davixcky/medidor-energia-esp32/freecad/planta-banco-base.png

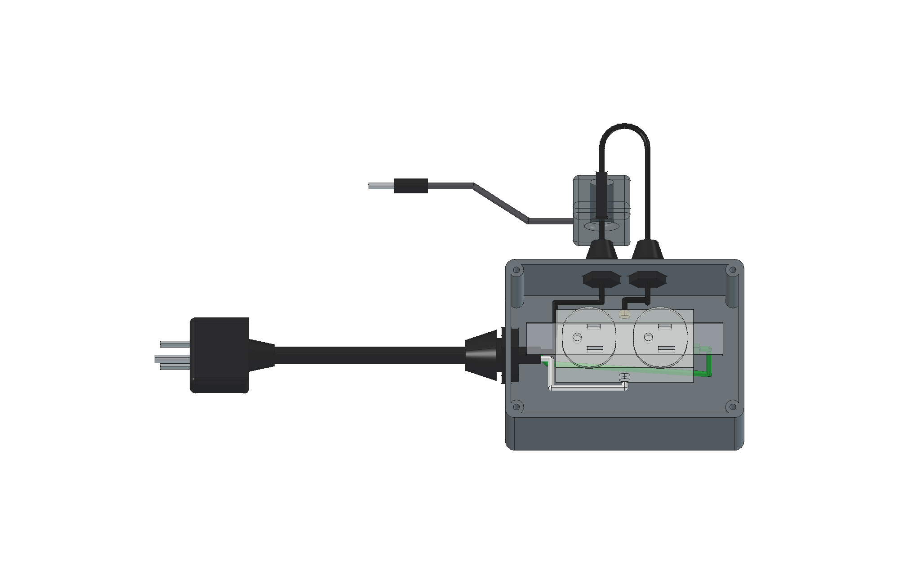
freecad/planta-banco-base.png
