davixcky/medidor-energia-esp32/freecad/revision-b/3d-medidor-abierto.png

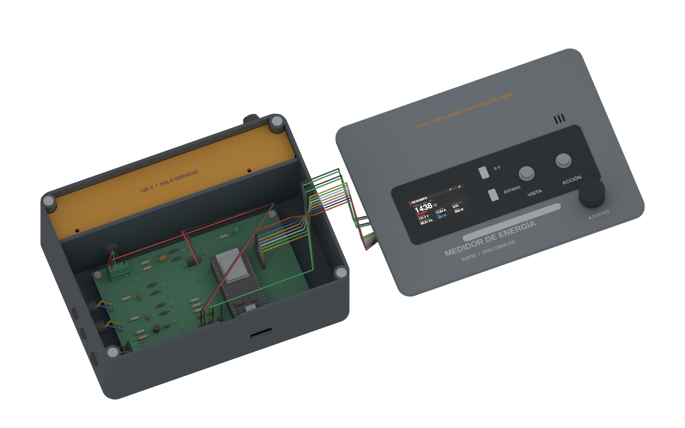
freecad/revision-b/3d-medidor-abierto.png
