davixcky/medidor-energia-esp32/img/lstm-ventanas.png

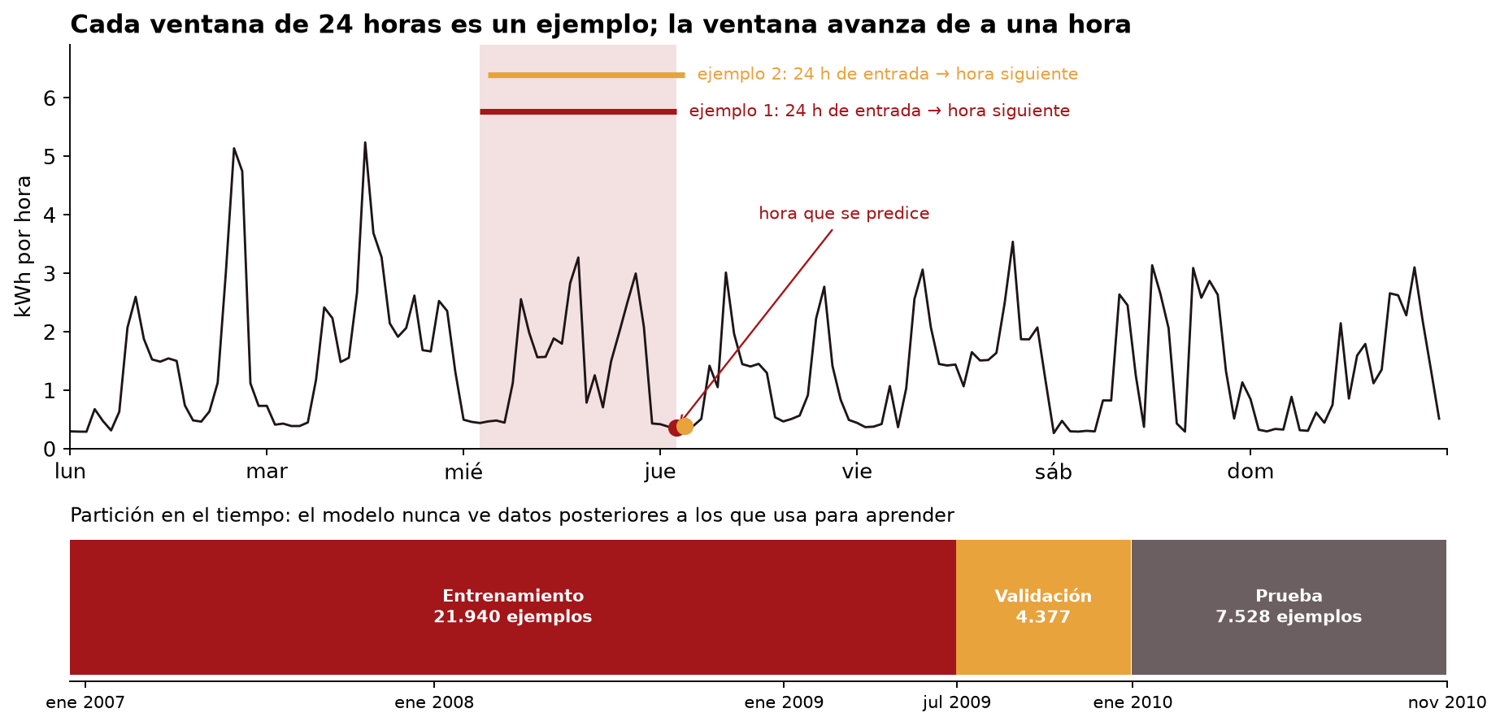
img/lstm-ventanas.png
