davixcky/medidor-energia-esp32/img/ui-lcd-alerta.png

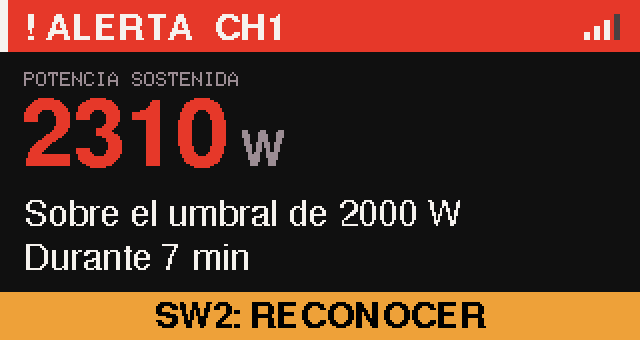
img/ui-lcd-alerta.png
