davixcky/medidor-energia-esp32/img/ui-lcd-arranque.png

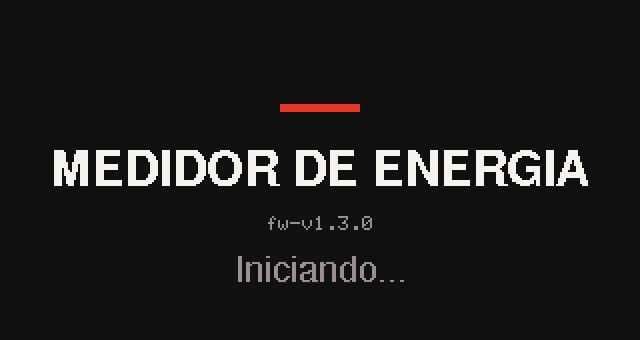
img/ui-lcd-arranque.png
