davixcky/medidor-energia-esp32/img/ui-lcd-ch1.png

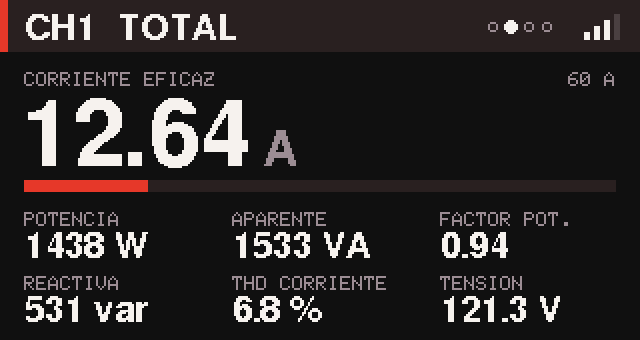
img/ui-lcd-ch1.png
