davixcky/medidor-energia-esp32/img/ui-lcd-ch2.png

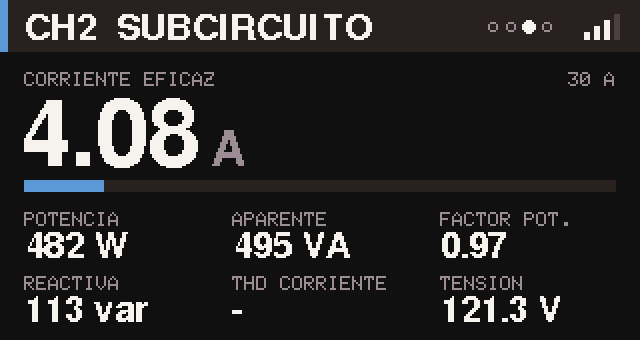
img/ui-lcd-ch2.png
