davixcky/medidor-energia-esp32/img/ui-lcd-energia.png

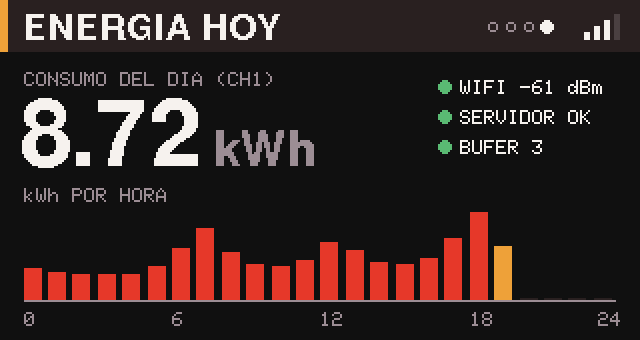
img/ui-lcd-energia.png
