davixcky/medidor-energia-esp32/img/ui-lcd-resumen.png

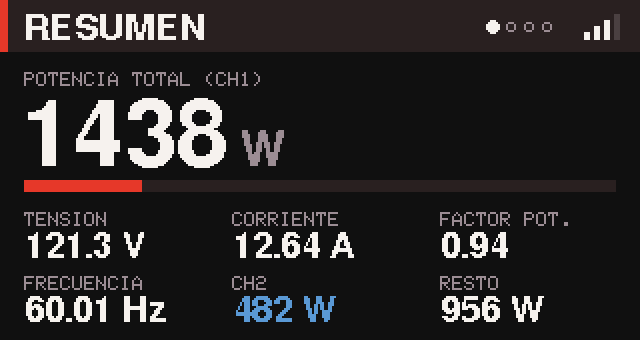
img/ui-lcd-resumen.png
