davixcky/medidor-energia-esp32/img/ui-lcd-tara.png

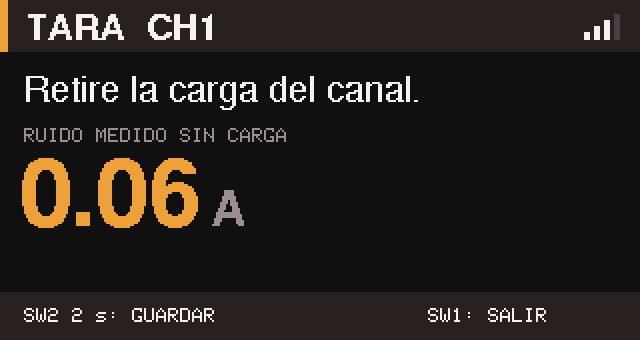
img/ui-lcd-tara.png
