davixcky/medidor-energia-esp32/img/ui-oled-navegacion.png

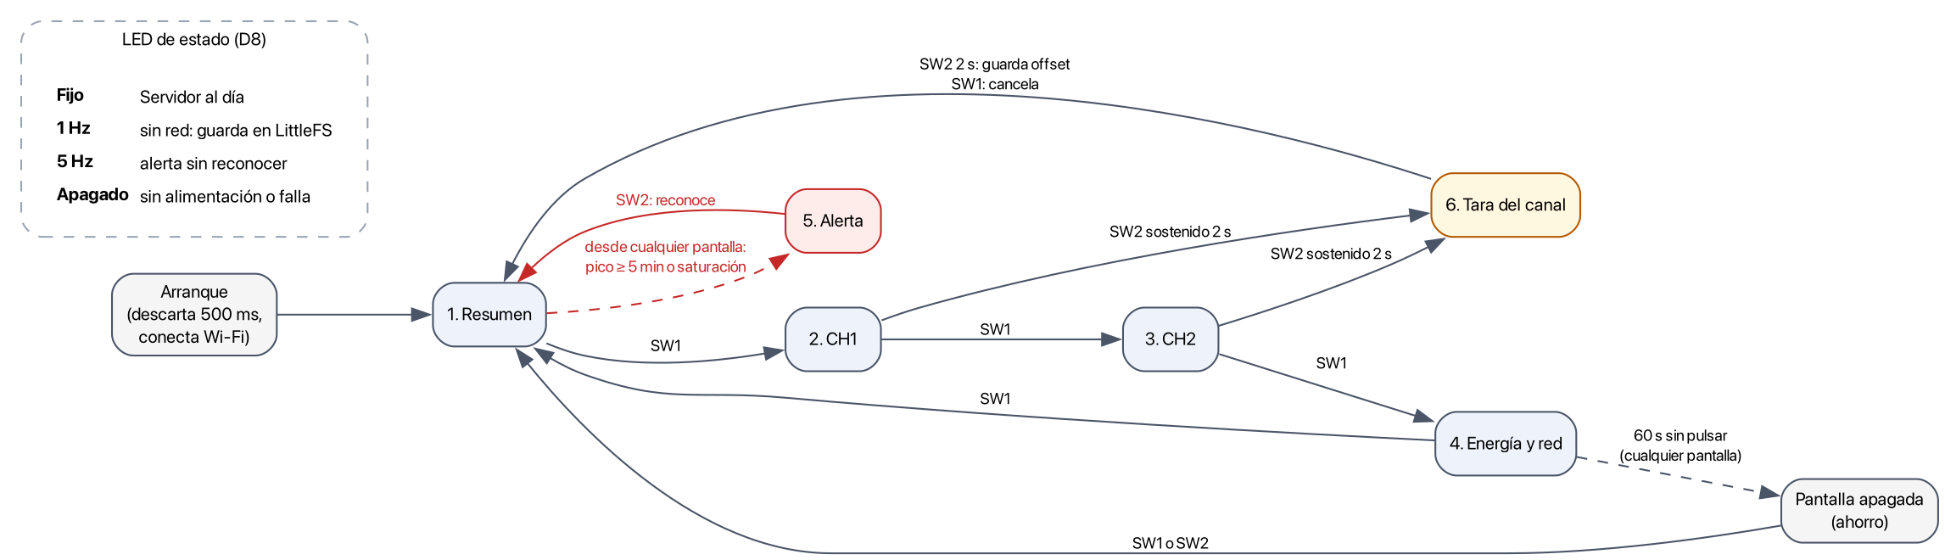
img/ui-oled-navegacion.png
