davixcky/medidor-energia-esp32/img/ui-oled-pantallas.png

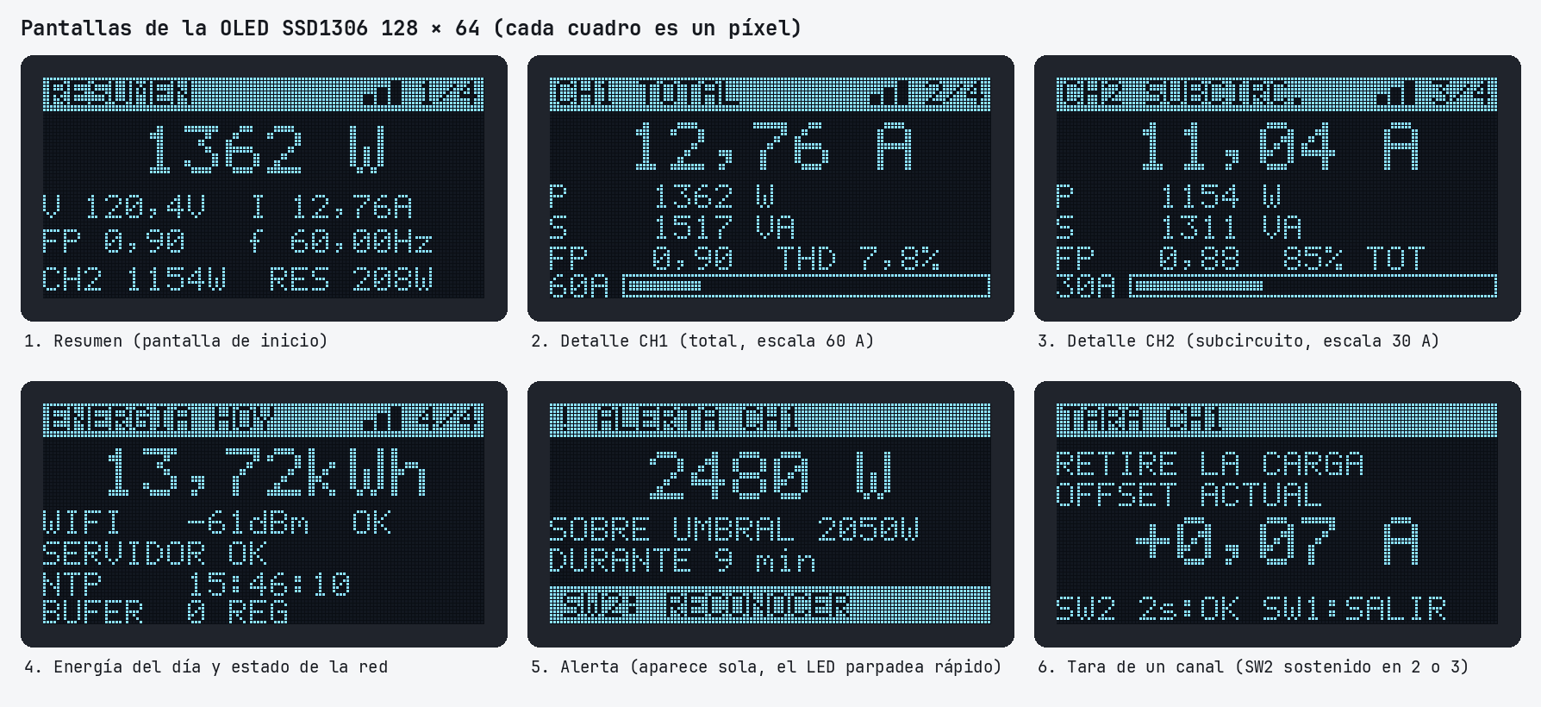
img/ui-oled-pantallas.png
