davixcky/medidor-energia-esp32/img/ui-tablero-oscuro.png

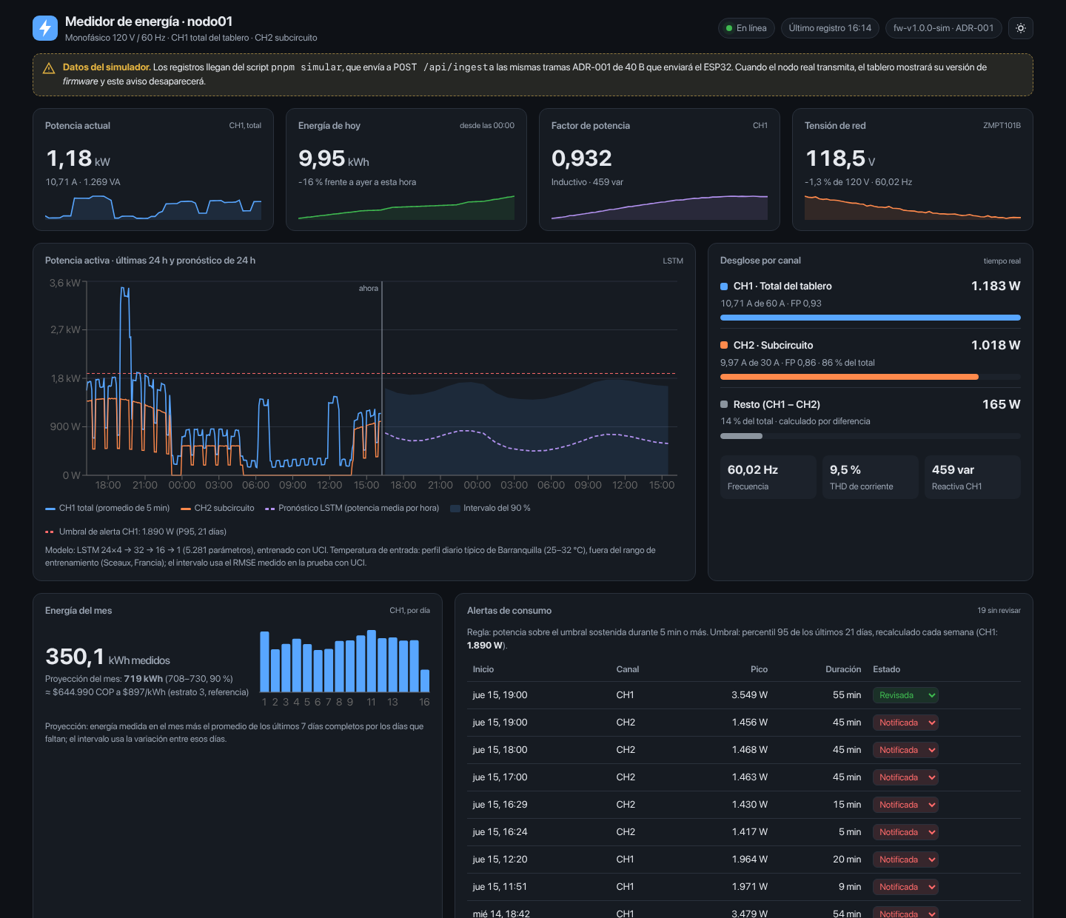
img/ui-tablero-oscuro.png
