davixcky/medidor-energia-esp32/video/revision-b/contacto-final.png

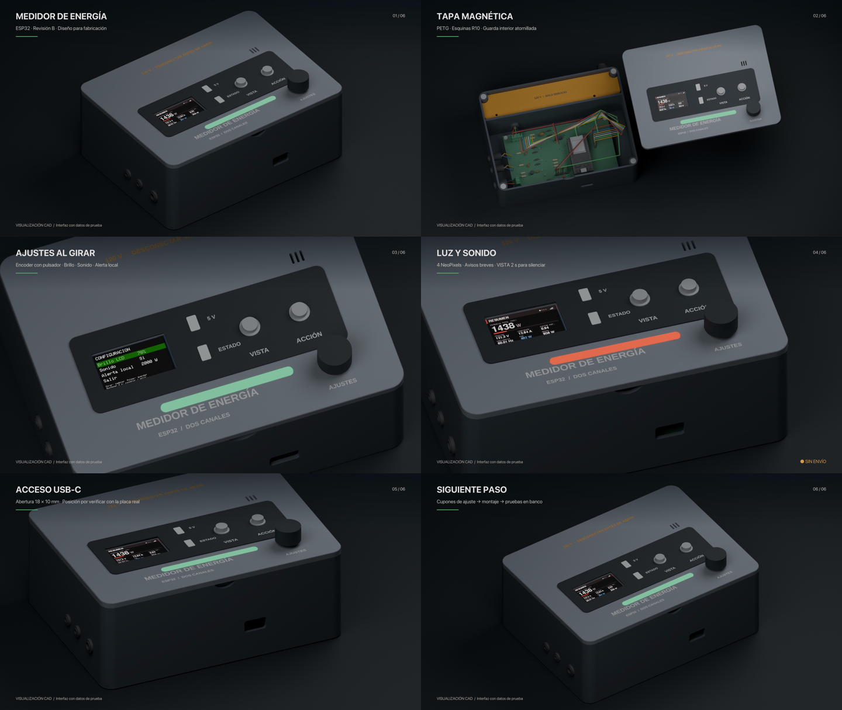
video/revision-b/contacto-final.png
