davixcky/medidor-energia-esp32/video/revision-b/sombra-titulos.png

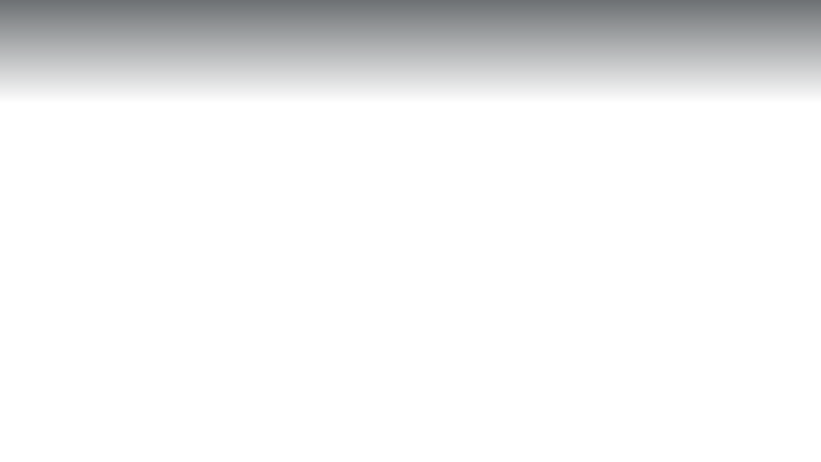
video/revision-b/sombra-titulos.png
