davixcky/medidor-energia-esp32/freecad/medidor.FCStd

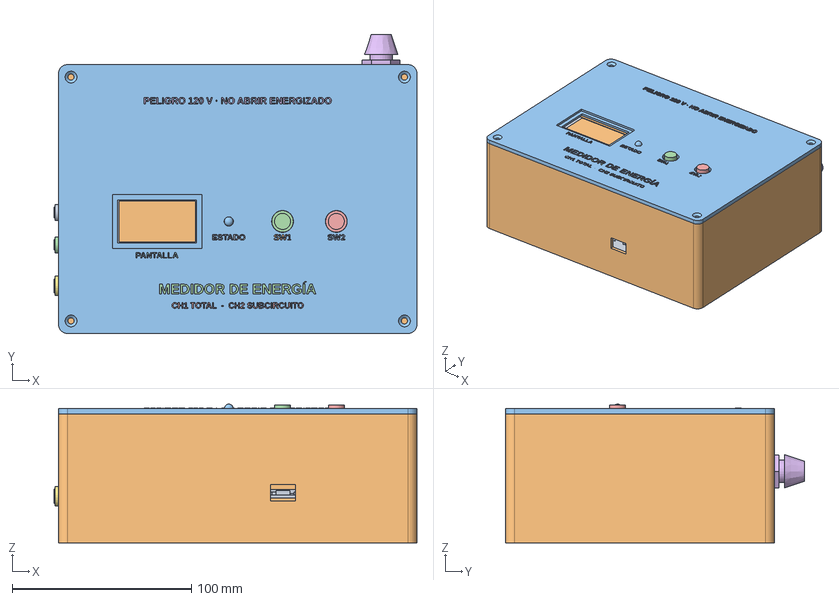
[picture p47: CAD file, 2026-10-24]
freecad/medidor.FCStd
202.5 x 166.8 x 77.5 mm
Placa_KiCad
Cuerpo
Tapa
Tornillo_ZMPT_0
Tornillo_ZMPT_1
Tornillo_ZMPT_2
Tornillo_ZMPT_3
ZMPT101B_PCB
ZMPT101B_trafo
ZMPT101B_bornes
ZMPT101B_pot
F1_portafusible
J4_bornera
PG7
Red_fase
Red_neutro
Red_fase_F1
Red_F1_ZMPT
Red_N_ZMPT
ZMPT_salida
Pasacables_tabique
ZMPT_J5_0
ZMPT_J5_1
ZMPT_J5_2
J2_CH1
Cable_J2_T
Cable_J2_S
J3_CH2
Cable_J3_T
Cable_J3_S
Jack_5V
Cable_J1_1
Cable_J1_2
Contacto_J1_1
Contacto_J1_2
Contacto_J5_1
Contacto_J5_2
Contacto_J5_3
Contacto_J6_1
Contacto_J6_2
Contacto_J6_3
Contacto_J6_4
Contacto_J6_5
Contacto_J6_6
Contacto_J6_7
Contacto_J6_8
Contacto_D8_1
Contacto_D8_2
Contacto_SW1_1
Contacto_SW1_2
Contacto_SW2_1
Contacto_SW2_2
Tornillo_placa_0
Tornillo_placa_1
Tornillo_placa_2
Tornillo_placa_3
LCD_modulo
LCD_pantalla
D8_LED
SW1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
