davixcky/medidor-energia-esp32/freecad/revision-b/stl/difusor-alimentacion.stl

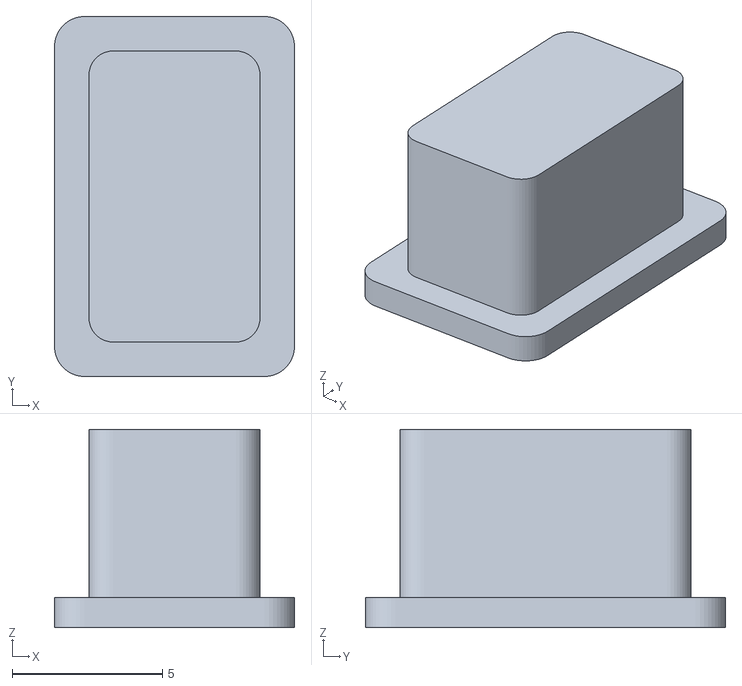
[picture p49: CAD file, 2026-10-23]
freecad/revision-b/stl/difusor-alimentacion.stl
8.00 x 12.0 x 6.60
