davixcky/medidor-energia-esp32/freecad/stl/medidor-tapa.stl

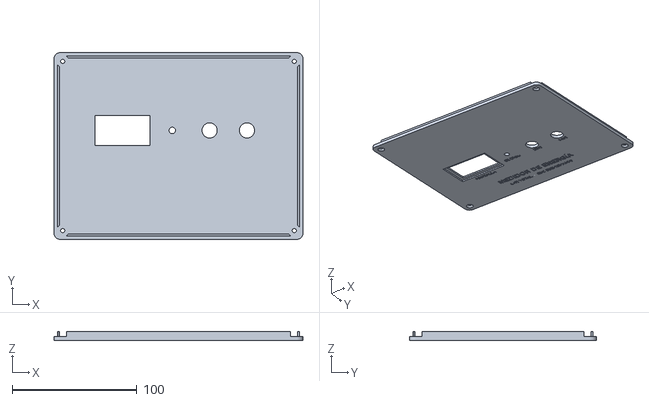
[picture p50: CAD file, 2026-10-22]
freecad/stl/medidor-tapa.stl
200.0 x 150.0 x 7.00
