davixcky/medidor-energia-esp32/hardware/3d/esp32-devkitc-v4.step

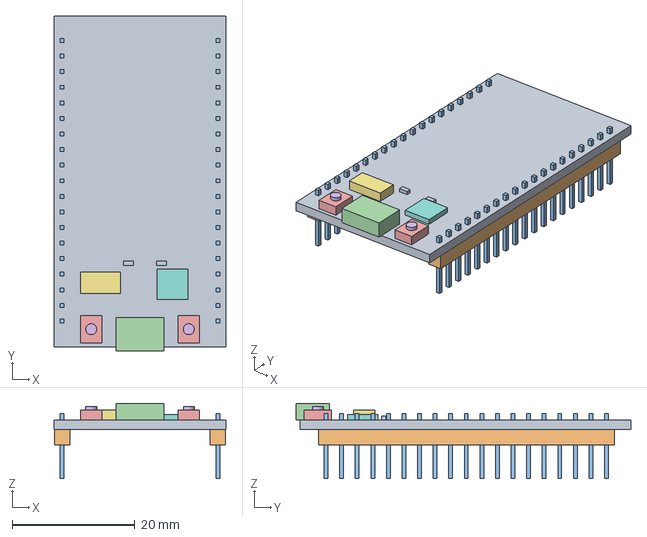
[picture p51: CAD file, 2026-10-16]
hardware/3d/esp32-devkitc-v4.step
28.0 x 54.6 x 12.3 mm
