davixcky/medidor-energia-esp32/freecad/banco.FCStd

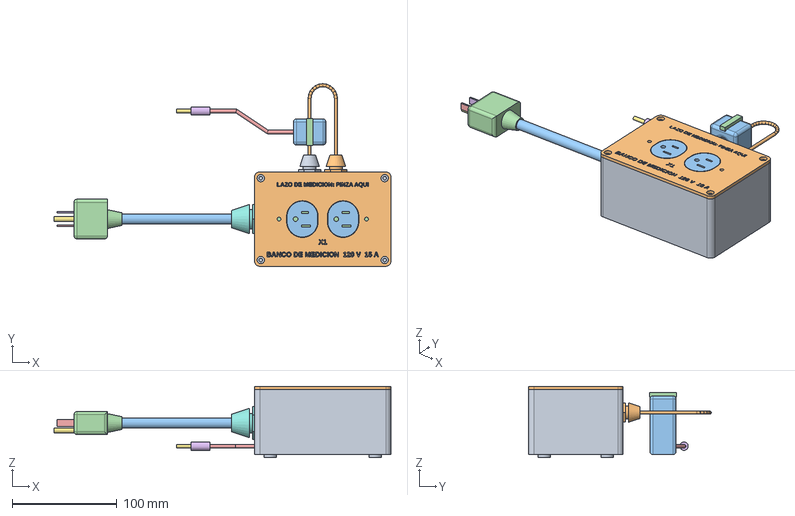
[picture p52: CAD file, 2026-10-24]
freecad/banco.FCStd
321.0 x 174.0 x 68.0 mm
Cuerpo
Tapa
X1_cuerpo
X1_yugo
X1_borne_fase
X1_borne_neutro
X1_borne_tierra
PG11
PG7_1
PG7_2
Cordon
P1_clavija
P1_pata_n
P1_pata_f
P1_pata_t
N_X1
PE_X1
L_lazo
CT1_pinza
CT1_cierre
CT1_cable
CT1_plug_cuerpo
CT1_plug_punta
