davixcky/medidor-energia-esp32/freecad/revision-b/stl/cuerpo.stl

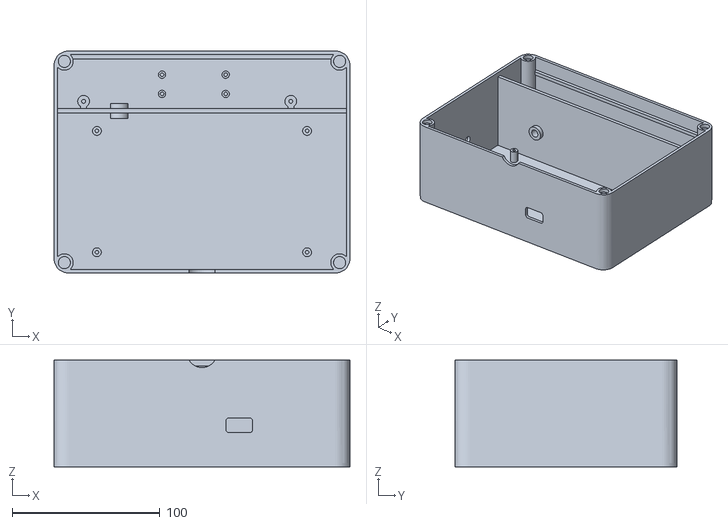
[picture p53: CAD file, 2026-10-23]
freecad/revision-b/stl/cuerpo.stl
200.0 x 150.0 x 72.0
