davixcky/medidor-energia-esp32/freecad/stl/banco-tapa.stl

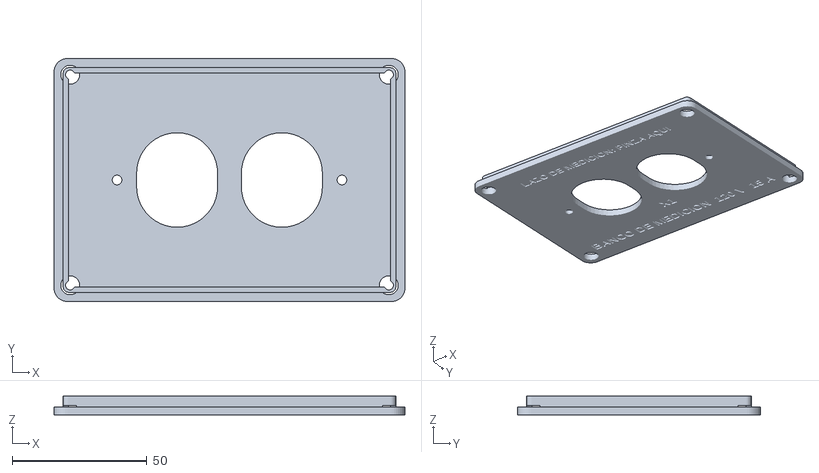
[picture p54: CAD file, 2026-10-21]
freecad/stl/banco-tapa.stl
130.0 x 90.0 x 7.00
