davixcky/medidor-energia-esp32/freecad/revision-b/stl/retenedor-lcd-i.stl

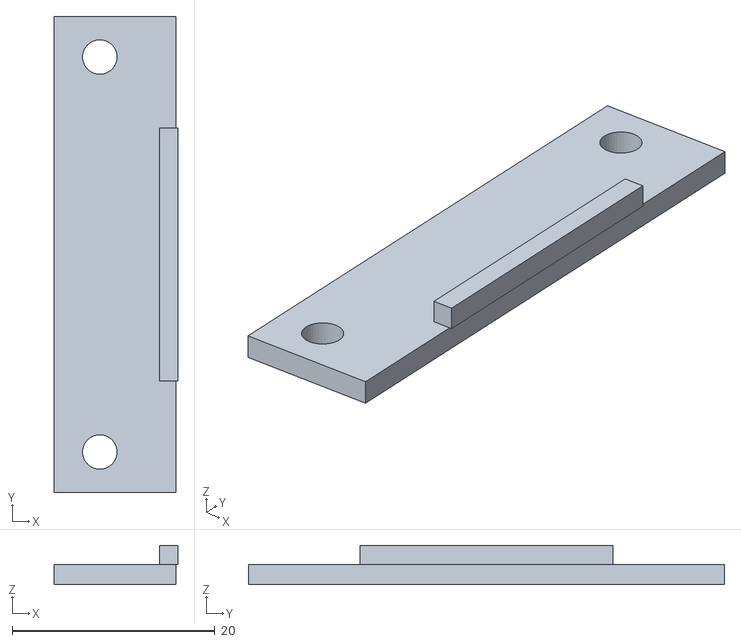
[picture p55: CAD file, 2026-10-23]
freecad/revision-b/stl/retenedor-lcd-i.stl
12.2 x 47.0 x 3.90
