davixcky/medidor-energia-esp32/freecad/stl/banco-cuerpo.stl

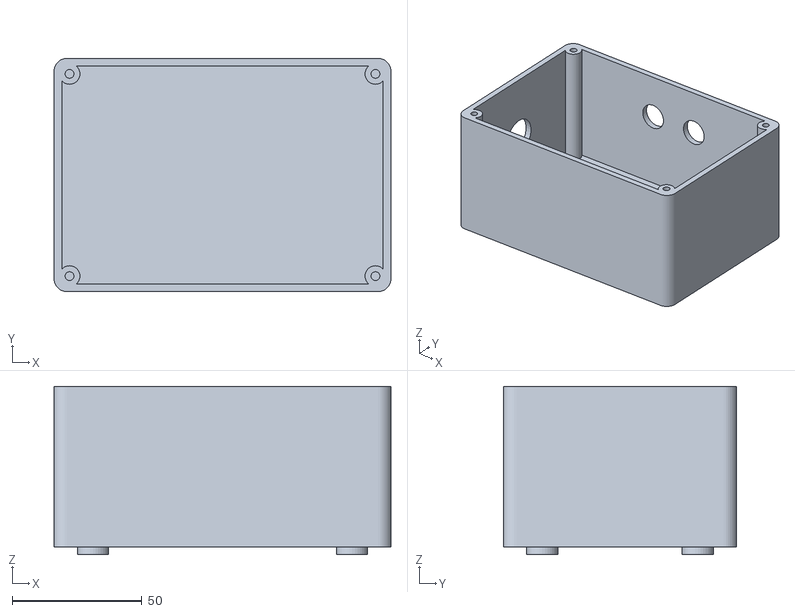
[picture p56: CAD file, 2026-10-16]
freecad/stl/banco-cuerpo.stl
130.0 x 90.0 x 65.0
