davixcky/medidor-energia-esp32/freecad/revision-b/stl/difusor-neopixel.stl

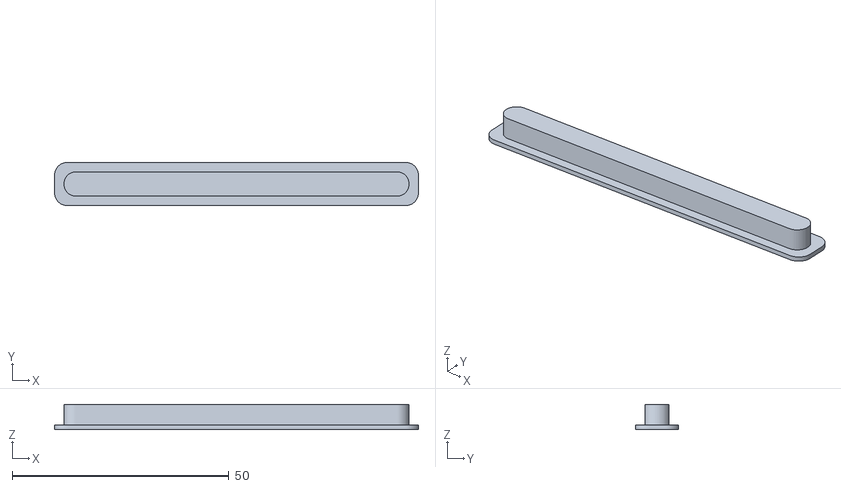
[picture p57: CAD file, 2026-10-23]
freecad/revision-b/stl/difusor-neopixel.stl
84.0 x 10.0 x 5.80
