davixcky/medidor-energia-esp32/freecad/revision-b/stl/porta-neopixel.stl

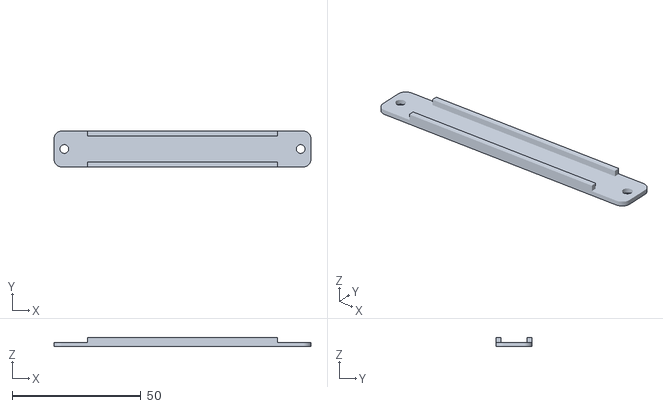
[picture p58: CAD file, 2026-10-23]
freecad/revision-b/stl/porta-neopixel.stl
100.0 x 14.0 x 3.60
