davixcky/medidor-energia-esp32/freecad/revision-b/stl/guarda-120v.stl

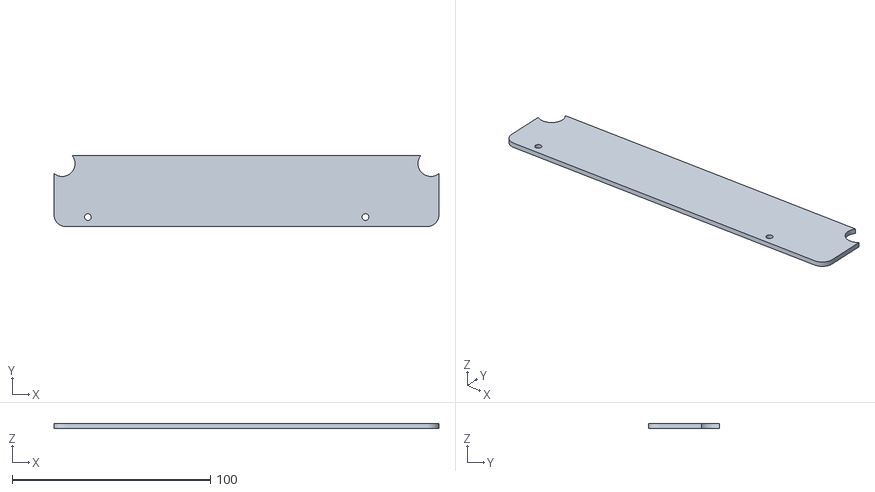
[picture p59: CAD file, 2026-10-23]
freecad/revision-b/stl/guarda-120v.stl
194.2 x 35.9 x 2.40
