davixcky/medidor-energia-esp32/freecad/revision-b/stl/tapa.stl

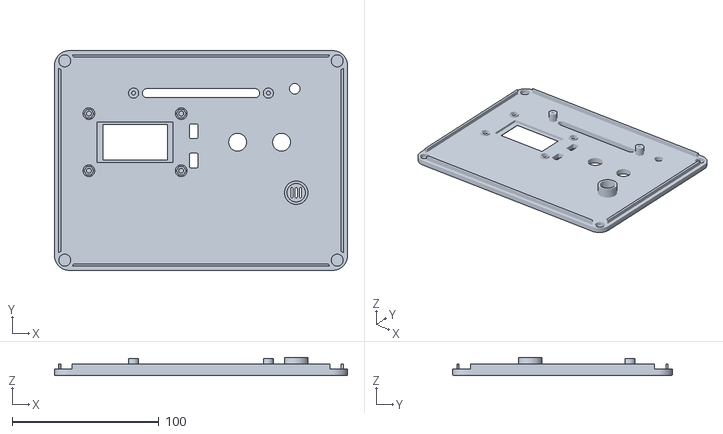
[picture p60: CAD file, 2026-10-23]
freecad/revision-b/stl/tapa.stl
200.0 x 150.0 x 12.6
