davixcky/medidor-energia-esp32/freecad/revision-b/stl/cupon-usbc.stl

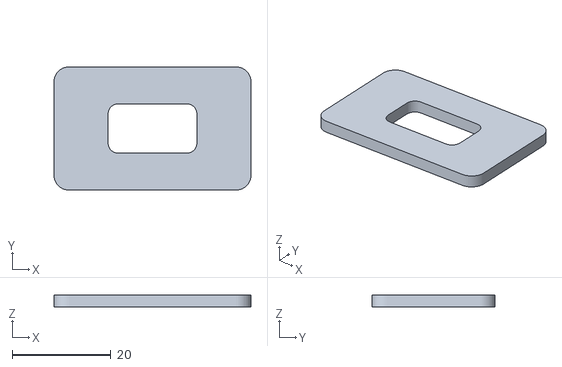
[picture p61: CAD file, 2026-10-23]
freecad/revision-b/stl/cupon-usbc.stl
40.0 x 25.0 x 2.50
