davixcky/medidor-energia-esp32/freecad/revision-b/stl/cupon-ajuste.stl

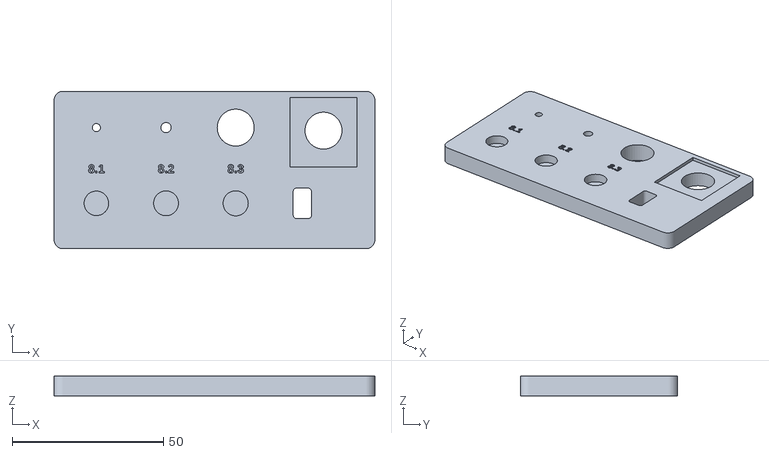
[picture p62: CAD file, 2026-10-23]
freecad/revision-b/stl/cupon-ajuste.stl
106.0 x 52.0 x 6.60
