davixcky/medidor-energia-esp32/freecad/revision-b/stl/panel.stl

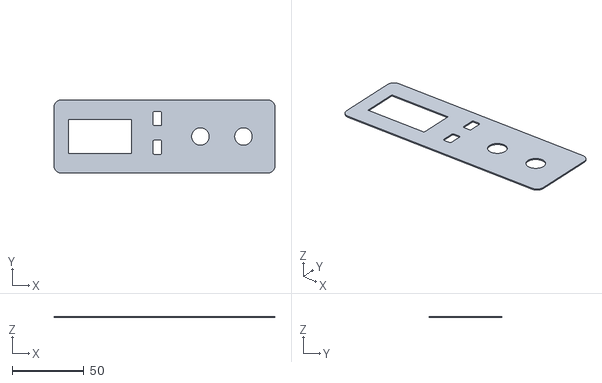
[picture p63: CAD file, 2026-10-23]
freecad/revision-b/stl/panel.stl
154.0 x 51.0 x 0.8
