davixcky/medidor-energia-esp32/freecad/revision-b/stl/retenedor-lcd-d.stl

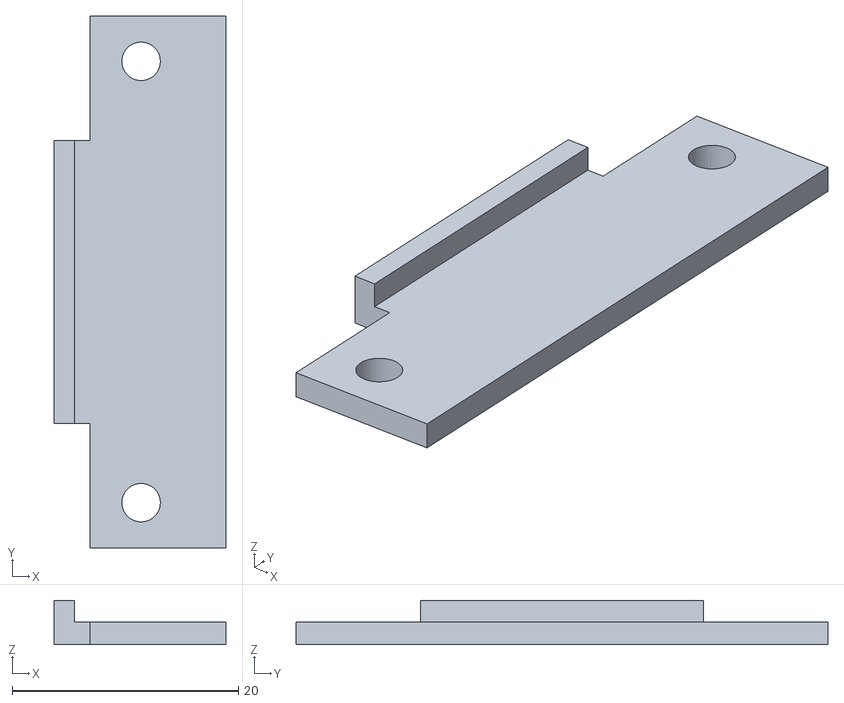
[picture p64: CAD file, 2026-10-23]
freecad/revision-b/stl/retenedor-lcd-d.stl
15.2 x 47.0 x 3.90
