davixcky/medidor-energia-esp32/freecad/revision-b/stl/cupon-encoder.stl

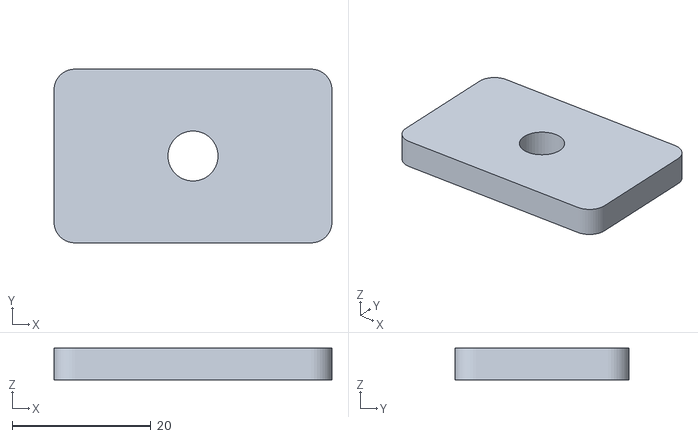
[picture p65: CAD file, 2026-10-23]
freecad/revision-b/stl/cupon-encoder.stl
40.0 x 25.0 x 4.60
