davixcky/medidor-energia-esp32/(list of files, cad)

Other CAD files:
freecad/stl/medidor-cuerpo.stl
freecad/revision-b/stl/difusor-estado.stl
