davixcky/medidor-energia-esp32/hardware/fabricacion/vista-toner.png

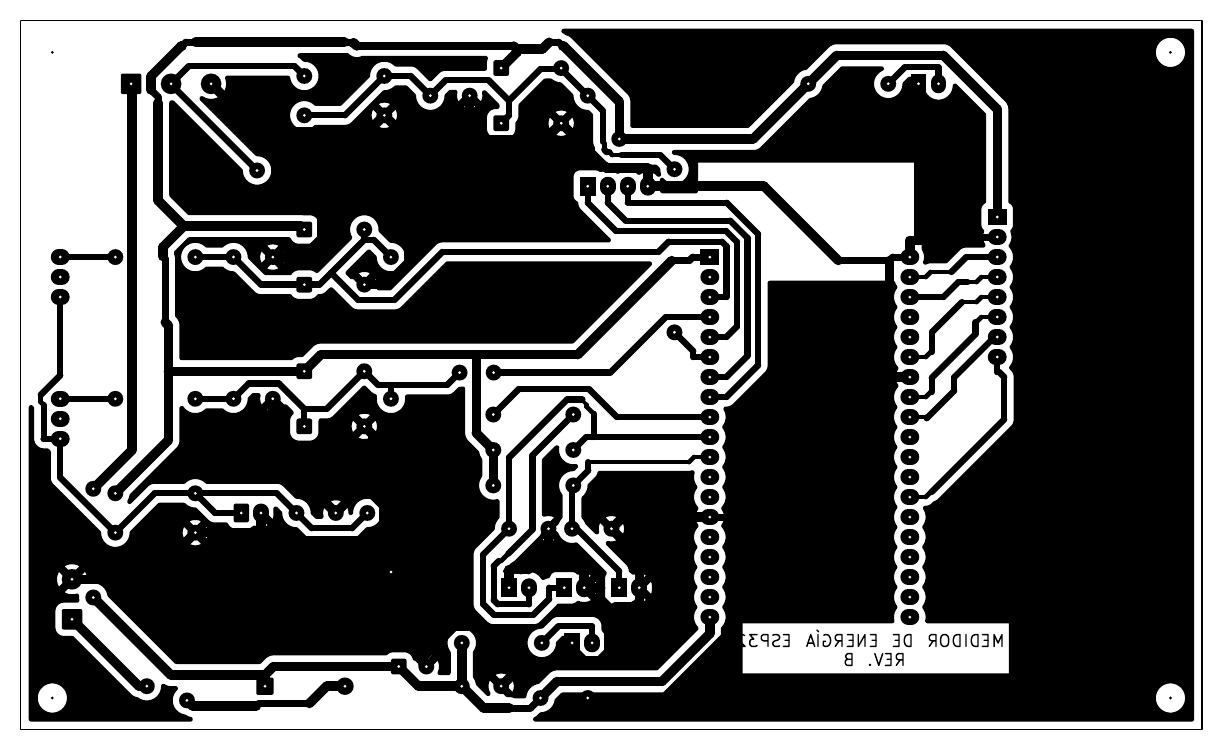
hardware/fabricacion/vista-toner.png
