davixcky/medidor-energia-esp32/hardware/banco-pruebas.pdf

1 | 2 | 3 | 4 | 5 | 6

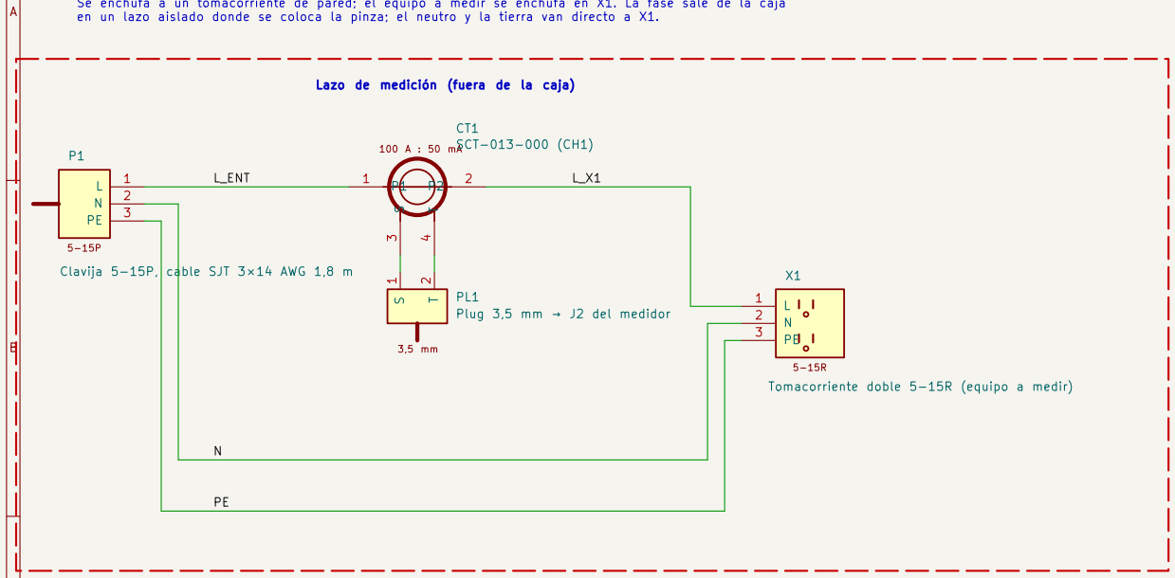
[picture p67: figure]
SCT-013-000 (CH1); T 2 PL1 Plug 3,5 mm → J2 del medidor N

1 | 2 | 3 | 4 | 5 | 6

C

D

AB

C

### D Date: 2026-10-21 KiCad E.D.A. 10.0.0

Size: A4 | Rev: B
| Id: 1/1

## Title: Banco de medición con tomacorriente de entrada y salida

### File: banco-pruebas.kicad_sch

### Sheet: /

### Complemento del medidor de energía de dos canales

Tomacorriente doble 5-15R (equipo a medir) 5-15PL | 1 N
2 PE | 3 P1 Clavija 5-15P, | cable SJT 3×14 AWG 1,8 m
L_ENT | L_X1 BANCO DE MEDICIÓN — 120 V CA, 60 Hz, 15 A máx.

Se enchufa a un tomacorriente de pared; el equipo a medir se enchufa en X1. La fase sale de la caja en un lazo aislado donde se coloca la pinza; el neutro y la tierra van directo a X1. Lazo de medición (fuera de la caja) NOTAS

1. Solo la fase pasa por la pinza, una sola vez: el lazo exterior es un tramo de THHN 14 AWG negro que sale y vuelve a entrar a la caja por dos prensaestopas PG7. El neutro y la tierra nunca pasan por la pinza (las corrientes se cancelarían).
2. La pinza se conecta a J2 (CH1) del medidor; la calibración es la misma que en un tablero (una pasada).
3. Conductores 14 AWG: fase negro, neutro blanco, tierra verde. Tomacorriente polarizado: fase al tornillo de bronce
(ranura corta), neutro al plateado (ranura larga), tierra al verde. 4. La protección es el breaker del circuito de pared (15 A). El medidor se alimenta de otro tomacorriente de pared.
5. El lazo también admite una pinza amperimétrica comercial, útil para calibrar el canal.
