davixcky/medidor-energia-esp32/hardware/medidor-energia.pdf

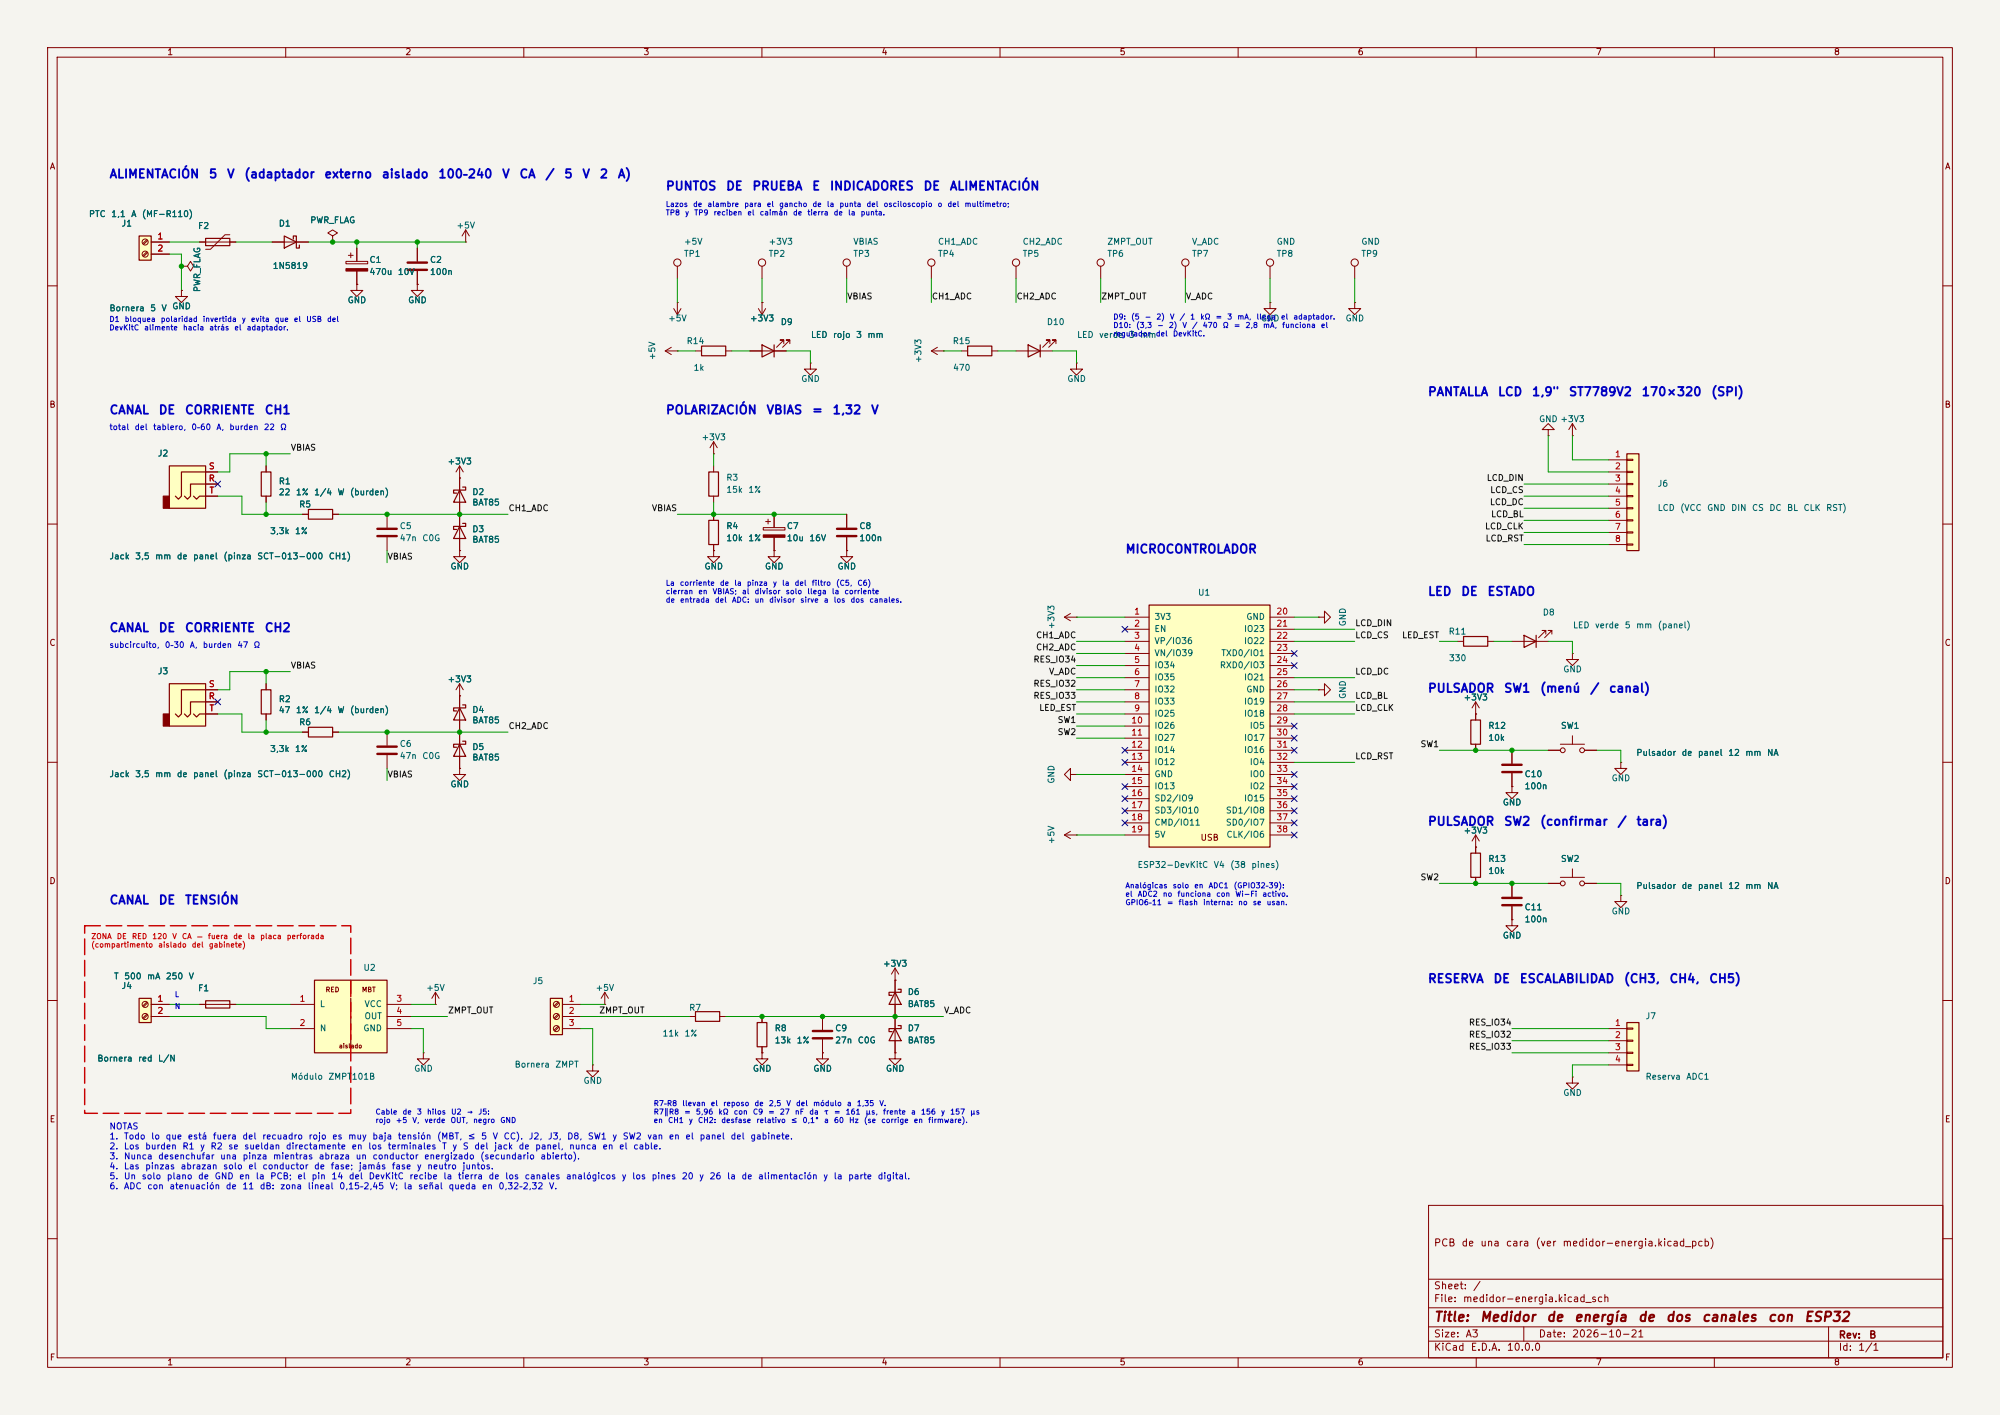
[picture p68: page 1]

ALIMENTACIÓN 5 V (adaptador externo aislado 100–240 V CA / 5 V 2 A)

Lazos de alambre para el gancho de la punta del osciloscopio o del multímetro; TP8 y TP9 reciben el caimán de tierra de la punta. PUNTOS DE PRUEBA E INDICADORES DE ALIMENTACIÓN
TP2 +3V3 GND
ZMPT_OUT RES_IO34

LED verde 5 mm (panel) D1

total del tablero, 0–60 A, burden 22 Ω

Jack 3,5 mm de panel (pinza SCT-013-000 CH1) R

LCD (VCC GND DIN CS DC BL CLK RST) D8

subcircuito, 0–30 A, burden 47 Ω CANAL DE CORRIENTE CH2

PULSADOR SW1 (menú / canal) NOTAS
Jack 3,5 mm de panel (pinza SCT-013-000 CH2) R

Jack 3,5 mm de panel (pinza SCT-013-000 CH2) R6

ZONA DE RED 120 V CA — fuera de la placa perforada
(compartimento aislado del gabinete)

Cable de 3 hilos U2 → J5: rojo +5 V, verde OUT, negro GND

R7–R8 llevan el reposo de 2,5 V del módulo a 1,35 V. R7‖R8 = 5,96 kΩ con C9 = 27 nF da τ = 161 µs, frente a 156 y 157 µs en CH1 y CH2: desfase relativo ≤ 0,1° a 60 Hz (se corrige en firmware).

1. Todo lo que está fuera del recuadro rojo es muy baja tensión (MBT, ≤ 5 V CC). J2, J3, D8, SW1 y SW2 van en el panel del gabinete.
2. Los burden R1 y R2 se sueldan directamente en los terminales T y S del jack de panel, nunca en el cable. 3. Nunca desenchufar una pinza mientras abraza un conductor energizado (secundario abierto).

4. Las pinzas abrazan solo el conductor de fase; jamás fase y neutro juntos.
5. Un solo plano de GND en la PCB; el pin 14 del DevKitC recibe la tierra de los canales analógicos y los pines 20 y 26 la de alimentación y la parte digital.
6. ADC con atenuación de 11 dB: zona lineal 0,15–2,45 V; la señal queda en 0,32–2,32 V.

PCB de una cara (ver medidor-energia.kicad_pcb)

Sheet: /
File: medidor-energia.kicad_sch
Title: Medidor de energía de dos canales con ESP32

Size: A3 | Rev: B | F Date: 2026-10-21 KiCad E.D.A. 10.0.0
