davixcky/medidor-energia-esp32/hardware/fabricacion/vista-cobre-desde-abajo.pdf

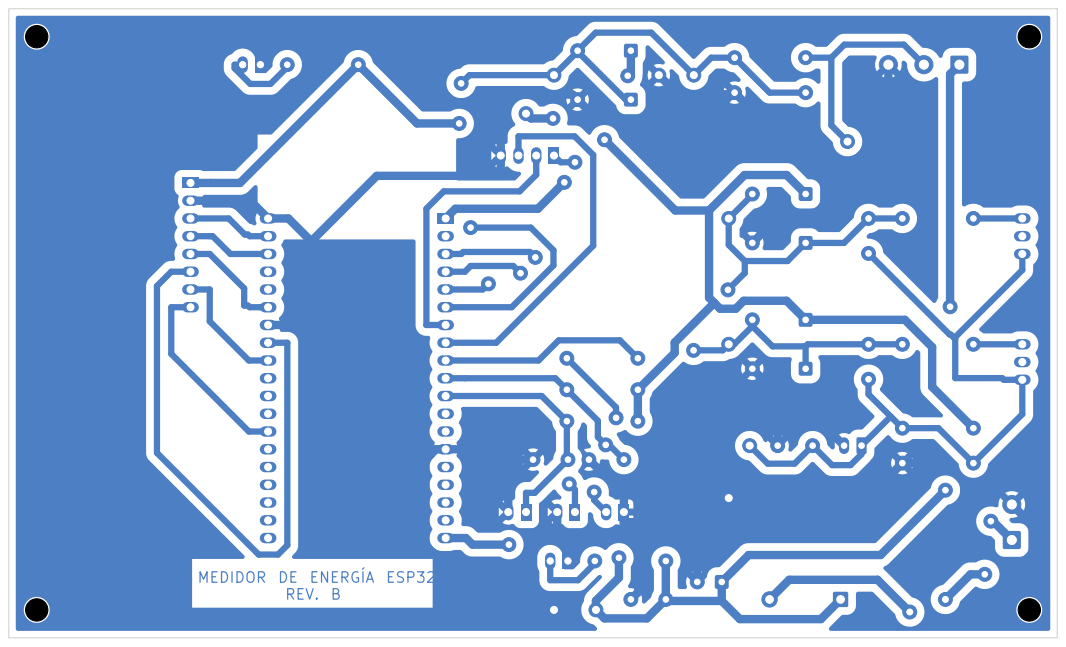
[picture p69: page 1]

MEDIDOR DE ENERGÍA ESP32 REV. B
