davixcky/medidor-energia-esp32/hardware/fabricacion/toner/1-cobre-B_Cu-1a1.pdf

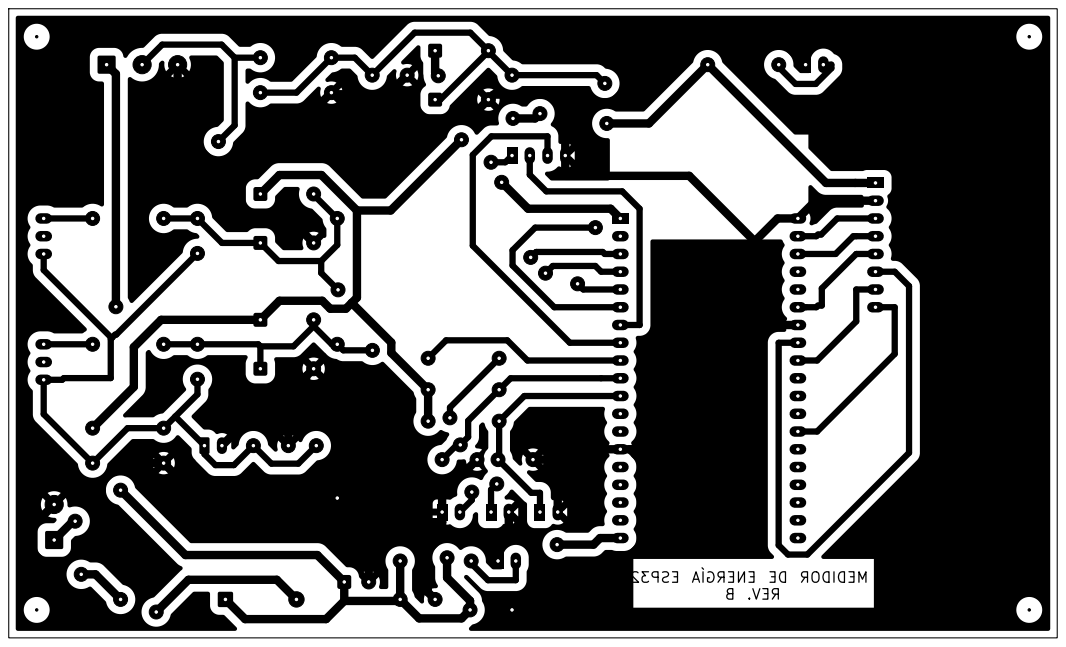
[picture p70: page 1]

ESP32 ENERGÍA DE MEDIDOR B REV.
