davixcky/medidor-energia-esp32/hardware/fabricacion/guia-montaje.pdf

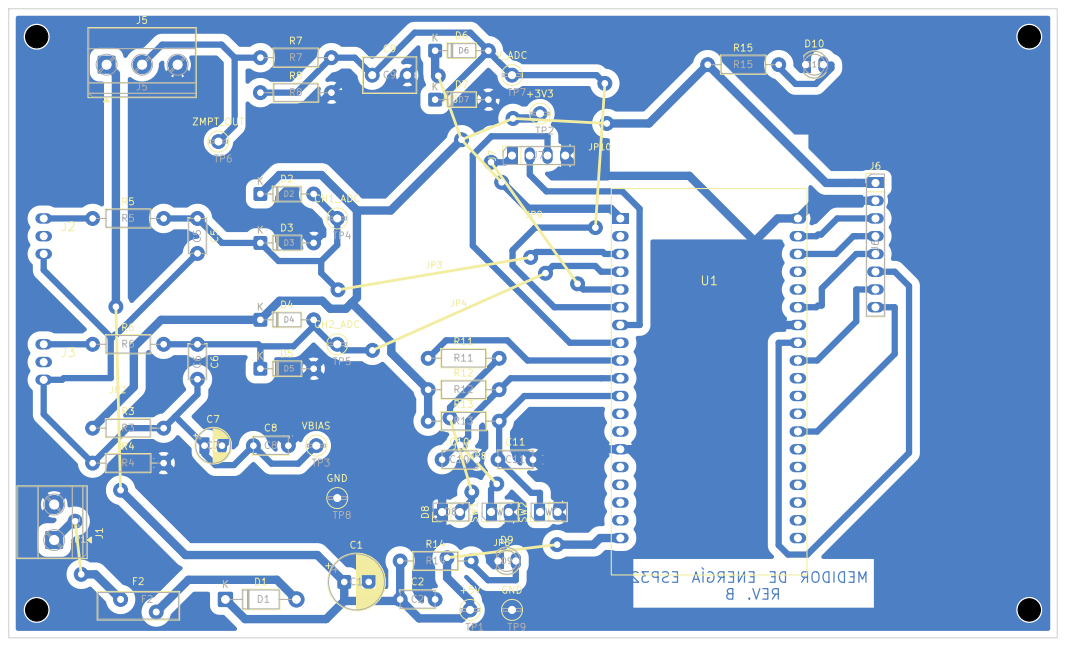
[picture p71: page 1]
