davixcky/medidor-energia-esp32/hardware/fabricacion/toner/2-serigrafia-F_SilkS-espejo-1a1.pdf

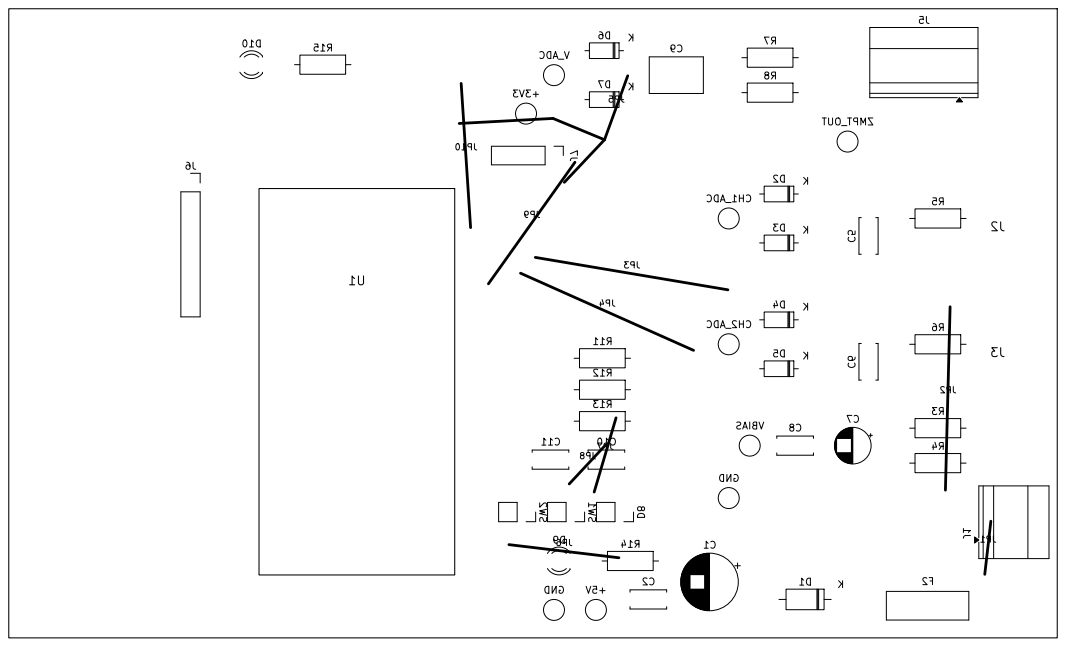
[picture p72: page 1]
