davixcky/medidor-energia-esp32/hardware/medidor-energia.kicad_pcb

## KiCad design hardware/medidor-energia.kicad_pcb (2026-10-22)

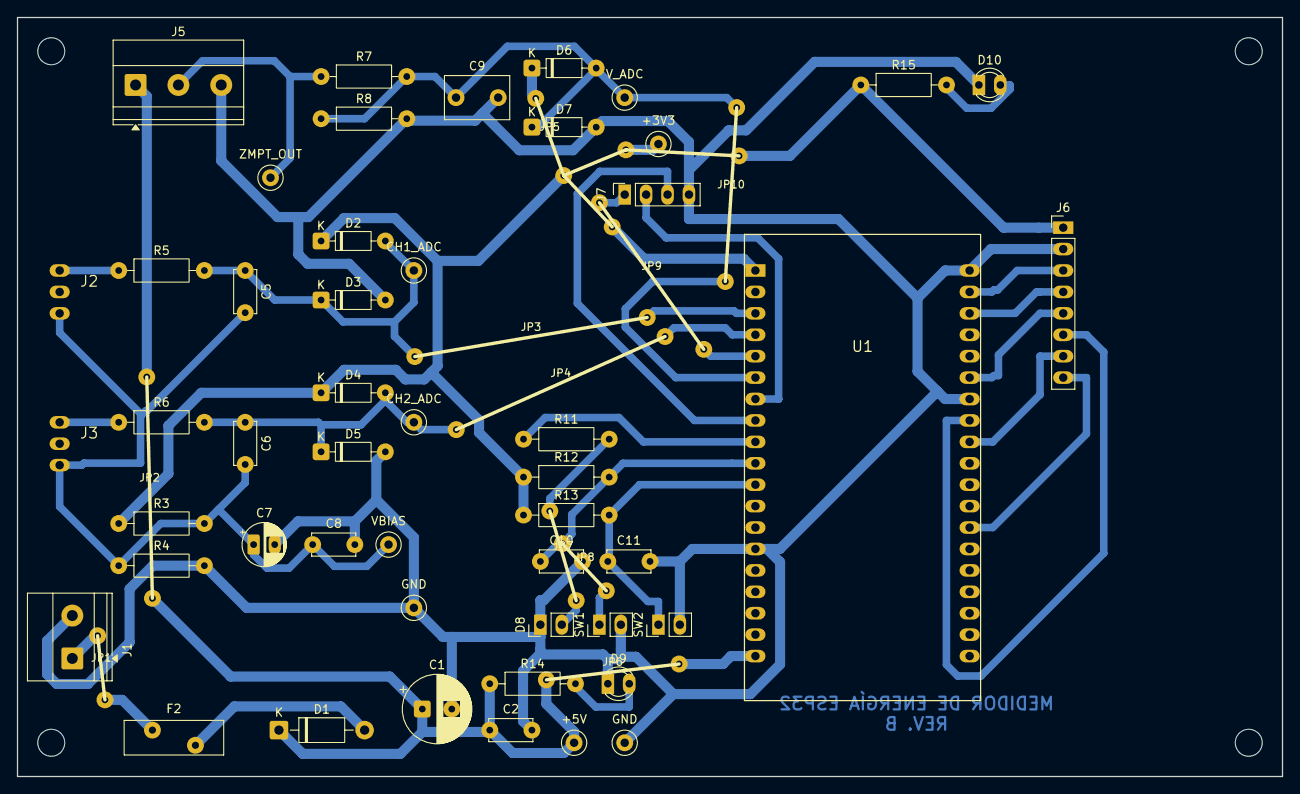
[picture p73: board medidor-energia.kicad_pcb from above]

Board: 2 copper layers, 150.0 x 90.0 mm, 63 parts (0 on the bottom side), 27 nets.

Parts:
C1: 470u 10V; CP_Radial_D8.0mm_P3.50mm
C2, C8, C10, C11: 100n; C_Disc_D5.0mm_W2.5mm_P5.00mm
C5, C6: 47n C0G; C_Disc_D5.0mm_W2.5mm_P5.00mm
C7: 10u 16V; CP_Radial_D5.0mm_P2.50mm
C9: 27n C0G; C_Disc_D7.5mm_W5.0mm_P5.00mm
D1: 1N5819; D_DO-41_SOD81_P10.16mm_Horizontal
D2, D3, D4, D5, D6, D7: BAT85; D_DO-35_SOD27_P7.62mm_Horizontal
D8: LED verde 5 mm (panel); PinHeader_1x02_P2.54mm_Vertical
D9: LED rojo 3 mm; LED_D3.0mm
D10: LED verde 3 mm; LED_D3.0mm
F2: PTC 1,1 A (MF-R110); Fuse_BelFuse_0ZRE0040FF_L11.5mm_W3.8mm
H1, H2, H3, H4: MountingHole_3.2mm_M3
J1: Bornera 5 V; TerminalBlock_Phoenix_MKDS-1,5-2-5.08_1x02_P5.08mm_Horizont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
J2: Jack 3,5 mm de panel (pinza SCT-013-000 CH1); Cable_Jack_Panel
J3: Jack 3,5 mm de panel (pinza SCT-013-000 CH2); Cable_Jack_Panel
J5: Bornera ZMPT; TerminalBlock_Phoenix_MKDS-1,5-3-5.08_1x03_P5.08mm_Horizont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
J6: LCD (VCC GND DIN CS DC BL CLK RST); PinHeader_1x08_P2.54mm_Vertical
J7: Reserva ADC1; PinSocket_1x04_P2.54mm_Vertical
JP1, JP2, JP3, JP4, JP5, JP6, JP7, JP8, JP9, JP10: puente; Puente_alambre
R3: 15k 1%; R_Axial_DIN0207_L6.3mm_D2.5mm_P10.16mm_Horizontal
R4: 10k 1%; R_Axial_DIN0207_L6.3mm_D2.5mm_P10.16mm_Horizontal
R5, R6: 3,3k 1%; R_Axial_DIN0207_L6.3mm_D2.5mm_P10.16mm_Horizontal
R7: 11k 1%; R_Axial_DIN0207_L6.3mm_D2.5mm_P10.16mm_Horizontal
R8: 13k 1%; R_Axial_DIN0207_L6.3mm_D2.5mm_P10.16mm_Horizontal
R11: 330; R_Axial_DIN0207_L6.3mm_D2.5mm_P10.16mm_Horizontal
R12, R13: 10k; R_Axial_DIN0207_L6.3mm_D2.5mm_P10.16mm_Horizontal
R14: 1k; R_Axial_DIN0207_L6.3mm_D2.5mm_P10.16mm_Horizontal
R15: 470; R_Axial_DIN0207_L6.3mm_D2.5mm_P10.16mm_Horizontal
SW1, SW2: Pulsador de panel 12 mm NA; PinHeader_1x02_P2.54mm_Vertical
TP1: +5V; TestPoint_Loop_D2.50mm_Drill1.0mm
TP2: +3V3; TestPoint_Loop_D2.50mm_Drill1.0mm
TP3: VBIAS; TestPoint_Loop_D2.50mm_Drill1.0mm
TP4: CH1_ADC; TestPoint_Loop_D2.50mm_Drill1.0mm
TP5: CH2_ADC; TestPoint_Loop_D2.50mm_Drill1.0mm
TP6: ZMPT_OUT; TestPoint_Loop_D2.50mm_Drill1.0mm
TP7: V_ADC; TestPoint_Loop_D2.50mm_Drill1.0mm
TP8, TP9: GND; TestPoint_Loop_D2.50mm_Drill1.0mm
U1: ESP32-DevKitC V4 (38 pines); ESP32-DevKitC-38_Zocalo

Connections:
+3V3: D2.1, D4.1, D6.1, J6.1, JP5.1, R3.1, R12.1, R13.1, R15.1, TP2.1, U1.1
+5V: C1.1, C2.1, D1.1, J5.1, JP2.1, JP6.1, R14.1, TP1.1, U1.19
/CH1_ADC: C5.1, D2.2, D3.1, JP3.1, R5.2, TP4.1, U1.3
/CH2_ADC: C6.1, D4.2, D5.1, JP4.1, R6.2, TP5.1, U1.4
/LCD_BL: J6.6, U1.27
/LCD_CLK: J6.7, U1.28
/LCD_CS: J6.4, U1.22
/LCD_DC: J6.5, U1.25
/LCD_DIN: J6.3, U1.21
/LCD_RST: J6.8, U1.32
/LED_EST: R11.1, U1.9
/RES_IO32: J7.2, U1.7
/RES_IO33: J7.3, U1.8
/RES_IO34: J7.1, JP9.1, U1.5
/SW1: C10.1, JP8.1, R12.2, SW1.1, U1.10
/SW2: C11.1, R13.2, SW2.1, U1.11
/VBIAS: C5.2, C6.2, C7.1, C8.1, J2.S, J3.S, R3.2, R4.1, TP3.1
/V_ADC: C9.1, D6.2, D7.1, JP10.1, R7.2, R8.1, TP7.1, U1.6
/ZMPT_OUT: J5.2, R7.1, TP6.1
GND: C1.2, C2.2, C7.2, C8.2, C9.2, C10.2, C11.2, D3.2, D5.2, D7.2, D8.1, D9.1, D10.1, J1.2, J5.3, J6.2, J7.4, R4.2, R8.2, SW1.2, SW2.2, TP8.1, TP9.1, U1.14, U1.20, U1.26
unnamed: D1.2, F2.2
unnamed: D8.2, JP7.1, R11.2
unnamed: D9.2, R14.2
unnamed: D10.2, R15.2
unnamed: F2.1, J1.1, JP1.1
unnamed: J2.T, R5.1
unnamed: J3.T, R6.1
