davixcky/medidor-energia-esp32/plataforma/pnpm-lock.yaml

lockfileVersion: '9.0'

settings:
  autoInstallPeers: true
  excludeLinksFromLockfile: false

importers:

  .:
    dependencies:
      '@electric-sql/pglite':
        specifier: 0.5.11
        version: 0.5.11
      '@electric-sql/pglite-socket':
        specifier: 0.2.14
        version: 0.2.14(@electric-sql/pglite-age@0.0.12(@electric-sql/pglite@0.5.11))(@electric-sql/pglite-pg_hashids@0.0.12(@electric-sql/pglite@0.5.11))(@electric-sql/pglite-pg_ivm@0.0.12(@electric-sql/pglite@0.5.11))(@electric-sql/pglite-pg_textsearch@0.0.13(@electric-sql/pglite@0.5.11))(@electric-sql/pglite-pg_uuidv7@0.0.12(@electric-sql/pglite@0.5.11))(@electric-sql/pglite-pgtap@0.0.12(@electric-sql/pglite@0.5.11))(@electric-sql/pglite-pgvector@0.0.12(@electric-sql/pglite@0.5.11))(@electric-sql/pglite@0.5.11)
      '@tanstack/react-router':
        specifier: 1.170.44
        version: 1.170.44(react-dom@19.3.1(react@19.3.1))(react@19.3.1)
      '@tanstack/react-start':
        specifier: 1.169.2
        version: 1.169.2(react-dom@19.3.1(react@19.3.1))(react@19.3.1)(rolldown@1.2.14)(vite@8.3.4(@types/node@22.20.5)(jiti@2.7.0))
      nitro:
        specifier: 3.0.260610-beta
        version: 3.0.260610-beta(@electric-sql/pglite@0.5.11)(chokidar@5.0.0)(jiti@2.7.0)(vite@8.3.4(@types/node@22.20.5)(jiti@2.7.0))
      postgres:
        specifier: 3.4.9
        version: 3.4.9
      react:
        specifier: 19.3.1
        version: 19.3.1
      react-dom:
        specifier: 19.3.1
        version: 19.3.1(react@19.3.1)
      recharts:
        specifier: 3.10.1
        version: 3.10.1(@types/react@19.3.0)(react-dom@19.3.1(react@19.3.1))(react-is@19.3.1)(react@19.3.1)(redux@5.0.1)
    devDependencies:
      '@tanstack/router-cli':
        specifier: 1.167.44
        version: 1.167.44
      '@types/node':
        specifier: 22.20.5
        version: 22.20.5
      '@types/react':
        specifier: 19.3.0
        version: 19.3.0
      '@types/react-dom':
        specifier: 19.3.0
        version: 19.3.0(@types/react@19.3.0)
      '@vitejs/plugin-react':
        specifier: 6.1.2
        version: 6.1.2(vite@8.3.4(@types/node@22.20.5)(jiti@2.7.0))
      playwright-core:
        specifier: 1.64.1
        version: 1.64.1
      typescript:
        specifier: 6.0.3
        version: 6.0.3
      vite:
        specifier: 8.3.4
        version: 8.3.4(@types/node@22.20.5)(jiti@2.7.0)
      vitest:
        specifier: 5.0.5
        version: 5.0.5(@types/node@22.20.5)(vite@8.3.4(@types/node@22.20.5)(jiti@2.7.0))

packages:

  '@babel/code-frame@7.29.7':
    resolution: {integrity: sha512-Aup7aUOfpbAUg2ROOJN6Iw5f9DMBlzu0mIkm/malLQFN/YQgO48wCj0Kxa3sEHJvPVFg7siR+qRInwXd2qhQKw==}
    engines: {node: '>=6.9.0'}

  '@babel/compat-data@7.29.7':
    resolution: {integrity: sha512-locTkQyKvwIEgBzVrn8693ebc97F2U8ZHjbXwDXJ5Fn2TCpNwTlKcaKLkdHop5c/icOFE7qt7Q9JC5hnKNa6Gg==}
    engines: {node: '>=6.9.0'}

  '@babel/core@7.29.7':
    resolution: {integrity: sha512-RgHBCvtjbOK2gXSNBNIkNoEc9qoVEtau3hj8gEqKQuL3HZAibKarWFEI3Lfm6EYKkLalOh8eSrj9b+ch9H/VBA==}
    engines: {node: '>=6.9.0'}

  '@babel/generator@7.29.8':
    resolution: {integrity: sha512-gZbepsdh3WDtgZKWL+vTPh71LSBrm/Y4/QDZBVCcYfmeTEEuoOYwlSy+G1StfJg+/Zy550u/3TATbm7qDbbMtg==}
    engines: {node: '>=6.9.0'}

  '@babel/helper-compilation-targets@7.29.7':
    resolution: {integrity: sha512-wem6WaBj4NaVYVdNhLPPVacES6ZJ+KBBfSkTMD3YZxbP3rm3Di85tJU5ljaUNhaOynt+Aj0xruhYuzQBt8n71g==}
    engines: {node: '>=6.9.0'}

  '@babel/helper-globals@7.29.7':
    resolution: {integrity: sha512-3nQVUAtvkKH9zahfWgw96Jc/uFOmjACE1kQz82E2lqWmHBgjzbNlsC22nuQTfahmWeQtTq5nQ/4Nnd2A1wj4zA==}
    engines: {node: '>=6.9.0'}

  '@babel/helper-module-imports@7.29.7':
    resolution: {integrity: sha512-ejHwrQQYcm9xnTivShn2IDOlIzInN34AXskvq9QicvCtEzq1Vzclu/tKF8Jq1Cg8JG2GL6/EmjgsCT7lXepE3g==}
    engines: {node: '>=6.9.0'}

  '@babel/helper-module-transforms@7.29.7':
    resolution: {integrity: sha512-UPUVSyXbOh627KiCIGQSgwWzGeBKLkaJ9PJEdrngIwMSzxLR4jS4+f1f1jb7VzBbg8nFLaYotvVPFCTqdrmTAg==}
    engines: {node: '>=6.9.0'}
    peerDependencies:
      '@babel/core': ^7.0.0

  '@babel/helper-string-parser@7.29.7':
    resolution: {integrity: sha512-Pb5ijPrZ89GDH8223L4UP8i6QApWxs04RbPQJTeWDV0/keR2E36MeKnyr6LYmUUvqRRI+Iv87SuF1W6ErINzYw==}
    engines: {node: '>=6.9.0'}

  '@babel/helper-validator-identifier@7.29.7':
    resolution: {integrity: sha512-qehxGkRj55h/ff8EMaJ+cYhyaKlHIxqYDn682wQD7RNp9UujOQsHog2uS0r2vzr4pW+sXf90NeeayjcNaX3fFg==}
    engines: {node: '>=6.9.0'}

  '@babel/helper-validator-option@7.29.7':
    resolution: {integrity: sha512-N9ZErrD+yW5geCDtBqnOoxmR8+tNKiGuxKlDpuJxfsqpa2dFcexaziGAE/qoHLiDDreVNMupxGmSoNlyvsA3gw==}
    engines: {node: '>=6.9.0'}

  '@babel/helpers@7.29.10':
    resolution: {integrity: sha512-EMCx3AGZ3WfAl6ht7AyQoPm2Lh+BGYEMdc4Q6Hf7uSCDOZFuLq44qNwL+iaim8VlyYhRAo4X43+weadK8ZB4Yg==}
    engines: {node: '>=6.9.0'}

  '@babel/parser@7.29.9':
    resolution: {integrity: sha512-CjXrNHTnvqBVqHgdBysY3vk2T8tpJHb5/RMeHJBTyVa9xgugCB0CJTx/3oO8RV2QRQP391RWpB7D6hLjm8V9uA==}
    engines: {node: '>=6.0.0'}
    hasBin: true

  '@babel/template@7.29.7':
    resolution: {integrity: sha512-puq+Gf35oI24FeN11LkoUQFqv9uwNeWpxXZi/Ji3rRIoKAzKnxRaZ+Gkj0vKS9ZCiTESfng1N9LyOyXvo+m+Gg==}
    engines: {node: '>=6.9.0'}

  '@babel/traverse@7.29.10':
    resolution: {integrity: sha512-B3lYAs2nkKskbgQ1nfy8Ma9ao9Q1rntTAQHrzzyDuj+TSO+X3le6PfWwqDvodsb+OumE10eMFfuMCTQSQ5iuIQ==}
    engines: {node: '>=6.9.0'}

  '@babel/types@7.29.8':
    resolution: {integrity: sha512-Vj1jF3cPfxg7OAfoI7QnVKLoILlm2JF9pnVHrX8qx7AHMiYWT+NDAA7jChlNgRS4WTLc/fD1lXLmPixluj+3Gg==}
    engines: {node: '>=6.9.0'}

  '@electric-sql/pglite-age@0.0.12':
    resolution: {integrity: sha512-h3w0ZbR/thNxbRiHrakK5XOJE5bbyIGT0mknREwiE2ELCLAEVv10x3jhnIkXTU5YJ5WzTZj2NbrFcAl/iHj3XQ==}
    peerDependencies:
      '@electric-sql/pglite': 0.5.11

  '@electric-sql/pglite-pg_hashids@0.0.12':
    resolution: {integrity: sha512-2vXH899hpmiKMhI1NvR9wxfyyW2SyvAMlBOwm8t02BRMpHIkXtl++fsBUTibL0TzTMAVLRFts53czelLPN0rDw==}
    peerDependencies:
      '@electric-sql/pglite': 0.5.11

  '@electric-sql/pglite-pg_ivm@0.0.12':
    resolution: {integrity: sha512-I+WQ0Hb7u7ZxMmznazZ15C0T6c4OKRuKVc5LaKkPNU+Cv7/aZmqRfPOHVu4MY65HC65dU3YmxT0A+tdWHcUF8w==}
    peerDependencies:
      '@electric-sql/pglite': 0.5.11

  '@electric-sql/pglite-pg_textsearch@0.0.13':
    resolution: {integrity: sha512-TQX6Opop6fRkfgbZcuUDZ4UYm7x07uQ5JznVJWG9QL3H3hx3qQ1CbqG6eSHzVEjGxxFqoH+2UJs0l/XR/Y3esA==}
    peerDependencies:
      '@electric-sql/pglite': 0.5.11

  '@electric-sql/pglite-pg_uuidv7@0.0.12':
    resolution: {integrity: sha512-Q+JvI5fSE0bws+qNa9hzoZEqhGFql/LjTZ5Fq1ojKx2hd99RNkLRcpDUNjqeyluCpZS5Aq/PsLjb5JBUevkXGw==}
    peerDependencies:
      '@electric-sql/pglite': 0.5.11

  '@electric-sql/pglite-pgtap@0.0.12':
    resolution: {integrity: sha512-qp8jE4sx+fNoCkcyd/cL8od+Nir4hFVphSh4/vH7P3cFCH6/sayWjQas9OyzPL0JHe7XQRFquyOvgwtUzbJgXQ==}
    peerDependencies:
      '@electric-sql/pglite': 0.5.11

  '@electric-sql/pglite-pgvector@0.0.12':
    resolution: {integrity: sha512-n3TJqjWI9FXwFrGhuTVMghef8SL3E6nb4lxZnxYFW3UTg/7/hMUWfz7v2y0+idWzEsQ/raRpMNCsw9zvSdC/SA==}
    peerDependencies:
      '@electric-sql/pglite': 0.5.11

  '@electric-sql/pglite-socket@0.2.14':
    resolution: {integrity: sha512-n7JO9FzxQHdF5oBKzovf/LuRUrEUpOgGP/tmfxmOB5lqWPySTKkCb6FBkzj7kztWGJu9eB0FoilqxvOJ+9+0fQ==}
    hasBin: true
    peerDependencies:
      '@electric-sql/pglite': 0.5.11
      '@electric-sql/pglite-age': 0.0.12
      '@electric-sql/pglite-pg_hashids': 0.0.12
      '@electric-sql/pglite-pg_ivm': 0.0.12
      '@electric-sql/pglite-pg_textsearch': 0.0.13
      '@electric-sql/pglite-pg_uuidv7': 0.0.12
      '@electric-sql/pglite-pgtap': 0.0.12
      '@electric-sql/pglite-pgvector': 0.0.12

  '@electric-sql/pglite@0.5.11':
    resolution: {integrity: sha512-SWuqsTjA4DDWqgZ05PC1RJaq8e00p5KACxbqaikDFQ8dIGA0SLRzuPniky7IW+q/c5RDNMdEXwv7mFBWIx9Hxw==}

  '@jridgewell/gen-mapping@0.3.13':
    resolution: {integrity: sha512-2kkt/7niJ6MgEPxF0bYdQ6etZaA+fQvDcLKckhy1yIQOzaoKjBBjSj63/aLVjYE3qhRt5dvM+uUyfCg6UKCBbA==}

  '@jridgewell/remapping@2.3.5':
    resolution: {integrity: sha512-LI9u/+laYG4Ds1TDKSJW2YPrIlcVYOwi2fUC6xB43lueCjgxV4lffOCZCtYFiH6TNOX+tQKXx97T4IKHbhyHEQ==}

  '@jridgewell/resolve-uri@3.1.2':
    resolution: {integrity: sha512-bRISgCIjP20/tbWSPWMEi54QVPRZExkuD9lJL+UIxUKtwVJA8wW1Trb1jMs1RFXo1CBTNZ/5hpC9QvmKWdopKw==}
    engines: {node: '>=6.0.0'}

  '@jridgewell/sourcemap-codec@1.6.0':
    resolution: {integrity: sha512-T7jf+5zgsZHwNJ4lvQ7/aezbyk0nNX+zJVWpmHA7VYsEx7a7qr5Rg5IbtJFqkgze5Y2sruq1RUY8Q837Od7iFw==}

  '@jridgewell/trace-mapping@0.3.31':
    resolution: {integrity: sha512-zzNR+SdQSDJzc8joaeP8QQoCQr8NuYx2dIIytl1QeBEZHJ9uW6hebsrYgbz8hJwUQao3TWCMtmfV8Nu1twOLAw==}

  '@oozcitak/dom@2.0.2':
    resolution: {integrity: sha512-GjpKhkSYC3Mj4+lfwEyI1dqnsKTgwGy48ytZEhm4A/xnH/8z9M3ZVXKr/YGQi3uCLs1AEBS+x5T2JPiueEDW8w==}
    engines: {node: '>=20.0'}

  '@oozcitak/infra@2.0.2':
    resolution: {integrity: sha512-2g+E7hoE2dgCz/APPOEK5s3rMhJvNxSMBrP+U+j1OWsIbtSpWxxlUjq1lU8RIsFJNYv7NMlnVsCuHcUzJW+8vA==}
    engines: {node: '>=20.0'}

  '@oozcitak/url@3.0.0':
    resolution: {integrity: sha512-ZKfET8Ak1wsLAiLWNfFkZc/BraDccuTJKR6svTYc7sVjbR+Iu0vtXdiDMY4o6jaFl5TW2TlS7jbLl4VovtAJWQ==}
    engines: {node: '>=20.0'}

  '@oozcitak/util@10.0.0':
    resolution: {integrity: sha512-hAX0pT/73190NLqBPPWSdBVGtbY6VOhWYK3qqHqtXQ1gK7kS2yz4+ivsN07hpJ6I3aeMtKP6J6npsEKOAzuTLA==}
    engines: {node: '>=20.0'}

  '@oxc-project/types@0.154.0':
    resolution: {integrity: sha512-KYOUGQFlLWR+s4QMV2Q9ko38TZm7EdO87Qm7rvZLqk/webse/cDjtyxKhg/47l0byCbs/k46LT8qc4PKjAikzA==}

  '@reduxjs/toolkit@2.13.0':
    resolution: {integrity: sha512-f6jwVRfwW30+tnllz4YcsHHpPYYOE7abcHkyUCovD+P7DyhdAI5prz2Fh/8TLhakjpN+7aIEion1s5L/tvlYlA==}
    peerDependencies:
      react: ^16.9.0 || ^17.0.0 || ^18 || ^19
      react-redux: ^7.2.1 || ^8.1.3 || ^9.0.0
    peerDependenciesMeta:
      react:
        optional: true
      react-redux:
        optional: true

  '@rolldown/binding-android-arm-eabi@1.2.14':
    resolution: {integrity: sha512-aWR+XKH9+rW7m5fWq/5360J3mHycrx/o6xZM2DQFdJnTMdyP7/WzxPjhtLbVWdKo2y612/4U1bWqb3HQhiF7vg==}
    engines: {node: ^20.19.0 || >=22.12.0}
    cpu: [arm]
    os: [android]

  '@rolldown/binding-android-arm64@1.2.14':
    resolution: {integrity: sha512-QiVxHofl6A8lQU7WAtOUY4QMVZXohxwz7WJJoeh8NBEUyKfIkMRKhYyq8az/1RypNiIXzNTtiS6KwHz0erxYRQ==}
    engines: {node: ^20.19.0 || >=22.12.0}
    cpu: [arm64]
    os: [android]

  '@rolldown/binding-darwin-arm64@1.2.14':
    resolution: {integrity: sha512-lTQOzHuBIooh3jIr5XINQkjPGEuGy+Dsy0meXDr6Sjty0b99kYgGh4uBC/8mJX1T0kC8d6S0aPP1Y+bHkh6aBw==}
    engines: {node: ^20.19.0 || >=22.12.0}
    cpu: [arm64]
    os: [darwin]

  '@rolldown/binding-darwin-x64@1.2.14':
    resolution: {integrity: sha512-hyMKEGatjmBYCs/Q4sbIcL/GqpFEqsX3wc+HYVQ/85A4rxc1o7rPm4DUI4GV4k/h0ITddwFSGpqQunI14GXjTA==}
    engines: {node: ^20.19.0 || >=22.12.0}
    cpu: [x64]
    os: [darwin]

  '@rolldown/binding-freebsd-x64@1.2.14':
    resolution: {integrity: sha512-u371GbXoVXrEgP20PwzoGNOdAOqAMhzo19JzzY+V4YmmnC+DTOoqdbMu+O+54emM59Mik/UdrtWgcuEDKWRPKA==}
    engines: {node: ^20.19.0 || >=22.12.0}
    cpu: [x64]
    os: [freebsd]

  '@rolldown/binding-linux-arm-gnueabihf@1.2.14':
    resolution: {integrity: sha512-BqwKsdZQf6EqVWr8fv2MrDYzAvOZ7+NYFSJESRGs87fkseEhs0TU9TXgRJTkZoRRkxTizyEg1LKUXfU3/78uqg==}
    engines: {node: ^20.19.0 || >=22.12.0}
    cpu: [arm]
    os: [linux]

  '@rolldown/binding-linux-arm64-gnu@1.2.14':
    resolution: {integrity: sha512-SD9kY8M009x/7s57Z1dgUVlP5+uYBgKQK0Tkr1WIWngrtUJmRCW1RJFMY7QDla2khXhmg2i5Io7MUjcmZNZ/KQ==}
    engines: {node: ^20.19.0 || >=22.12.0}
    cpu: [arm64]
    os: [linux]
    libc: [glibc]

  '@rolldown/binding-linux-arm64-musl@1.2.14':
    resolution: {integrity: sha512-BJ2CL19M6uuWesMgnqJzgxoI+N+eV7b0A9O9vLV42y+gitC41fNa8KElau1tHVzuLWX5GzEuxMPhAO0tQXQMkg==}
    engines: {node: ^20.19.0 || >=22.12.0}
    cpu: [arm64]
    os: [linux]
    libc: [musl]

  '@rolldown/binding-linux-ppc64-gnu@1.2.14':
    resolution: {integrity: sha512-4+Kl8daPV8NDHaD7mfCcc1pRM+Qg7ab8DyMm5FG5WoZgv4h2i3KFN1CybYBNbQqmuYm7ftJLvmMI1eHYJ22S/Q==}
    engines: {node: ^20.19.0 || >=22.12.0}
    cpu: [ppc64]
    os: [linux]
    libc: [glibc]

  '@rolldown/binding-linux-s390x-gnu@1.2.14':
    resolution: {integrity: sha512-V/h8ePq1fKDrmtFMz6xcCN3DKvuvMRrwwD1q0PkBeeo4DpK64biaKvqWGVxqCeYKqeRk7gE7/iKPxLCn08O97A==}
    engines: {node: ^20.19.0 || >=22.12.0}
    cpu: [s390x]
    os: [linux]
    libc: [glibc]

  '@rolldown/binding-linux-x64-gnu@1.2.14':
    resolution: {integrity: sha512-WxalXzgrLVpKC93xfpaJ3gCXUWzeCr+FRCbDVD2mUAy4L6Vo3lNVz0epUEUpxPWJkLNYUwM4OSIikv36OJ9mLg==}
    engines: {node: ^20.19.0 || >=22.12.0}
    cpu: [x64]
    os: [linux]
    libc: [glibc]

  '@rolldown/binding-linux-x64-musl@1.2.14':
    resolution: {integrity: sha512-3G3tnAmTpdk9jO3GQtyHXqeFD2SlecfTws/Y3M2mmj9nMBwwuLT4kur8sZKeu7ENUHSpVO3cIsm5A52LEWWwlg==}
    engines: {node: ^20.19.0 || >=22.12.0}
    cpu: [x64]
    os: [linux]
    libc: [musl]

  '@rolldown/binding-openharmony-arm64@1.2.14':
    resolution: {integrity: sha512-qyr5XiNGxm2ytx17vvtcJ9nXn6v1gENETi503bJx3OGwZ1tSonj7BosxbMa/xeAfSl5iS9X6KjEWYXLu6v1L7Q==}
    engines: {node: ^20.19.0 || >=22.12.0}
    cpu: [arm64]
    os: [openharmony]

  '@rolldown/binding-win32-arm64-msvc@1.2.14':
    resolution: {integrity: sha512-oA4o5o0S2yB199YyYXDzKUv1Z56Rc+mgOjwm7Z/vJ9Z8igiDPYvoOuDyo6g7AK/ZaF09nPhDKVnGBcYHO11GXA==}
    engines: {node: ^20.19.0 || >=22.12.0}
    cpu: [arm64]
    os: [win32]

  '@rolldown/binding-win32-x64-msvc@1.2.14':
    resolution: {integrity: sha512-9mE94bf2GZUaR/fUSXCMpBoWkctu421Mi0ORpm4zqfbkjKep7RxzPFa5etcGs5h+2KApoWBOA/hAJa/7saGgEQ==}
    engines: {node: ^20.19.0 || >=22.12.0}
    cpu: [x64]
    os: [win32]

  '@rolldown/pluginutils@1.0.1':
    resolution: {integrity: sha512-2j9bGt5Jh8hj+vPtgzPtl72j0yRxHAyumoo6TNfAjsLB04UtpSvPbPcDcBMxz7n+9CYB0c1GxQFxYRg2jimqGw==}

  '@standard-schema/spec@1.1.0':
    resolution: {integrity: sha512-l2aFy5jALhniG5HgqrD6jXLi/rUWrKvqN/qJx6yoJsgKhblVd+iqqU4RCXavm/jPityDo5TCvKMnpjKnOriy0w==}

  '@standard-schema/utils@0.3.0':
    resolution: {integrity: sha512-e7Mew686owMaPJVNNLs55PUvgz371nKgwsc4vxE49zsODpJEnxgxRo2y/OKrqueavXgZNMDVj3DdHFlaSAeU8g==}

  '@tanstack/history@1.162.5':
    resolution: {integrity: sha512-w1+YvwmTkwt5n8yUqEH3IWZ9DsmorCZW/EQ3KYHnqEgIkOZpH54NvW6/Epq3Dzb8H0ifIeYX8PExvrNLIH5FIA==}
    engines: {node: '>=20.19'}

  '@tanstack/react-router@1.170.44':
    resolution: {integrity: sha512-uIIZ3CHU1yWlkMkmbnGFX3WIfZozF+tNrOMMEoM9lo+jzPInCRq80LBqW3DH9ixNHWjB3TM/cNIvr05uGIlP3A==}
    engines: {node: '>=20.19'}
    peerDependencies:
      react: '>=18.0.0 || >=19.0.0'
      react-dom: '>=18.0.0 || >=19.0.0'

  '@tanstack/react-start-client@1.168.42':
    resolution: {integrity: sha512-t3Jcn1nKjeEsPv0WVrW31HzWyMtIYkNhW0FcZ2FnTHDDne64d+XK5hJ3Y5AP/heUXLhBcoHfnxWjBFzqECOZOw==}
    engines: {node: '>=22.12.0'}
    peerDependencies:
      react: '>=18.0.0 || >=19.0.0'
      react-dom: '>=18.0.0 || >=19.0.0'

  '@tanstack/react-start-rsc@0.1.63':
    resolution: {integrity: sha512-/U6mz5u1VrXiYT23+ylzw4lsjkMFMeO6oZ5DnQmea5Oj2mluMS/GT7OOPyp+OWpw/SU5rTt6Xoon2PJgPzxa9Q==}
    engines: {node: '>=22.12.0'}
    peerDependencies:
      '@rspack/core': '>=2.0.0-0'
      '@vitejs/plugin-rsc': '>=0.5.30'
      react: '>=18.0.0 || >=19.0.0'
      react-dom: '>=18.0.0 || >=19.0.0'
      react-server-dom-rspack: '>=0.0.2'
    peerDependenciesMeta:
      '@rspack/core':
        optional: true
      '@vitejs/plugin-rsc':
        optional: true
      react-server-dom-rspack:
        optional: true

  '@tanstack/react-start-server@1.167.50':
    resolution: {integrity: sha512-nBRVv3NUG5KarMB8q+gjC1QNUXXvZRuhGGt4qESPHo8b3r1vr4+kOHLoMqBCdGT3/4XsLn7guWeRt0rFiVfoMA==}
    engines: {node: '>=22.12.0'}
    peerDependencies:
      react: '>=18.0.0 || >=19.0.0'
      react-dom: '>=18.0.0 || >=19.0.0'

  '@tanstack/react-start@1.169.2':
    resolution: {integrity: sha512-2PafKJpBoAzWhn8zF3hFqDr4+saGvTZ2n10VfVJTth3nhRj2rZGX2yp073LDEmBScLv7xqZabDl/jXio/kcezQ==}
    engines: {node: '>=22.12.0'}
    peerDependencies:
      '@rsbuild/core': ^2.0.0
      '@vitejs/plugin-rsc': '*'
      react: '>=18.0.0 || >=19.0.0'
      react-dom: '>=18.0.0 || >=19.0.0'
      vite: '>=8.0.0'
    peerDependenciesMeta:
      '@rsbuild/core':
        optional: true
      '@vitejs/plugin-rsc':
        optional: true
      vite:
        optional: true

  '@tanstack/react-store@0.11.2':
    resolution: {integrity: sha512-oj5O5DmiMWE+ih+SioX2ayC1kbK7d3fpLx0B75fPJr9nY3zU+hoW010yr64qXsY/9fyiLVE2bn5mGNV3owm8RQ==}
    peerDependencies:
      react: ^16.8.0 || ^17.0.0 || ^18.0.0 || ^19.0.0
      react-dom: ^16.8.0 || ^17.0.0 || ^18.0.0 || ^19.0.0

  '@tanstack/router-cli@1.167.44':
    resolution: {integrity: sha512-41ZrtO4zFqeUfsfRtAML6qvhjwWhvd8qLdu9UGFn3oTkDFM5DyvXAQSpbR05fKrNAS05to+j3j0LWdncPV7LQg==}
    engines: {node: '>=20.19'}
    hasBin: true

  '@tanstack/router-core@1.171.37':
    resolution: {integrity: sha512-11Le36++mHNeeFIABz4C3PdTWyJ1ilOmGmANOQOypknZwC1xN674al5BUqWuimKasWane1/XSNcEx8NYNHh0+A==}
    engines: {node: '>=20.19'}

  '@tanstack/router-generator@1.167.44':
    resolution: {integrity: sha512-FUgkLdqXXF0ZSYsyJKmcLubqFfckMJolUM3CplsJidedGYzIcMXYm43wodAhVCU1BqlKXJldXuuCtebqxurvaA==}
    engines: {node: '>=20.19'}

  '@tanstack/router-plugin@1.168.46':
    resolution: {integrity: sha512-nAQ/13ySmSJ8OVXJh/e4ACg0vn87NjrEIxljxj+K9tr+vdOVuScFWuciJRIXhB3CwV7LnmWt6dDZYwzd0b+tAw==}
    engines: {node: '>=20.19'}
    peerDependencies:
      '@rsbuild/core': '>=1.0.2 || ^2.0.0'
      '@tanstack/react-router': ^1.170.44
      vite: '>=5.0.0 || >=6.0.0 || >=7.0.0 || >=8.0.0'
      vite-plugin-solid: ^2.11.10 || ^3.0.0-0
      webpack: '>=5.92.0'
    peerDependenciesMeta:
      '@rsbuild/core':
        optional: true
      '@tanstack/react-router':
        optional: true
      vite:
        optional: true
      vite-plugin-solid:
        optional: true
      webpack:
        optional: true

  '@tanstack/router-utils@1.162.4':
    resolution: {integrity: sha512-3TSH3rwAQTqQOtTBF8IXMFXmGNJWnjwIm+l87uguyC/of0pSRKcU9GJrozaf0fY9it8dLQvUZJA2MOlfqbW1sA==}
    engines: {node: '>=20.19'}

  '@tanstack/start-client-core@1.170.37':
    resolution: {integrity: sha512-bFbhnZuu0fDN4taWREgkopUY5fhB7CA6nyDpITFNNUDNTmu8QDmxEf3EtV4FgNGrPp1dufKq2iaIdldq7KJQ9g==}
    engines: {node: '>=22.12.0'}

  '@tanstack/start-fn-stubs@1.162.0':
    resolution: {integrity: sha512-QWfUZ3Yo923tdQn38LyKMU8rcTw69zc+T4dAvgTWV4O56SqFRsGfS0lSWIMhJRwXIx/bvdi7nTUBDdZtTHtpTQ==}
    engines: {node: '>=22.12.0'}

  '@tanstack/start-plugin-core@1.171.53':
    resolution: {integrity: sha512-pYAKx6o99iHk8Qr+4GTe7y/yrs0phdq1pFhkY9tDaj9AIxNRI9vgYMy0XoXv7LUjwv0kELC+bKYEZQ4pfz55/A==}
    engines: {node: '>=22.12.0'}
    peerDependencies:
      '@rsbuild/core': ^2.0.0
      vite: '>=8.0.0'
    peerDependenciesMeta:
      '@rsbuild/core':
        optional: true
      vite:
        optional: true

  '@tanstack/start-server-core@1.169.43':
    resolution: {integrity: sha512-f53IBLTeN8ajrJ7vTyYclvDh9G8aGmgQuJ0Q68bpUYjxKHaUNW1lsftIx+ySPkWLWD9/ZH1JmHBaAbCHIzDaNA==}
    engines: {node: '>=22.12.0'}

  '@tanstack/start-storage-context@1.167.39':
    resolution: {integrity: sha512-wqIxkepruM4VMGPKhWdkNbr31pzm30/3COlYRbucmWS2TmwdcnIdECudcqTCHAAK8fwAxKhJ+p8stWe2wizKrA==}
    engines: {node: '>=22.12.0'}

  '@tanstack/store@0.11.2':
    resolution: {integrity: sha512-sJ4mjol8uQsHV0gOJzzjwXfh2Fwm+Sz0+8deqiTm4jGbMdjzNSW+xZCFm0kUa870uhd8yi+DpKnZb5Kc4apa0Q==}

  '@tanstack/virtual-file-routes@1.162.0':
    resolution: {integrity: sha512-uhOeFyxLcU41HzvrxsGpiWdcMbScY1EDgbZ5K7DVRMYInbLYWAC0EA/kx9wXAoSM8q82bUG2hRl8+EAjE6XAbA==}
    engines: {node: '>=20.19'}

  '@types/chai@5.2.3':
    resolution: {integrity: sha512-Mw558oeA9fFbv65/y4mHtXDs9bPnFMZAL/jxdPFUpOHHIXX91mcgEHbS5Lahr+pwZFR8A7GQleRWeI6cGFC2UA==}

  '@types/d3-array@3.2.2':
    resolution: {integrity: sha512-hOLWVbm7uRza0BYXpIIW5pxfrKe0W+D5lrFiAEYR+pb6w3N2SwSMaJbXdUfSEv+dT4MfHBLtn5js0LAWaO6otw==}

  '@types/d3-color@3.1.3':
    resolution: {integrity: sha512-iO90scth9WAbmgv7ogoq57O9YpKmFBbmoEoCHDB2xMBY0+/KVrqAaCDyCE16dUspeOvIxFFRI+0sEtqDqy2b4A==}

  '@types/d3-ease@3.0.2':
    resolution: {integrity: sha512-NcV1JjO5oDzoK26oMzbILE6HW7uVXOHLQvHshBUW4UMdZGfiY6v5BeQwh9a9tCzv+CeefZQHJt5SRgK154RtiA==}

  '@types/d3-interpolate@3.0.4':
    resolution: {integrity: sha512-mgLPETlrpVV1YRJIglr4Ez47g7Yxjl1lj7YKsiMCb27VJH9W8NVM6Bb9d8kkpG/uAQS5AmbA48q2IAolKKo1MA==}

  '@types/d3-path@3.1.1':
    resolution: {integrity: sha512-VMZBYyQvbGmWyWVea0EHs/BwLgxc+MKi1zLDCONksozI4YJMcTt8ZEuIR4Sb1MMTE8MMW49v0IwI5+b7RmfWlg==}

  '@types/d3-scale@4.0.9':
    resolution: {integrity: sha512-dLmtwB8zkAeO/juAMfnV+sItKjlsw2lKdZVVy6LRr0cBmegxSABiLEpGVmSJJ8O08i4+sGR6qQtb6WtuwJdvVw==}

  '@types/d3-shape@3.2.0':
    resolution: {integrity: sha512-kVd74ta9eof3eJOvbNd1vGKS/XERRyQbT26Og63hIsvDO84cjD5gEOhsXf26w3FSoNlPVz84DOFcKv/oou+fMw==}

  '@types/d3-time@3.0.4':
    resolution: {integrity: sha512-yuzZug1nkAAaBlBBikKZTgzCeA+k1uy4ZFwWANOfKw5z5LRhV0gNA7gNkKm7HoK+HRN0wX3EkxGk0fpbWhmB7g==}

  '@types/d3-timer@3.0.2':
    resolution: {integrity: sha512-Ps3T8E8dZDam6fUyNiMkekK3XUsaUEik+idO9/YjPtfj2qruF8tFBXS7XhtE4iIXBLxhmLjP3SXpLhVf21I9Lw==}

  '@types/deep-eql@4.0.2':
    resolution: {integrity: sha512-c9h9dVVMigMPc4bwTvC5dxqtqJZwQPePsWjPlpSOnojbor6pGqdk541lfA7AqFQr5pB1BRdq0juY9db81BwyFw==}

  '@types/estree@1.0.9':
    resolution: {integrity: sha512-GhdPgy1el4/ImP05X05Uw4cw2/M93BCUmnEvWZNStlCzEKME4Fkk+YpoA5OiHNQmoS7Cafb8Xa3Pya8m1Qrzeg==}

  '@types/node@22.20.5':
    resolution: {integrity: sha512-U2+DNr+wSjpsTS/wZGYHq7GcwfuSmKiKvoPvK22zwTlRhU91yOniN4qRR5KhIjvif7ysw/dz/hKmfDH0Ris4aA==}

  '@types/react-dom@19.3.0':
    resolution: {integrity: sha512-ZI7bU42mZXXKHn/qNLEw2IrbiINU7X5+vfgdixBHkCNpYWXjKgfQ/P+uyGb5CjOLB9UcnTeg3rylQtV2hym44Q==}
    peerDependencies:
      '@types/react': ^19.3.0

  '@types/react@19.3.0':
    resolution: {integrity: sha512-N0rFCuH9YoxG9/m61l9MfpJKfmLOVU0em7ipIz6TRgSSkvReLB9vL85GB+yr8Bs5leqpvg96JSwF4ZS1s4viQg==}

  '@types/use-sync-external-store@0.0.6':
    resolution: {integrity: sha512-zFDAD+tlpf2r4asuHEj0XH6pY6i0g5NeAHPn+15wk3BV6JA69eERFXC1gyGThDkVa1zCyKr5jox1+2LbV/AMLg==}

  '@vitejs/plugin-react@6.1.2':
    resolution: {integrity: sha512-fhJNGUdscQa4HkI0xFxwonWyhnVReCPDbXI7FH7jmzpnVCrFQI7PRrhWecO263610vOrs9tr2Y4xcf8uAdFxbw==}
    engines: {node: ^20.19.0 || >=22.12.0}
    peerDependencies:
      '@rolldown/plugin-babel': ^0.1.7 || ^0.2.0
      babel-plugin-react-compiler: ^1.0.0
      oxc-transform-react: ^0.152.0
      vite: ^8.0.0
    peerDependenciesMeta:
      '@rolldown/plugin-babel':
        optional: true
      babel-plugin-react-compiler:
        optional: true
      oxc-transform-react:
        optional: true

  '@vitest/mocker@5.0.5':
    resolution: {integrity: sha512-xLL3lkDegJZw+MGoGaCCsFayDZthGgpAtr3Vziyfc4p7xH89K7KRPcRBBh/kEYm0Aqkt5DtTmkYpBtRV/FrHZg==}
    peerDependencies:
      msw: ^2.4.9 || ^3.0.0
      vite: ^6.0.0 || ^7.0.0 || ^8.0.0
    peerDependenciesMeta:
      msw:
        optional: true
      vite:
        optional: true

  '@vitest/spy@5.0.5':
    resolution: {integrity: sha512-lwJRExuH417257Q5wv9QYugN9IMJkoxcrKrYxGPQkBzl7wlNpTUxD/5yNX4ESKVUIShKPgkGchYPFMWOOk0wzw==}

  ansis@4.4.0:
    resolution: {integrity: sha512-9k3v7xcHwgdO/DruxGIg4HtjvlAZlcnsX/mzqUb1t3NkYnl9kK2UJ+Gq0io+vQf7iT//BD/HB/NBkUR1LWxoeA==}
    engines: {node: '>=14'}

  argparse@2.0.1:
    resolution: {integrity: sha512-8+9WqebbFzpX9OR+Wa6O29asIogeRMzcGtAINdpMHHyAg10f05aSFVBbcEqGf/PXw1EjAZ+q2/bEBg3DvurK3Q==}

  assertion-error@2.0.1:
    resolution: {integrity: sha512-Izi8RQcffqCeNVgFigKli1ssklIbpHnCYc6AknXGYoB6grJqyeby7jv12JUQgmTAnIDnbck1uxksT4dzN3PWBA==}
    engines: {node: '>=12'}

  babel-dead-code-elimination@1.0.12:
    resolution: {integrity: sha512-GERT7L2TiYcYDtYk1IpD+ASAYXjKbLTDPhBtYj7X1NuRMDTMtAx9kyBenub1Ev41lo91OHCKdmP+egTDmfQ7Ig==}

  baseline-browser-mapping@2.11.29:
    resolution: {integrity: sha512-YeesxhUmR4h5y5V8KF8iBCqJb8YFrBJ++XBTeGcWIaQOYXGN19JM0FoiOjAhwuDoln8owMgXcWBmgHtYSkky2w==}
    engines: {node: '>=6.0.0'}
    hasBin: true

  browserslist@4.29.3:
    resolution: {integrity: sha512-1R4kiYKXGViqEN0CnoDrXc1StD9niAwu+j2dukWzrD4bJgsD4lDmEp0CRbc6E/vYJIfTHwPmwyaKtVSudICdPA==}
    engines: {node: ^6 || ^7 || ^8 || ^9 || ^10 || ^11 || ^12 || >=13.7}
    hasBin: true

  cac@7.1.0:
    resolution: {integrity: sha512-LMDU/U2yA4IPIY8KT0NsNPWEYZvAMkbgyspxJ6btJaYV+WMDOHAZCmB0lsTObiHaRS1V/ztKAl7+TSkTqXyeoA==}
    engines: {node: '>=20.19.0'}

  caniuse-lite@1.0.30001816:
    resolution: {integrity: sha512-+8Yx7BXCoqk6IF8yTicjfUR6D/ldJzdlsodlEOiOSPmhK844WIgk67/zIQaGAOxNkZyyvBlrRFnLvqKIoqbAFw==}

  chai@6.3.0:
    resolution: {integrity: sha512-XWAtwJ6OHO+tj0EKCs0Y2UamnyOxseZWltU4x2U2wh8g4AigdjwvtUjvLP2tqkA/avxHEtzxNaqGq/YGNwckKg==}
    engines: {node: '>=18'}

  chokidar@5.0.0:
    resolution: {integrity: sha512-TQMmc3w+5AxjpL8iIiwebF73dRDF4fBIieAqGn9RGCWaEVwQ6Fb2cGe31Yns0RRIzii5goJ1Y7xbMwo1TxMplw==}
    engines: {node: '>= 20.19.0'}

  clsx@2.1.1:
    resolution: {integrity: sha512-eYm0QWBtUrBWZWG0d386OGAw16Z995PiOVo2B7bjWSbHedGl5e0ZWaq65kOGgUSNesEIDkB9ISbTg/JK9dhCZA==}
    engines: {node: '>=6'}

  consola@3.4.2:
    resolution: {integrity: sha512-5IKcdX0nnYavi6G7TtOhwkYzyjfJlatbjMjuLSfE2kYT5pMDOilZ4OvMhi637CcDICTmz3wARPoyhqyX1Y+XvA==}
    engines: {node: ^14.18.0 || >=16.10.0}

  convert-source-map@2.0.0:
    resolution: {integrity: sha512-Kvp459HrV2FEJ1CAsi1Ku+MY3kasH19TFykTz2xWmMeq6bk2NU3XXvfJ+Q61m0xktWwt+1HSYf3JZsTms3aRJg==}

  cookie-es@3.1.1:
    resolution: {integrity: sha512-UaXxwISYJPTr9hwQxMFYZ7kNhSXboMXP+Z3TRX6f1/NyaGPfuNUZOWP1pUEb75B2HjfklIYLVRfWiFZJyC6Npg==}

  crossws@0.4.15:
    resolution: {integrity: sha512-NsUOpDZosz7nyI+qEIl05yaiXOWaXH2oTeM+XBWtiSWZtb5rzcIsl1AST/HzM2jzUn76eFuyrkn83E6iSBRUvw==}
    peerDependencies:
      srvx: '>=0.11.5'
    peerDependenciesMeta:
      srvx:
        optional: true

  csstype@3.2.3:
    resolution: {integrity: sha512-z1HGKcYy2xA8AGQfwrn0PAy+PB7X/GSj3UVJW9qKyn43xWa+gl5nXmU4qqLMRzWVLFC8KusUX8T/0kCiOYpAIQ==}

  d3-array@3.2.4:
    resolution: {integrity: sha512-tdQAmyA18i4J7wprpYq8ClcxZy3SC31QMeByyCFyRt7BVHdREQZ5lpzoe5mFEYZUWe+oq8HBvk9JjpibyEV4Jg==}
    engines: {node: '>=12'}

  d3-color@3.1.0:
    resolution: {integrity: sha512-zg/chbXyeBtMQ1LbD/WSoW2DpC3I0mpmPdW+ynRTj/x2DAWYrIY7qeZIHidozwV24m4iavr15lNwIwLxRmOxhA==}
    engines: {node: '>=12'}

  d3-ease@3.0.1:
    resolution: {integrity: sha512-wR/XK3D3XcLIZwpbvQwQ5fK+8Ykds1ip7A2Txe0yxncXSdq1L9skcG7blcedkOX+ZcgxGAmLX1FrRGbADwzi0w==}
    engines: {node: '>=12'}

  d3-format@3.1.2:
    resolution: {integrity: sha512-AJDdYOdnyRDV5b6ArilzCPPwc1ejkHcoyFarqlPqT7zRYjhavcT3uSrqcMvsgh2CgoPbK3RCwyHaVyxYcP2Arg==}
    engines: {node: '>=12'}

  d3-interpolate@3.0.1:
    resolution: {integrity: sha512-3bYs1rOD33uo8aqJfKP3JWPAibgw8Zm2+L9vBKEHJ2Rg+viTR7o5Mmv5mZcieN+FRYaAOWX5SJATX6k1PWz72g==}
    engines: {node: '>=12'}

  d3-path@3.1.0:
    resolution: {integrity: sha512-p3KP5HCf/bvjBSSKuXid6Zqijx7wIfNW+J/maPs+iwR35at5JCbLUT0LzF1cnjbCHWhqzQTIN2Jpe8pRebIEFQ==}
    engines: {node: '>=12'}

  d3-scale@4.0.2:
    resolution: {integrity: sha512-GZW464g1SH7ag3Y7hXjf8RoUuAFIqklOAq3MRl4OaWabTFJY9PN/E1YklhXLh+OQ3fM9yS2nOkCoS+WLZ6kvxQ==}
    engines: {node: '>=12'}

  d3-shape@3.2.0:
    resolution: {integrity: sha512-SaLBuwGm3MOViRq2ABk3eLoxwZELpH6zhl3FbAoJ7Vm1gofKx6El1Ib5z23NUEhF9AsGl7y+dzLe5Cw2AArGTA==}
    engines: {node: '>=12'}

  d3-time-format@4.1.0:
    resolution: {integrity: sha512-dJxPBlzC7NugB2PDLwo9Q8JiTR3M3e4/XANkreKSUxF8vvXKqm1Yfq4Q5dl8budlunRVlUUaDUgFt7eA8D6NLg==}
    engines: {node: '>=12'}

  d3-time@3.1.0:
    resolution: {integrity: sha512-VqKjzBLejbSMT4IgbmVgDjpkYrNWUYJnbCGo874u7MMKIWsILRX+OpX/gTk8MqjpT1A/c6HY2dCA77ZN0lkQ2Q==}
    engines: {node: '>=12'}

  d3-timer@3.0.1:
    resolution: {integrity: sha512-ndfJ/JxxMd3nw31uyKoY2naivF+r29V+Lc0svZxe1JvvIRmi8hUsrMvdOwgS1o6uBHmiz91geQ0ylPP0aj1VUA==}
    engines: {node: '>=12'}

  db0@0.3.4:
    resolution: {integrity: sha512-RiXXi4WaNzPTHEOu8UPQKMooIbqOEyqA1t7Z6MsdxSCeb8iUC9ko3LcmsLmeUt2SM5bctfArZKkRQggKZz7JNw==}
    peerDependencies:
      '@electric-sql/pglite': '*'
      '@libsql/client': '*'
      better-sqlite3: '*'
      drizzle-orm: '*'
      mysql2: '*'
      sqlite3: '*'
    peerDependenciesMeta:
      '@electric-sql/pglite':
        optional: true
      '@libsql/client':
        optional: true
      better-sqlite3:
        optional: true
      drizzle-orm:
        optional: true
      mysql2:
        optional: true
      sqlite3:
        optional: true

  debug@4.4.3:
    resolution: {integrity: sha512-RGwwWnwQvkVfavKVt22FGLw+xYSdzARwm0ru6DhTVA3umU5hZc28V3kO4stgYryrTlLpuvgI9GiijltAjNbcqA==}
    engines: {node: '>=6.0'}
    peerDependencies:
      supports-color: '*'
    peerDependenciesMeta:
      supports-color:
        optional: true

  decimal.js-light@2.5.1:
    resolution: {integrity: sha512-qIMFpTMZmny+MMIitAB6D7iVPEorVw6YQRWkvarTkT4tBeSLLiHzcwj6q0MmYSFCiVpiqPJTJEYIrpcPzVEIvg==}

  detect-libc@2.1.2:
    resolution: {integrity: sha512-Btj2BOOO83o3WyH59e8MgXsxEQVcarkUOpEYrubB0urwnN10yQ364rsiByU11nZlqWYZm05i/of7io4mzihBtQ==}
    engines: {node: '>=8'}

  diff@9.0.0:
    resolution: {integrity: sha512-svtcdpS8CgJyqAjEQIXdb3OjhFVVYjzGAPO8WGCmRbrml64SPw/jJD4GoE98aR7r25A0XcgrK3F02yw9R/vhQw==}
    engines: {node: '>=0.3.1'}

  electron-to-chromium@1.5.458:
    resolution: {integrity: sha512-/hIH2gRSmxrf4/X4Nw/t/Wc8PVS22l8/3HnWjWTWsTOM5dsnMUPZF/+u+yr3LqweNuTBJE1rq6qAQzKkZVwMfA==}

  env-runner@0.1.16:
    resolution: {integrity: sha512-2LRJM4P2KLX6J83QZZrMqvgCDt/D5ea7wPcI3yYiy5cG/9rX5QwdwZFx0D7ktWnjdRyZxYjttGGorb5nFqb1CA==}
    hasBin: true
    peerDependencies:
      '@netlify/runtime': ^4.1.23
      '@vercel/queue': '>=0.2.0'
      miniflare: ^4.20260515.0
      wrangler: ^4.0.0
    peerDependenciesMeta:
      '@netlify/runtime':
        optional: true
      '@vercel/queue':
        optional: true
      miniflare:
        optional: true
      wrangler:
        optional: true

  es-module-lexer@2.3.2:
    resolution: {integrity: sha512-poHGpORABojJJucnV9KbOavETW8lBVnphkW77ER5/BQ5Fz7oXSoCNek7IH3vR5nRjdsEz926ibFYX8KtLQmdyw==}

  es-toolkit@1.52.0:
    resolution: {integrity: sha512-XTNEJQh1tY1ZJVcf6ayP/2n4ZPyaHlW2FWs7xvw5ddPuhUVjLD3olQVQS7kf58JbAB48iL0uL/jerTrjtV3lDA==}

  escalade@3.2.0:
    resolution: {integrity: sha512-WUj2qlxaQtO4g6Pq5c29GTcWGDyd8itL8zTlipgECz3JesAiiOKotd8JU6otB3PACgG6xkJUyVhboMS+bje/jA==}
    engines: {node: '>=6'}

  estree-walker@3.0.3:
    resolution: {integrity: sha512-7RUKfXgSMMkzt6ZuXmqapOurLGPPfgj6l9uRZ7lRGolvk0y2yocc35LdcxKC5PQZdn2DMqioAQ2NoWcrTKmm6g==}

  eventemitter3@5.0.4:
    resolution: {integrity: sha512-mlsTRyGaPBjPedk6Bvw+aqbsXDtoAyAzm5MO7JgU+yVRyMQ5O8bD4Kcci7BS85f93veegeCPkL8R4GLClnjLFw==}

  expect-type@1.4.0:
    resolution: {integrity: sha512-KfYbmpRm0VbLjEvVa9yGwCi9GI34xvi7A/HXYWQO65CSD2u3MczUJSuwXKFIxlGsgBQizV9q5J9NHj4VG0n+pA==}
    engines: {node: '>=12.0.0'}

  exsolve@1.1.3:
    resolution: {integrity: sha512-kuzL9zherLQoqDeQaS55AiiIg1kb4KYXaSusTtgZTPlvKP2gGCI82LNmBNh5RjDVUXIcmgx+/Mx7vPwRzBbhJA==}

  fdir@6.5.0:
    resolution: {integrity: sha512-tIbYtZbucOs0BRGqPJkshJUYdL+SDH7dVM8gjy+ERp3WAUjLEFJE+02kanyHtwjWOnwrKYBiwAmM0p4kLJAnXg==}
    engines: {node: '>=12.0.0'}
    peerDependencies:
      picomatch: ^3 || ^4
    peerDependenciesMeta:
      picomatch:
        optional: true

  fetchdts@0.2.0:
    resolution: {integrity: sha512-PJb4ZTGT2/wK78RmVrxZITStWabhZlKBsL52VOgq+c7clEkdHdEB+0rtzrXCbZJqeYJj+IwNWYqB5/G6vouA6A==}

  fsevents@2.3.3:
    resolution: {integrity: sha512-5xoDfX+fL7faATnagmWPpbFtwh/R77WmMMqqHGS65C3vvB0YHrgF+B1YmZ3441tMj5n63k0212XNoJwzlhffQw==}
    engines: {node: ^8.16.0 || ^10.6.0 || >=11.0.0}
    os: [darwin]

  gensync@1.0.0-beta.2:
    resolution: {integrity: sha512-3hN7NaskYvMDLQY55gnW3NQ+mesEAepTqlg+VEbj7zzqEMBVNhzcGYYeqFo/TlYz6eQiFcp1HcsCZO+nGgS8zg==}
    engines: {node: '>=6.9.0'}

  h3@2.0.1-rc.22:
    resolution: {integrity: sha512-Esv0DMIuPkCTSWCA0vO73vcTqwzH1wjSrAO1TXNu/K3up1sZHa9EKMapbmxCDYBeymC3fVTk4qxp7ogQWQ+KgA==}
    engines: {node: '>=20.11.1'}
    hasBin: true
    peerDependencies:
      crossws: ^0.4.1
    peerDependenciesMeta:
      crossws:
        optional: true

  hookable@6.1.2:
    resolution: {integrity: sha512-+abwxtiEA52GCVIsQqut3S/uKTbUwYIp4Pe/vv+6py5XiXBCqMZHg6pA6Y5qhgLSEys0/cYuPbO0z1QFj5ZCmg==}

  httpxy@0.5.5:
    resolution: {integrity: sha512-uDjmnPyp1q4Sgzf3w+J/Fc6UqcCEj0x4Wjp7OqK5dGhNeDgpyrAmnS6ey8QWrX3SWDon2DMKf9sBa5X9+CVyMA==}

  immer@11.1.21:
    resolution: {integrity: sha512-bZSadeCPGdaY5/qRLgr6mDSH1ra21rD3rqpiWk7+QTr4ayYPTE9qZYdLh/NdPhMe0wSrTvHD/Lk8q5EwhUs0aw==}

  internmap@2.0.3:
    resolution: {integrity: sha512-5Hh7Y1wQbvY5ooGgPbDaL5iYLAPzMTUrjMulskHLH6wnv/A+1q5rgEaiuqEjB+oxGXIVZs1FF+R/KPN3ZSQYYg==}
    engines: {node: '>=12'}

  isbot@5.2.2:
    resolution: {integrity: sha512-iQcBXcd+Rv/pkubRyGh2utW2j1oPG5hZY6TUhVPpqK4G+o3IbxpJNx04hgksjc/N7GK5pEorUxDeg31cFgEk/w==}
    engines: {node: '>=18'}

  jiti@2.7.0:
    resolution: {integrity: sha512-AC/7JofJvZGrrneWNaEnJeOLUx+JlGt7tNa0wZiRPT4MY1wmfKjt2+6O2p2uz2+skll8OZZmJMNqeke7kKbNgQ==}
    hasBin: true

  js-tokens@4.0.0:
    resolution: {integrity: sha512-RdJUflcE3cUzKiMqQgsCu06FPu9UdIJO0beYbPhHN4k6apgJtifcoCtT9bcxOpYBtpD2kCM6Sbzg4CausW/PKQ==}

  js-yaml@4.3.2:
    resolution: {integrity: sha512-SFNOvSJ+Dgf/9An904Yx+CgSlIPCkIpao4qo51lpee25TIRejdH3rhR4EZMGoNx3/TP3O+wzWuiTFl4sqbltzA==}
    hasBin: true

  jsesc@3.1.0:
    resolution: {integrity: sha512-/sM3dO2FOzXjKQhJuo0Q173wf2KOo8t4I8vHy6lF9poUp7bKT0/NHE8fPX23PwfhnykfqnC2xRxOnVw5XuGIaA==}
    engines: {node: '>=6'}
    hasBin: true

  json5@2.2.3:
    resolution: {integrity: sha512-XmOWe7eyHYH14cLdVPoyg+GOH3rYX++KpzrylJwSW98t3Nk+U8XOl8FWKOgwtzdb8lXGf6zYwDUzeHMWfxasyg==}
    engines: {node: '>=6'}
    hasBin: true

  lightningcss-android-arm64@1.33.0:
    resolution: {integrity: sha512-gEpRTalKdosp4Bb8qWtc2iOgE5SeIHlpS1up9bFq2wAyYhl1UdTObYiHe98zEM9SQvSoqQZ1IQD0JNpg3Ml5pg==}
    engines: {node: '>= 12.0.0'}
    cpu: [arm64]
    os: [android]

  lightningcss-darwin-arm64@1.33.0:
    resolution: {integrity: sha512-Sciaz8eenNTKn9b3t7+xr0ipTp9YxKQY4npwQ3mrRuL0BAVHBLyZxofhaKBAVtzmtRZ/zTyo0/to4B1uWG/Djg==}
    engines: {node: '>= 12.0.0'}
    cpu: [arm64]
    os: [darwin]

  lightningcss-darwin-x64@1.33.0:
    resolution: {integrity: sha512-Z5UPAxzrjlWNNyGy6i65cJzzvgJ5D3T6wMvs+gWpY9d7qRhANrxqAp6LhxIgZhWEw18RfJTGcRxjuLIBr+m8XQ==}
    engines: {node: '>= 12.0.0'}
    cpu: [x64]
    os: [darwin]

  lightningcss-freebsd-x64@1.33.0:
    resolution: {integrity: sha512-QQM/Ti/hQajJwCY+RiWuCZ9sdtI/XQk7nDK5vC8kkdwixezOlDgvDx7+RT+QjK6FcFT4MpsuoBnHIo/O3StRRg==}
    engines: {node: '>= 12.0.0'}
    cpu: [x64]
    os: [freebsd]

  lightningcss-linux-arm-gnueabihf@1.33.0:
    resolution: {integrity: sha512-N7FVBe6iS24MlM6R/4RBTxGhQheZGs7tiQ9U32UtF75NzP5Q7xWPRqLBCKxlRQRk3rY1jCIPLzx7WzOhuUIRLQ==}
    engines: {node: '>= 12.0.0'}
    cpu: [arm]
    os: [linux]

  lightningcss-linux-arm64-gnu@1.33.0:
    resolution: {integrity: sha512-j2v/itmy4HlNxlc6voKXYgBqNi0Ng2LShg4z7GufpEgs05P+2suBVyi9I6YHq5uoVFx9ETin3eCEhLVyXGQnKg==}
    engines: {node: '>= 12.0.0'}
    cpu: [arm64]
    os: [linux]
    libc: [glibc]

  lightningcss-linux-arm64-musl@1.33.0:
    resolution: {integrity: sha512-yiO5ROMuYQgXbC60yjZU5CYSFZGKXL0HFATXt9mHJn1+zW55oCtMI9NfcVhYLMFDL7gV7oBPon/EmMMGg2OvtQ==}
    engines: {node: '>= 12.0.0'}
    cpu: [arm64]
    os: [linux]
    libc: [musl]

  lightningcss-linux-x64-gnu@1.33.0:
    resolution: {integrity: sha512-ar+Ju7LmcN0Jo4FpL4hpFybwNG9/3A/Br5KW2n2jyODg3MEZXaDYADdemoNS+BDNfMgKvylJLj4S5tyRActuAg==}
    engines: {node: '>= 12.0.0'}
    cpu: [x64]
    os: [linux]
    libc: [glibc]

  lightningcss-linux-x64-musl@1.33.0:
    resolution: {integrity: sha512-RYiYbkokw0trfKqqzfF55lginwEPrD3OJDfTuJzFs1MK6iFnDenaz1fqLLtX4ITG3OktJQXOeTaw1awrBAlZPw==}
    engines: {node: '>= 12.0.0'}
    cpu: [x64]
    os: [linux]
    libc: [musl]

  lightningcss-win32-arm64-msvc@1.33.0:
    resolution: {integrity: sha512-1K+MPfLSFVpphzpdbfkhlWk6wBrTObBzS2T6db10PNOZgR9GoVsAWzwNyuhUYYbTp23j+4RrncfujZ4uAzXvwA==}
    engines: {node: '>= 12.0.0'}
    cpu: [arm64]
    os: [win32]

  lightningcss-win32-x64-msvc@1.33.0:
    resolution: {integrity: sha512-OlEICDx/Xl0FqSp4bry8zFnCvGpig3Gl4gCquvYwHuqJKEC1+n9NgDniFvqHGmMv1ZkqDJrDqKKSykTDX+ehuA==}
    engines: {node: '>= 12.0.0'}
    cpu: [x64]
    os: [win32]

  lightningcss@1.33.0:
    resolution: {integrity: sha512-WkUDrojuJs0xkgGf2udWxa3yGBRxPtxUkB79i6aCZLRgc7PM8fZe9TosfPDcvEpQZbuFASnHYmRLBLUbmLOIIA==}
    engines: {node: '>= 12.0.0'}

  lru-cache@5.1.1:
    resolution: {integrity: sha512-KpNARQA3Iwv+jTA0utUVVbrh+Jlrr1Fv0e56GGzAFOXN7dk/FviaDW8LHmK52DlcH4WP2n6gI8vN1aesBFgo9w==}

  magic-string@0.30.21:
    resolution: {integrity: sha512-vd2F4YUyEXKGcLHoq+TEyCjxueSeHnFxyyjNp80yg0XV4vUhnDer/lvvlqM/arB5bXQN5K2/3oinyCRyx8T2CQ==}

  magic-string@1.4.3:
    resolution: {integrity: sha512-z12OxmaPGE0F4xlpGdjuAUckipLpQlTAuAmyGhNoD7ODpYUzvDfvtxUbjM/jwznyP178oju/KDdyi220wNJ0RQ==}

  ms@2.1.3:
    resolution: {integrity: sha512-6FlzubTLZG3J2a/NVCAleEhjzq5oxgHyaCU9yYXvcLsvoVaHJq/s5xXI6/XXP6tz7R9xAOtHnSO/tXtF3WRTlA==}

  nanoid@3.3.20:
    resolution: {integrity: sha512-uKdg2G3GNCKQn9byYOpxbGqrT2fGO5KRt5J/8b3pok8rT6qxGWF6hxMyJiEYtAf+FVyYuD9hRaDqX5uPFYJ4ZQ==}
    engines: {node: ^10 || ^12 || ^13.7 || ^14 || >=15.0.1}
    hasBin: true

  nf3@0.3.24:
    resolution: {integrity: sha512-HxLK4bo+5jNsEETZp4w3tJblHOA9MCBY14IN9nZJJV8JDxt9yNIYxuBuLMjTAR5GFa3HL61+8VQDUrXv3/C8fw==}

  nitro@3.0.260610-beta:
    resolution: {integrity: sha512-KPb4L5yaF/Rx/xoGMpgHRJvZhbhGiqbRKOwwPLCH9jKTKTsEUHLjnJas85AeCzaswqa8Wi52eQBtRsODC4PS0Q==}
    engines: {node: ^20.19.0 || >=22.12.0}
    hasBin: true
    peerDependencies:
      '@vercel/queue': ^0.3.0
      dotenv: '*'
      giget: '*'
      jiti: ^2.7.0
      rollup: ^4.61.1
      vite: ^7 || ^8
      xml2js: ^0.6.2
      zephyr-agent: ^0.2.0
    peerDependenciesMeta:
      '@vercel/queue':
        optional: true
      dotenv:
        optional: true
      giget:
        optional: true
      jiti:
        optional: true
      rollup:
        optional: true
      vite:
        optional: true
      xml2js:
        optional: true
      zephyr-agent:
        optional: true

  node-releases@2.0.59:
    resolution: {integrity: sha512-5qr2okC4ItAI0hG5SaV0HoYMpnM/Y6+Oqr7AmPYy/2uEoGvS+GbSKLeRxSS1uAdu59yz0ouzcuXievSgg///WA==}
    engines: {node: '>=18'}

  obug@3.0.0:
    resolution: {integrity: sha512-5vvB5+W7ePv+p3uqxi+RcW1XAzLW0/hxt3/4X4Lc4qHudzOhmBiBwOY6DRob4WnanAEGvNcLjF+KNOufrUoEQw==}
    engines: {node: '>=12.20.0'}

  ocache@0.1.5:
    resolution: {integrity: sha512-kNNnkkVQup/QDvmTz8Q84wc2ntiyoVHDxa6eHWKt5qdGAmFRBIxy83rxgCYEjW0x06UJ9E3P6VgM2yY4rOBH4w==}

  ofetch@2.0.0-alpha.3:
    resolution: {integrity: sha512-zpYTCs2byOuft65vI3z43Dd6iSdFbOZZLb9/d21aCpx2rGastVU9dOCv0lu4ykc1Ur1anAYjDi3SUvR0vq50JA==}

  ohash@2.0.12:
    resolution: {integrity: sha512-65S/5gk9YSsaRjcyf7Nfa6h/d3E8/1gslpXfI4W7Dxn/oap8IKRuNT5VXkLQ1YFKIEg4apRY4Pj6aiwFzrDdmw==}

  pathe@2.0.3:
    resolution: {integrity: sha512-WUjGcAqP1gQacoQe+OBJsFA7Ld4DyXuUIjZ5cc75cLHvJ7dtNsTugphxIADwspS+AraAUePCKrSVtPLFj/F88w==}

  picocolors@1.1.1:
    resolution: {integrity: sha512-xceH2snhtb5M9liqDsmEw56le376mTZkEX/jEb/RxNFyegNul7eNslCXP9FDj/Lcu0X8KEyMceP2ntpaHrDEVA==}

  picomatch@4.0.7:
    resolution: {integrity: sha512-qcJu88Q2IWqJsDD529JKMdwGm/dvInW4HvQnRwiH9JtihJvzGOscDtHE3x1pBKeUOTysQ8kVmLnJ2kJu7yhcGA==}
    engines: {node: '>=12'}

  playwright-core@1.64.1:
    resolution: {integrity: sha512-BC4s8y6SEVA6Q1rSxZTto8hI1KUI3xXlHGZgvGqP4IqPdI/a6FX9H29IDNz7vKo9l21b6LfYosScPL6M3xxyDQ==}
    engines: {node: '>=20'}
    hasBin: true

  postcss@8.5.30:
    resolution: {integrity: sha512-zkd+e9S1AQHhmaBKye9zlFHWjOwVgqXl1q3ECYy8561K7qxR2cREf/STLskulBFd78k6AOFeA+ff1TtEzk9bAA==}
    engines: {node: ^10 || ^12 || >=14}

  postgres@3.4.9:
    resolution: {integrity: sha512-GD3qdB0x1z9xgFI6cdRD6xu2Sp2WCOEoe3mtnyB5Ee0XrrL5Pe+e4CCnJrRMnL1zYtRDZmQQVbvOttLnKDLnaw==}
    engines: {node: '>=12'}

  prettier@3.9.10:
    resolution: {integrity: sha512-skGHTH1Yb9QvaTC4hWnRTzEYtCpApF0UMBPz+t/0ZPzP8ihefo/btKd+QA7pUE0fEwA1SbS/NmhyEcstdXOIdA==}
    engines: {node: '>=14'}
    hasBin: true

  react-dom@19.3.1:
    resolution: {integrity: sha512-Y0bARz53lhEC1NMCASs0/j+faB/zqt3R8hpvg1e8+61ZVJ4UL0UdC4cBbXfZMcIuhrfgeILTLe+ZeBCavQPtKQ==}
    peerDependencies:
      react: ^19.3.1

  react-is@19.3.1:
    resolution: {integrity: sha512-RRieF6IyxQBkcK6pP8xOHprLTPW6QjRkbGdImtqNme+/hYVwCZkLQLdlZGOhUqXwkS9IEynaGvPJtv6XB/cz0Q==}

  react-redux@9.3.0:
    resolution: {integrity: sha512-KQopgqFo/p/fgmAs5qz6p5RWaNAzq40WAu7fJIXnQpYxFPbJYtsJPWvGeF2rOBaY/kEuV77AVsX8TsQzKm+A/g==}
    peerDependencies:
      '@types/react': ^18.2.25 || ^19
      react: ^18.0 || ^19
      redux: ^5.0.0
    peerDependenciesMeta:
      '@types/react':
        optional: true
      redux:
        optional: true

  react@19.3.1:
    resolution: {integrity: sha512-QNhWdt7nrgVWWQG58QuGsAR3jv3Hbe4mb4vz7w2csnHavciZJgda1CPNaldF6eVxv90ud3jUXpKlHL69gO38yw==}
    engines: {node: '>=0.10.0'}

  readdirp@5.1.1:
    resolution: {integrity: sha512-Kko+Y5XQ6fM+Ce3dq3m9YGxnacYZYl9cA1wZjaF3Vbry2L3i1qVg8+CAgNPsXRArPMUMCaOR7oa9Nqntc43JKA==}
    engines: {node: '>= 20.19.0'}

  recharts@3.10.1:
    resolution: {integrity: sha512-QXFrvt6IVcw7eeZCoyXTwkIJAX3Dv1nyVhMicXJ47GsGDDpcN8z6o644DibE9XjpBTThtsomLKnTV6lc+cVFUA==}
    engines: {node: '>=18'}
    peerDependencies:
      react: ^16.8.0 || ^17.0.0 || ^18.0.0 || ^19.0.0
      react-dom: ^16.0.0 || ^17.0.0 || ^18.0.0 || ^19.0.0
      react-is: ^16.8.0 || ^17.0.0 || ^18.0.0 || ^19.0.0

  redux-thunk@3.1.0:
    resolution: {integrity: sha512-NW2r5T6ksUKXCabzhL9z+h206HQw/NJkcLm1GPImRQ8IzfXwRGqjVhKJGauHirT0DAuyy6hjdnMZaRoAcy0Klw==}
    peerDependencies:
      redux: ^5.0.0

  redux@5.0.1:
    resolution: {integrity: sha512-M9/ELqF6fy8FwmkpnF0S3YKOqMyoWJ4+CS5Efg2ct3oY9daQvd/Pc71FpGZsVsbl3Cpb+IIcjBDUnnyBdQbq4w==}

  reselect@5.2.0:
    resolution: {integrity: sha512-AgZ3UOZm3YndfrJ4OYjgrT7bmCm/1iqkjvEfH/oYjzh6PD2qw4QuT3jjnXIrpdt4MTpMXclMT3lXbmRY+XRakw==}

  rolldown@1.2.14:
    resolution: {integrity: sha512-eTBTTqMR6uHKLgcUqpJP8ntzDI6V4LYA8negAMBEI7gkgVvOdrx6VsvS2Ym+83KhOPdLCHWJu0w7UQFJZhHKNw==}
    engines: {node: ^20.19.0 || >=22.12.0}
    hasBin: true

  rou3@0.8.1:
    resolution: {integrity: sha512-ePa+XGk00/3HuCqrEnK3LxJW7I0SdNg6EFzKUJG73hMAdDcOUC/i/aSz7LSDwLrGr33kal/rqOGydzwl6U7zBA==}

  scheduler@0.28.0:
    resolution: {integrity: sha512-juorfCmIkIw8tT+p5BXSm6PJjQF/ycEYmKyzURCIt/RaZIhL+PulbQ9Yu2z1HdOJDdqDTlxA1+xKBmHXJsczAw==}

  semver@6.3.1:
    resolution: {integrity: sha512-BR7VvDCVHO+q2xBEWskxS6DJE1qRnb7DxzUrogb71CWoSficBxYsiAGd+Kl0mmq/MprG9yArRkyrQxTO6XjMzA==}
    hasBin: true

  seroval-plugins@1.6.9:
    resolution: {integrity: sha512-kiDK/Tb8IWZ61WEU8pA2PDmAuw37gKph9Y77OZlD56mg0Y2g0Bg7gZ1HeHhs5d40w+nRoUq/wj08V26ilbez9g==}
    engines: {node: '>=10'}
    peerDependencies:
      seroval: ^1.0

  seroval@1.6.9:
    resolution: {integrity: sha512-UeEzHwAK+yl0YLbsvROV1t5yMYEwZZ0CfKYxDvUgS2fO9Vxdf8djqVIB+OuVpuawRNPqw68LE1Du/GMsW2ZPqA==}
    engines: {node: '>=10'}

  source-map-js@1.2.2:
    resolution: {integrity: sha512-KGj/8Y43x35aZVDtt+J4mK1hoLGHULMYfSkODJNQjNDC3oW1PqPoxMwo0pLUsWM/UEGzON/NxeHywEfNXNP3Vw==}
    engines: {node: '>=0.10.0'}

  source-map@0.7.6:
    resolution: {integrity: sha512-i5uvt8C3ikiWeNZSVZNWcfZPItFQOsYTUAOkcUPGd8DqDy1uOUikjt5dG+uRlwyvR108Fb9DOd4GvXfT0N2/uQ==}
    engines: {node: '>= 12'}

  srvx@0.11.22:
    resolution: {integrity: sha512-LqZxxBDMKuMAZzFzJnDCkFOrs9MZQZr0LvHiO/SuSZVdQaXD7xQ5UWTUxheJrQPve1qk9MG2B/yttUvJxw8egQ==}
    engines: {node: '>=20.16.0'}
    hasBin: true

  srvx@1.0.5:
    resolution: {integrity: sha512-KvSKRpgPG/oaq3cyT614OQ2bAa7DynuGamivCZeoZzIUULOdbQz6wUtnnVuC4+DCx2Zglzo8v5gBYmWIWYhDxA==}
    engines: {node: '>=20.16.0'}
    hasBin: true

  std-env@4.3.0:
    resolution: {integrity: sha512-OtU/EgQ1kIm5KwqQpBC6ZEMXrZRui11w8zgfTWp8cdO9B8OaPsbA8bTHO2P+HNo1VlUTGMVBwPhydu6poeXiag==}

  tiny-invariant@1.3.3:
    resolution: {integrity: sha512-+FbBPE1o9QAYvviau/qC5SE3caw21q3xkvWKBtja5vgqOWIHHJ3ioaq1VPfn/Szqctz2bU/oYeKd9/z5BL+PVg==}

  tinybench@6.2.2:
    resolution: {integrity: sha512-nIZ2N2dFpjBsg2hgitKu7mA+FvsIJuGJOwysRngmVRRmWgR/UyPjwJj8c/fT/dhm8EkHnF5EOogRf+0Z2qrimA==}
    engines: {node: '>=20.0.0'}

  tinyexec@1.3.1:
    resolution: {integrity: sha512-GCvB3aoys96IuDFBMcTB46JOR6mdMtAToqwiW8JlWhsoh1mhHi/xn9ss/Dg7N555GiJyEt2qzoG/NHCwM6h1EA==}
    engines: {node: '>=18'}

  tinyglobby@0.2.17:
    resolution: {integrity: sha512-wXR/dYpcqKmfWpEdZjiKJOwCNFndD0DMnrW/cYjVGttEkBfVgcLFHoNrlj47mjOVic9yyNu65alsgF4NQyTa2g==}
    engines: {node: '>=12.0.0'}

  typescript@6.0.3:
    resolution: {integrity: sha512-y2TvuxSZPDyQakkFRPZHKFm+KKVqIisdg9/CZwm9ftvKXLP8NRWj38/ODjNbr43SsoXqNuAisEf1GdCxqWcdBw==}
    engines: {node: '>=14.17'}
    hasBin: true

  ufo@1.6.4:
    resolution: {integrity: sha512-JFNbkD1Svwe0KvGi8GOeLcP4kAWQ609twvCdcHxq1oSL8svv39ZuSvajcD8B+5D0eL4+s1Is2D/O6KN3qcTeRA==}

  undici-types@6.21.0:
    resolution: {integrity: sha512-iwDZqg0QAGrg9Rav5H4n0M64c3mkR59cJ6wQp+7C4nI0gsmExaedaYLNO44eT4AtBBwjbTiGPMlt2Md0T9H9JQ==}

  unenv@2.0.0-rc.24:
    resolution: {integrity: sha512-i7qRCmY42zmCwnYlh9H2SvLEypEFGye5iRmEMKjcGi7zk9UquigRjFtTLz0TYqr0ZGLZhaMHl/foy1bZR+Cwlw==}

  unplugin@3.4.0:
    resolution: {integrity: sha512-9skdIFlCsPdFV7wUfZxNsFInlW+7nJmGu2gkTu0OUhF56aXGsHab9x52/QhdJ4lC7ZDPWTxbiC4ANqVlsuaW3w==}
    engines: {node: ^20.19.0 || >=22.12.0}
    peerDependencies:
      '@farmfe/core': '*'
      '@rsbuild/core': '*'
      '@rspack/core': '*'
      bun-types-no-globals: '*'
      esbuild: '*'
      rolldown: '*'
      rollup: '*'
      unloader: '*'
      vite: '*'
      webpack: '*'
    peerDependenciesMeta:
      '@farmfe/core':
        optional: true
      '@rsbuild/core':
        optional: true
      '@rspack/core':
        optional: true
      bun-types-no-globals:
        optional: true
      esbuild:
        optional: true
      rolldown:
        optional: true
      rollup:
        optional: true
      unloader:
        optional: true
      vite:
        optional: true
      webpack:
        optional: true

  unstorage@2.0.0-alpha.7:
    resolution: {integrity: sha512-ELPztchk2zgFJnakyodVY3vJWGW9jy//keJ32IOJVGUMyaPydwcA1FtVvWqT0TNRch9H+cMNEGllfVFfScImog==}
    peerDependencies:
      '@azure/app-configuration': ^1.11.0
      '@azure/cosmos': ^4.9.1
      '@azure/data-tables': ^13.3.2
      '@azure/identity': ^4.13.0
      '@azure/keyvault-secrets': ^4.10.0
      '@azure/storage-blob': ^12.31.0
      '@capacitor/preferences': ^6 || ^7 || ^8
      '@deno/kv': '>=0.13.0'
      '@netlify/blobs': ^6.5.0 || ^7.0.0 || ^8.1.0 || ^9.0.0 || ^10.0.0
      '@planetscale/database': ^1.19.0
      '@upstash/redis': ^1.36.2
      '@vercel/blob': '>=0.27.3'
      '@vercel/functions': ^2.2.12 || ^3.0.0
      '@vercel/kv': ^1.0.1
      aws4fetch: ^1.0.20
      chokidar: ^4 || ^5
      db0: '>=0.3.4'
      idb-keyval: ^6.2.2
      ioredis: ^5.9.3
      lru-cache: ^11.2.6
      mongodb: ^6 || ^7
      ofetch: '*'
      uploadthing: ^7.7.4
    peerDependenciesMeta:
      '@azure/app-configuration':
        optional: true
      '@azure/cosmos':
        optional: true
      '@azure/data-tables':
        optional: true
      '@azure/identity':
        optional: true
      '@azure/keyvault-secrets':
        optional: true
      '@azure/storage-blob':
        optional: true
      '@capacitor/preferences':
        optional: true
      '@deno/kv':
        optional: true
      '@netlify/blobs':
        optional: true
      '@planetscale/database':
        optional: true
      '@upstash/redis':
        optional: true
      '@vercel/blob':
        optional: true
      '@vercel/functions':
        optional: true
      '@vercel/kv':
        optional: true
      aws4fetch:
        optional: true
      chokidar:
        optional: true
      db0:
        optional: true
      idb-keyval:
        optional: true
      ioredis:
        optional: true
      lru-cache:
        optional: true
      mongodb:
        optional: true
      ofetch:
        optional: true
      uploadthing:
        optional: true

  update-browserslist-db@1.3.4:
    resolution: {integrity: sha512-t8wonIOdQyOjtPd2VktlBu6QjTVTks6v8bSi7kd0r2Vll8TK1JYDZtRRdbmCHOAMphkZgrzK+L+vXK4pyZ8t4A==}
    hasBin: true
    peerDependencies:
      browserslist: '>= 4.21.0'

  use-sync-external-store@1.7.0:
    resolution: {integrity: sha512-6L+EeigHMQhdaIPNIFUKwfWJSwWFQ8gJbJ2DLOs5sDIegTwR9fRxvnM3uciHKjIZhFz+KAv2emhWMRvDmMcY8A==}
    peerDependencies:
      react: ^16.8.0 || ^17.0.0 || ^18.0.0 || ^19.0.0

  victory-vendor@37.3.6:
    resolution: {integrity: sha512-SbPDPdDBYp+5MJHhBCAyI7wKM3d5ivekigc2Dk2s7pgbZ9wIgIBYGVw4zGHBml/qTFbexrofXW6Gu4noGxrOwQ==}

  vite@8.3.4:
    resolution: {integrity: sha512-IftLE8phJhdNRIGNEV4JCCvfNScoZQVfcXaN8TQropWGJtOHcu+iAB9pHcuGvmEb/kddw0LBe/jS8ztdC6xdiQ==}
    engines: {node: ^20.19.0 || >=22.12.0}
    hasBin: true
    peerDependencies:
      '@types/node': ^20.19.0 || >=22.12.0
      '@vitejs/devtools': ^0.7.1
      esbuild: ^0.27.0 || ^0.28.0
      jiti: '>=1.21.0'
      less: ^4.0.0
      sass: ^1.70.0
      sass-embedded: ^1.70.0
      stylus: '>=0.54.8'
      sugarss: ^5.0.0
      terser: ^5.16.0
      tsx: ^4.8.1
      yaml: ^2.4.2
    peerDependenciesMeta:
      '@types/node':
        optional: true
      '@vitejs/devtools':
        optional: true
      esbuild:
        optional: true
      jiti:
        optional: true
      less:
        optional: true
      sass:
        optional: true
      sass-embedded:
        optional: true
      stylus:
        optional: true
      sugarss:
        optional: true
      terser:
        optional: true
      tsx:
        optional: true
      yaml:
        optional: true

  vitefu@1.1.3:
    resolution: {integrity: sha512-ub4okH7Z5KLjb6hDyjqrGXqWtWvoYdU3IGm/NorpgHncKoLTCfRIbvlhBm7r0YstIaQRYlp4yEbFqDcKSzXSSg==}
    peerDependencies:
      vite: ^3.0.0 || ^4.0.0 || ^5.0.0 || ^6.0.0 || ^7.0.0 || ^8.0.0
    peerDependenciesMeta:
      vite:
        optional: true

  vitest@5.0.5:
    resolution: {integrity: sha512-cPODOMF8YnkiiYtDdHo6n4wWmBrOBBbOIYH2d33M4l3CdNn72h+qMmO6uXffUN6A5AZFXNND/d+krS9mgkXRfg==}
    engines: {node: ^22.12.0 || ^24.0.0 || >=26.0.0}
    hasBin: true
    peerDependencies:
      '@edge-runtime/vm': '*'
      '@opentelemetry/api': ^1.9.0
      '@types/node': ^22.0.0 || >=24.0.0
      '@vitest/browser-playwright': 5.0.5
      '@vitest/browser-preview': 5.0.5
      '@vitest/browser-webdriverio': ^5.0.0-beta.5 || >=5.0.0
      '@vitest/coverage-istanbul': 5.0.5
      '@vitest/coverage-v8': 5.0.5
      '@vitest/ui': 5.0.5
      happy-dom: '*'
      jsdom: '*'
      vite: ^6.4.0 || ^7.0.0 || ^8.0.0
    peerDependenciesMeta:
      '@edge-runtime/vm':
        optional: true
      '@opentelemetry/api':
        optional: true
      '@types/node':
        optional: true
      '@vitest/browser-playwright':
        optional: true
      '@vitest/browser-preview':
        optional: true
      '@vitest/browser-webdriverio':
        optional: true
      '@vitest/coverage-istanbul':
        optional: true
      '@vitest/coverage-v8':
        optional: true
      '@vitest/ui':
        optional: true
      happy-dom:
        optional: true
      jsdom:
        optional: true

  webpack-virtual-modules@0.6.2:
    resolution: {integrity: sha512-66/V2i5hQanC51vBQKPH4aI8NMAcBW59FVBs+rC7eGHupMyfn34q7rZIE+ETlJ+XTevqfUhVVBgSUNSW2flEUQ==}

  why-is-node-running@3.2.1:
    resolution: {integrity: sha512-Tb2FUhB4vUsGQlfSquQLYkApkuPAFQXGFzxWKHHumVz2dK+X1RUm/HnID4+TfIGYJ1kTcwOaCk/buYCEJr6YjQ==}
    engines: {node: '>=20.11'}
    hasBin: true

  xmlbuilder2@4.0.3:
    resolution: {integrity: sha512-bx8Q1STctnNaaDymWnkfQLKofs0mGNN7rLLapJlGuV3VlvegD7Ls4ggMjE3aUSWItCCzU0PEv45lI87iSigiCA==}
    engines: {node: '>=20.0'}

  yallist@3.1.1:
    resolution: {integrity: sha512-a4UGQaWPH59mOXUYnAG2ewncQS4i4F43Tv3JoAM+s2VDAmS9NsK8GpDMLrCHPksFT7h3K6TOoUNn2pb7RoXx4g==}

  zod@4.6.7:
    resolution: {integrity: sha512-g8W2D2kU6a8untc053fX1uVBKzM7yqAxW/3zwk83+6RyF2+SKOuV+c0wBDhUwzV1PaGapmZH+rmcUzPf+3CGwg==}

snapshots:

  '@babel/code-frame@7.29.7':
    dependencies:
      '@babel/helper-validator-identifier': 7.29.7
      js-tokens: 4.0.0
      picocolors: 1.1.1

  '@babel/compat-data@7.29.7': {}

  '@babel/core@7.29.7':
    dependencies:
      '@babel/code-frame': 7.29.7
      '@babel/generator': 7.29.8
      '@babel/helper-compilation-targets': 7.29.7
      '@babel/helper-module-transforms': 7.29.7(@babel/core@7.29.7)
      '@babel/helpers': 7.29.10
      '@babel/parser': 7.29.9
      '@babel/template': 7.29.7
      '@babel/traverse': 7.29.10
      '@babel/types': 7.29.8
      '@jridgewell/remapping': 2.3.5
      convert-source-map: 2.0.0
      debug: 4.4.3
      gensync: 1.0.0-beta.2
      json5: 2.2.3
      semver: 6.3.1
    transitivePeerDependencies:
      - supports-color

  '@babel/generator@7.29.8':
    dependencies:
      '@babel/parser': 7.29.9
      '@babel/types': 7.29.8
      '@jridgewell/gen-mapping': 0.3.13
      '@jridgewell/trace-mapping': 0.3.31
      jsesc: 3.1.0

  '@babel/helper-compilation-targets@7.29.7':
    dependencies:
      '@babel/compat-data': 7.29.7
      '@babel/helper-validator-option': 7.29.7
      browserslist: 4.29.3
      lru-cache: 5.1.1
      semver: 6.3.1

  '@babel/helper-globals@7.29.7': {}

  '@babel/helper-module-imports@7.29.7':
    dependencies:
      '@babel/traverse': 7.29.10
      '@babel/types': 7.29.8
    transitivePeerDependencies:
      - supports-color

  '@babel/helper-module-transforms@7.29.7(@babel/core@7.29.7)':
    dependencies:
      '@babel/core': 7.29.7
      '@babel/helper-module-imports': 7.29.7
      '@babel/helper-validator-identifier': 7.29.7
      '@babel/traverse': 7.29.10
    transitivePeerDependencies:
      - supports-color

  '@babel/helper-string-parser@7.29.7': {}

  '@babel/helper-validator-identifier@7.29.7': {}

  '@babel/helper-validator-option@7.29.7': {}

  '@babel/helpers@7.29.10':
    dependencies:
      '@babel/template': 7.29.7
      '@babel/types': 7.29.8

  '@babel/parser@7.29.9':
    dependencies:
      '@babel/types': 7.29.8

  '@babel/template@7.29.7':
    dependencies:
      '@babel/code-frame': 7.29.7
      '@babel/parser': 7.29.9
      '@babel/types': 7.29.8

  '@babel/traverse@7.29.10':
    dependencies:
      '@babel/code-frame': 7.29.7
      '@babel/generator': 7.29.8
      '@babel/helper-globals': 7.29.7
      '@babel/parser': 7.29.9
      '@babel/template': 7.29.7
      '@babel/types': 7.29.8
      debug: 4.4.3
    transitivePeerDependencies:
      - supports-color

  '@babel/types@7.29.8':
    dependencies:
      '@babel/helper-string-parser': 7.29.7
      '@babel/helper-validator-identifier': 7.29.7

  '@electric-sql/pglite-age@0.0.12(@electric-sql/pglite@0.5.11)':
    dependencies:
      '@electric-sql/pglite': 0.5.11

  '@electric-sql/pglite-pg_hashids@0.0.12(@electric-sql/pglite@0.5.11)':
    dependencies:
      '@electric-sql/pglite': 0.5.11

  '@electric-sql/pglite-pg_ivm@0.0.12(@electric-sql/pglite@0.5.11)':
    dependencies:
      '@electric-sql/pglite': 0.5.11

  '@electric-sql/pglite-pg_textsearch@0.0.13(@electric-sql/pglite@0.5.11)':
    dependencies:
      '@electric-sql/pglite': 0.5.11

  '@electric-sql/pglite-pg_uuidv7@0.0.12(@electric-sql/pglite@0.5.11)':
    dependencies:
      '@electric-sql/pglite': 0.5.11

  '@electric-sql/pglite-pgtap@0.0.12(@electric-sql/pglite@0.5.11)':
    dependencies:
      '@electric-sql/pglite': 0.5.11

  '@electric-sql/pglite-pgvector@0.0.12(@electric-sql/pglite@0.5.11)':
    dependencies:
      '@electric-sql/pglite': 0.5.11

  '@electric-sql/pglite-socket@0.2.14(@electric-sql/pglite-age@0.0.12(@electric-sql/pglite@0.5.11))(@electric-sql/pglite-pg_hashids@0.0.12(@electric-sql/pglite@0.5.11))(@electric-sql/pglite-pg_ivm@0.0.12(@electric-sql/pglite@0.5.11))(@electric-sql/pglite-pg_textsearch@0.0.13(@electric-sql/pglite@0.5.11))(@electric-sql/pglite-pg_uuidv7@0.0.12(@electric-sql/pglite@0.5.11))(@electric-sql/pglite-pgtap@0.0.12(@electric-sql/pglite@0.5.11))(@electric-sql/pglite-pgvector@0.0.12(@electric-sql/pglite@0.5.11))(@electric-sql/pglite@0.5.11)':
    dependencies:
      '@electric-sql/pglite': 0.5.11
      '@electric-sql/pglite-age': 0.0.12(@electric-sql/pglite@0.5.11)
      '@electric-sql/pglite-pg_hashids': 0.0.12(@electric-sql/pglite@0.5.11)
      '@electric-sql/pglite-pg_ivm': 0.0.12(@electric-sql/pglite@0.5.11)
      '@electric-sql/pglite-pg_textsearch': 0.0.13(@electric-sql/pglite@0.5.11)
      '@electric-sql/pglite-pg_uuidv7': 0.0.12(@electric-sql/pglite@0.5.11)
      '@electric-sql/pglite-pgtap': 0.0.12(@electric-sql/pglite@0.5.11)
      '@electric-sql/pglite-pgvector': 0.0.12(@electric-sql/pglite@0.5.11)

  '@electric-sql/pglite@0.5.11': {}

  '@jridgewell/gen-mapping@0.3.13':
    dependencies:
      '@jridgewell/sourcemap-codec': 1.6.0
      '@jridgewell/trace-mapping': 0.3.31

  '@jridgewell/remapping@2.3.5':
    dependencies:
      '@jridgewell/gen-mapping': 0.3.13
      '@jridgewell/trace-mapping': 0.3.31

  '@jridgewell/resolve-uri@3.1.2': {}

  '@jridgewell/sourcemap-codec@1.6.0': {}

  '@jridgewell/trace-mapping@0.3.31':
    dependencies:
      '@jridgewell/resolve-uri': 3.1.2
      '@jridgewell/sourcemap-codec': 1.6.0

  '@oozcitak/dom@2.0.2':
    dependencies:
      '@oozcitak/infra': 2.0.2
      '@oozcitak/url': 3.0.0
      '@oozcitak/util': 10.0.0

  '@oozcitak/infra@2.0.2':
    dependencies:
      '@oozcitak/util': 10.0.0

  '@oozcitak/url@3.0.0':
    dependencies:
      '@oozcitak/infra': 2.0.2
      '@oozcitak/util': 10.0.0

  '@oozcitak/util@10.0.0': {}

  '@oxc-project/types@0.154.0': {}

  '@reduxjs/toolkit@2.13.0(react-redux@9.3.0(@types/react@19.3.0)(react@19.3.1)(redux@5.0.1))(react@19.3.1)':
    dependencies:
      '@standard-schema/spec': 1.1.0
      '@standard-schema/utils': 0.3.0
      immer: 11.1.21
      redux: 5.0.1
      redux-thunk: 3.1.0(redux@5.0.1)
      reselect: 5.2.0
    optionalDependencies:
      react: 19.3.1
      react-redux: 9.3.0(@types/react@19.3.0)(react@19.3.1)(redux@5.0.1)

  '@rolldown/binding-android-arm-eabi@1.2.14':
    optional: true

  '@rolldown/binding-android-arm64@1.2.14':
    optional: true

  '@rolldown/binding-darwin-arm64@1.2.14':
    optional: true

  '@rolldown/binding-darwin-x64@1.2.14':
    optional: true

  '@rolldown/binding-freebsd-x64@1.2.14':
    optional: true

  '@rolldown/binding-linux-arm-gnueabihf@1.2.14':
    optional: true

  '@rolldown/binding-linux-arm64-gnu@1.2.14':
    optional: true

  '@rolldown/binding-linux-arm64-musl@1.2.14':
    optional: true

  '@rolldown/binding-linux-ppc64-gnu@1.2.14':
    optional: true

  '@rolldown/binding-linux-s390x-gnu@1.2.14':
    optional: true

  '@rolldown/binding-linux-x64-gnu@1.2.14':
    optional: true

  '@rolldown/binding-linux-x64-musl@1.2.14':
    optional: true

  '@rolldown/binding-openharmony-arm64@1.2.14':
    optional: true

  '@rolldown/binding-win32-arm64-msvc@1.2.14':
    optional: true

  '@rolldown/binding-win32-x64-msvc@1.2.14':
    optional: true

  '@rolldown/pluginutils@1.0.1': {}

  '@standard-schema/spec@1.1.0': {}

  '@standard-schema/utils@0.3.0': {}

  '@tanstack/history@1.162.5': {}

  '@tanstack/react-router@1.170.44(react-dom@19.3.1(react@19.3.1))(react@19.3.1)':
    dependencies:
      '@tanstack/history': 1.162.5
      '@tanstack/react-store': 0.11.2(react-dom@19.3.1(react@19.3.1))(react@19.3.1)
      '@tanstack/router-core': 1.171.37
      isbot: 5.2.2
      react: 19.3.1
      react-dom: 19.3.1(react@19.3.1)

  '@tanstack/react-start-client@1.168.42(react-dom@19.3.1(react@19.3.1))(react@19.3.1)':
    dependencies:
      '@tanstack/react-router': 1.170.44(react-dom@19.3.1(react@19.3.1))(react@19.3.1)
      '@tanstack/router-core': 1.171.37
      '@tanstack/start-client-core': 1.170.37
      react: 19.3.1
      react-dom: 19.3.1(react@19.3.1)

  '@tanstack/react-start-rsc@0.1.63(react-dom@19.3.1(react@19.3.1))(react@19.3.1)(rolldown@1.2.14)(vite@8.3.4(@types/node@22.20.5)(jiti@2.7.0))':
    dependencies:
      '@tanstack/react-router': 1.170.44(react-dom@19.3.1(react@19.3.1))(react@19.3.1)
      '@tanstack/router-core': 1.171.37
      '@tanstack/router-utils': 1.162.4
      '@tanstack/start-client-core': 1.170.37
      '@tanstack/start-fn-stubs': 1.162.0
      '@tanstack/start-plugin-core': 1.171.53(@tanstack/react-router@1.170.44(react-dom@19.3.1(react@19.3.1))(react@19.3.1))(rolldown@1.2.14)(vite@8.3.4(@types/node@22.20.5)(jiti@2.7.0))
      '@tanstack/start-storage-context': 1.167.39
      pathe: 2.0.3
      react: 19.3.1
      react-dom: 19.3.1(react@19.3.1)
    transitivePeerDependencies:
      - '@farmfe/core'
      - '@rsbuild/core'
      - bun-types-no-globals
      - esbuild
      - rolldown
      - rollup
      - supports-color
      - unloader
      - vite
      - vite-plugin-solid
      - webpack

  '@tanstack/react-start-server@1.167.50(react-dom@19.3.1(react@19.3.1))(react@19.3.1)':
    dependencies:
      '@tanstack/react-router': 1.170.44(react-dom@19.3.1(react@19.3.1))(react@19.3.1)
      '@tanstack/router-core': 1.171.37
      '@tanstack/start-server-core': 1.169.43
      react: 19.3.1
      react-dom: 19.3.1(react@19.3.1)

  '@tanstack/react-start@1.169.2(react-dom@19.3.1(react@19.3.1))(react@19.3.1)(rolldown@1.2.14)(vite@8.3.4(@types/node@22.20.5)(jiti@2.7.0))':
    dependencies:
      '@tanstack/react-router': 1.170.44(react-dom@19.3.1(react@19.3.1))(react@19.3.1)
      '@tanstack/react-start-client': 1.168.42(react-dom@19.3.1(react@19.3.1))(react@19.3.1)
      '@tanstack/react-start-rsc': 0.1.63(react-dom@19.3.1(react@19.3.1))(react@19.3.1)(rolldown@1.2.14)(vite@8.3.4(@types/node@22.20.5)(jiti@2.7.0))
      '@tanstack/react-start-server': 1.167.50(react-dom@19.3.1(react@19.3.1))(react@19.3.1)
      '@tanstack/router-utils': 1.162.4
      '@tanstack/start-client-core': 1.170.37
      '@tanstack/start-plugin-core': 1.171.53(@tanstack/react-router@1.170.44(react-dom@19.3.1(react@19.3.1))(react@19.3.1))(rolldown@1.2.14)(vite@8.3.4(@types/node@22.20.5)(jiti@2.7.0))
      '@tanstack/start-server-core': 1.169.43
      pathe: 2.0.3
      react: 19.3.1
      react-dom: 19.3.1(react@19.3.1)
    optionalDependencies:
      vite: 8.3.4(@types/node@22.20.5)(jiti@2.7.0)
    transitivePeerDependencies:
      - '@farmfe/core'
      - '@rspack/core'
      - bun-types-no-globals
      - esbuild
      - react-server-dom-rspack
      - rolldown
      - rollup
      - supports-color
      - unloader
      - vite-plugin-solid
      - webpack

  '@tanstack/react-store@0.11.2(react-dom@19.3.1(react@19.3.1))(react@19.3.1)':
    dependencies:
      '@tanstack/store': 0.11.2
      react: 19.3.1
      react-dom: 19.3.1(react@19.3.1)
      use-sync-external-store: 1.7.0(react@19.3.1)

  '@tanstack/router-cli@1.167.44':
    dependencies:
      '@tanstack/router-generator': 1.167.44
      cac: 7.1.0
      chokidar: 5.0.0
    transitivePeerDependencies:
      - supports-color

  '@tanstack/router-core@1.171.37':
    dependencies:
      '@tanstack/history': 1.162.5
      cookie-es: 3.1.1
      seroval: 1.6.9
      seroval-plugins: 1.6.9(seroval@1.6.9)

  '@tanstack/router-generator@1.167.44':
    dependencies:
      '@babel/types': 7.29.8
      '@tanstack/router-core': 1.171.37
      '@tanstack/router-utils': 1.162.4
      '@tanstack/virtual-file-routes': 1.162.0
      jiti: 2.7.0
      magic-string: 0.30.21
      prettier: 3.9.10
      zod: 4.6.7
    transitivePeerDependencies:
      - supports-color

  '@tanstack/router-plugin@1.168.46(@tanstack/react-router@1.170.44(react-dom@19.3.1(react@19.3.1))(react@19.3.1))(rolldown@1.2.14)(vite@8.3.4(@types/node@22.20.5)(jiti@2.7.0))':
    dependencies:
      '@babel/core': 7.29.7
      '@babel/template': 7.29.7
      '@babel/types': 7.29.8
      '@tanstack/router-core': 1.171.37
      '@tanstack/router-generator': 1.167.44
      '@tanstack/router-utils': 1.162.4
      chokidar: 5.0.0
      unplugin: 3.4.0(rolldown@1.2.14)(vite@8.3.4(@types/node@22.20.5)(jiti@2.7.0))
      zod: 4.6.7
    optionalDependencies:
      '@tanstack/react-router': 1.170.44(react-dom@19.3.1(react@19.3.1))(react@19.3.1)
      vite: 8.3.4(@types/node@22.20.5)(jiti@2.7.0)
    transitivePeerDependencies:
      - '@farmfe/core'
      - '@rspack/core'
      - bun-types-no-globals
      - esbuild
      - rolldown
      - rollup
      - supports-color
      - unloader

  '@tanstack/router-utils@1.162.4':
    dependencies:
      '@babel/generator': 7.29.8
      '@babel/parser': 7.29.9
      '@babel/types': 7.29.8
      ansis: 4.4.0
      babel-dead-code-elimination: 1.0.12
      diff: 9.0.0
      pathe: 2.0.3
      tinyglobby: 0.2.17
    transitivePeerDependencies:
      - supports-color

  '@tanstack/start-client-core@1.170.37':
    dependencies:
      '@tanstack/router-core': 1.171.37
      '@tanstack/start-fn-stubs': 1.162.0
      '@tanstack/start-storage-context': 1.167.39
      seroval: 1.6.9

  '@tanstack/start-fn-stubs@1.162.0': {}

  '@tanstack/start-plugin-core@1.171.53(@tanstack/react-router@1.170.44(react-dom@19.3.1(react@19.3.1))(react@19.3.1))(rolldown@1.2.14)(vite@8.3.4(@types/node@22.20.5)(jiti@2.7.0))':
    dependencies:
      '@babel/code-frame': 7.29.7
      '@babel/core': 7.29.7
      '@babel/types': 7.29.8
      '@jridgewell/remapping': 2.3.5
      '@tanstack/router-core': 1.171.37
      '@tanstack/router-generator': 1.167.44
      '@tanstack/router-plugin': 1.168.46(@tanstack/react-router@1.170.44(react-dom@19.3.1(react@19.3.1))(react@19.3.1))(rolldown@1.2.14)(vite@8.3.4(@types/node@22.20.5)(jiti@2.7.0))
      '@tanstack/router-utils': 1.162.4
      '@tanstack/start-server-core': 1.169.43
      exsolve: 1.1.3
      lightningcss: 1.33.0
      pathe: 2.0.3
      picomatch: 4.0.7
      seroval: 1.6.9
      source-map: 0.7.6
      srvx: 1.0.5
      tinyglobby: 0.2.17
      ufo: 1.6.4
      vitefu: 1.1.3(vite@8.3.4(@types/node@22.20.5)(jiti@2.7.0))
      xmlbuilder2: 4.0.3
      zod: 4.6.7
    optionalDependencies:
      vite: 8.3.4(@types/node@22.20.5)(jiti@2.7.0)
    transitivePeerDependencies:
      - '@farmfe/core'
      - '@rspack/core'
      - '@tanstack/react-router'
      - bun-types-no-globals
      - esbuild
      - rolldown
      - rollup
      - supports-color
      - unloader
      - vite-plugin-solid
      - webpack

  '@tanstack/start-server-core@1.169.43':
    dependencies:
      '@tanstack/history': 1.162.5
      '@tanstack/router-core': 1.171.37
      '@tanstack/start-client-core': 1.170.37
      '@tanstack/start-storage-context': 1.167.39
      cookie-es: 3.1.1
      fetchdts: 0.2.0
      seroval: 1.6.9

  '@tanstack/start-storage-context@1.167.39':
    dependencies:
      '@tanstack/router-core': 1.171.37

  '@tanstack/store@0.11.2': {}

  '@tanstack/virtual-file-routes@1.162.0': {}

  '@types/chai@5.2.3':
    dependencies:
      '@types/deep-eql': 4.0.2
      assertion-error: 2.0.1

  '@types/d3-array@3.2.2': {}

  '@types/d3-color@3.1.3': {}

  '@types/d3-ease@3.0.2': {}

  '@types/d3-interpolate@3.0.4':
    dependencies:
      '@types/d3-color': 3.1.3

  '@types/d3-path@3.1.1': {}

  '@types/d3-scale@4.0.9':
    dependencies:
      '@types/d3-time': 3.0.4

  '@types/d3-shape@3.2.0':
    dependencies:
      '@types/d3-path': 3.1.1

  '@types/d3-time@3.0.4': {}

  '@types/d3-timer@3.0.2': {}

  '@types/deep-eql@4.0.2': {}

  '@types/estree@1.0.9': {}

  '@types/node@22.20.5':
    dependencies:
      undici-types: 6.21.0

  '@types/react-dom@19.3.0(@types/react@19.3.0)':
    dependencies:
      '@types/react': 19.3.0

  '@types/react@19.3.0':
    dependencies:
      csstype: 3.2.3

  '@types/use-sync-external-store@0.0.6': {}

  '@vitejs/plugin-react@6.1.2(vite@8.3.4(@types/node@22.20.5)(jiti@2.7.0))':
    dependencies:
      '@rolldown/pluginutils': 1.0.1
      vite: 8.3.4(@types/node@22.20.5)(jiti@2.7.0)

  '@vitest/mocker@5.0.5(vite@8.3.4(@types/node@22.20.5)(jiti@2.7.0))':
    dependencies:
      '@jridgewell/trace-mapping': 0.3.31
      '@vitest/spy': 5.0.5
      estree-walker: 3.0.3
      magic-string: 1.4.3
    optionalDependencies:
      vite: 8.3.4(@types/node@22.20.5)(jiti@2.7.0)

  '@vitest/spy@5.0.5': {}

  ansis@4.4.0: {}

  argparse@2.0.1: {}

  assertion-error@2.0.1: {}

  babel-dead-code-elimination@1.0.12:
    dependencies:
      '@babel/core': 7.29.7
      '@babel/parser': 7.29.9
      '@babel/traverse': 7.29.10
      '@babel/types': 7.29.8
    transitivePeerDependencies:
      - supports-color

  baseline-browser-mapping@2.11.29: {}

  browserslist@4.29.3:
    dependencies:
      baseline-browser-mapping: 2.11.29
      caniuse-lite: 1.0.30001816
      electron-to-chromium: 1.5.458
      node-releases: 2.0.59
      update-browserslist-db: 1.3.4(browserslist@4.29.3)

  cac@7.1.0: {}

  caniuse-lite@1.0.30001816: {}

  chai@6.3.0: {}

  chokidar@5.0.0:
    dependencies:
      readdirp: 5.1.1

  clsx@2.1.1: {}

  consola@3.4.2: {}

  convert-source-map@2.0.0: {}

  cookie-es@3.1.1: {}

  crossws@0.4.15(srvx@0.11.22):
    optionalDependencies:
      srvx: 0.11.22

  csstype@3.2.3: {}

  d3-array@3.2.4:
    dependencies:
      internmap: 2.0.3

  d3-color@3.1.0: {}

  d3-ease@3.0.1: {}

  d3-format@3.1.2: {}

  d3-interpolate@3.0.1:
    dependencies:
      d3-color: 3.1.0

  d3-path@3.1.0: {}

  d3-scale@4.0.2:
    dependencies:
      d3-array: 3.2.4
      d3-format: 3.1.2
      d3-interpolate: 3.0.1
      d3-time: 3.1.0
      d3-time-format: 4.1.0

  d3-shape@3.2.0:
    dependencies:
      d3-path: 3.1.0

  d3-time-format@4.1.0:
    dependencies:
      d3-time: 3.1.0

  d3-time@3.1.0:
    dependencies:
      d3-array: 3.2.4

  d3-timer@3.0.1: {}

  db0@0.3.4(@electric-sql/pglite@0.5.11):
    optionalDependencies:
      '@electric-sql/pglite': 0.5.11

  debug@4.4.3:
    dependencies:
      ms: 2.1.3

  decimal.js-light@2.5.1: {}

  detect-libc@2.1.2: {}

  diff@9.0.0: {}

  electron-to-chromium@1.5.458: {}

  env-runner@0.1.16:
    dependencies:
      crossws: 0.4.15(srvx@0.11.22)
      exsolve: 1.1.3
      httpxy: 0.5.5
      srvx: 0.11.22

  es-module-lexer@2.3.2: {}

  es-toolkit@1.52.0: {}

  escalade@3.2.0: {}

  estree-walker@3.0.3:
    dependencies:
      '@types/estree': 1.0.9

  eventemitter3@5.0.4: {}

  expect-type@1.4.0: {}

  exsolve@1.1.3: {}

  fdir@6.5.0(picomatch@4.0.7):
    optionalDependencies:
      picomatch: 4.0.7

  fetchdts@0.2.0: {}

  fsevents@2.3.3:
    optional: true

  gensync@1.0.0-beta.2: {}

  h3@2.0.1-rc.22(crossws@0.4.15(srvx@0.11.22)):
    dependencies:
      rou3: 0.8.1
      srvx: 0.11.22
    optionalDependencies:
      crossws: 0.4.15(srvx@0.11.22)

  hookable@6.1.2: {}

  httpxy@0.5.5: {}

  immer@11.1.21: {}

  internmap@2.0.3: {}

  isbot@5.2.2: {}

  jiti@2.7.0: {}

  js-tokens@4.0.0: {}

  js-yaml@4.3.2:
    dependencies:
      argparse: 2.0.1

  jsesc@3.1.0: {}

  json5@2.2.3: {}

  lightningcss-android-arm64@1.33.0:
    optional: true

  lightningcss-darwin-arm64@1.33.0:
    optional: true

  lightningcss-darwin-x64@1.33.0:
    optional: true

  lightningcss-freebsd-x64@1.33.0:
    optional: true

  lightningcss-linux-arm-gnueabihf@1.33.0:
    optional: true

  lightningcss-linux-arm64-gnu@1.33.0:
    optional: true

  lightningcss-linux-arm64-musl@1.33.0:
    optional: true

  lightningcss-linux-x64-gnu@1.33.0:
    optional: true

  lightningcss-linux-x64-musl@1.33.0:
    optional: true

  lightningcss-win32-arm64-msvc@1.33.0:
    optional: true

  lightningcss-win32-x64-msvc@1.33.0:
    optional: true

  lightningcss@1.33.0:
    dependencies:
      detect-libc: 2.1.2
    optionalDependencies:
      lightningcss-android-arm64: 1.33.0
      lightningcss-darwin-arm64: 1.33.0
      lightningcss-darwin-x64: 1.33.0
      lightningcss-freebsd-x64: 1.33.0
      lightningcss-linux-arm-gnueabihf: 1.33.0
      lightningcss-linux-arm64-gnu: 1.33.0
      lightningcss-linux-arm64-musl: 1.33.0
      lightningcss-linux-x64-gnu: 1.33.0
      lightningcss-linux-x64-musl: 1.33.0
      lightningcss-win32-arm64-msvc: 1.33.0
      lightningcss-win32-x64-msvc: 1.33.0

  lru-cache@5.1.1:
    dependencies:
      yallist: 3.1.1

  magic-string@0.30.21:
    dependencies:
      '@jridgewell/sourcemap-codec': 1.6.0

  magic-string@1.4.3:
    dependencies:
      '@jridgewell/sourcemap-codec': 1.6.0

  ms@2.1.3: {}

  nanoid@3.3.20: {}

  nf3@0.3.24: {}

  nitro@3.0.260610-beta(@electric-sql/pglite@0.5.11)(chokidar@5.0.0)(jiti@2.7.0)(vite@8.3.4(@types/node@22.20.5)(jiti@2.7.0)):
    dependencies:
      consola: 3.4.2
      crossws: 0.4.15(srvx@0.11.22)
      db0: 0.3.4(@electric-sql/pglite@0.5.11)
      env-runner: 0.1.16
      h3: 2.0.1-rc.22(crossws@0.4.15(srvx@0.11.22))
      hookable: 6.1.2
      nf3: 0.3.24
      ocache: 0.1.5
      ofetch: 2.0.0-alpha.3
      ohash: 2.0.12
      rolldown: 1.2.14
      srvx: 0.11.22
      unenv: 2.0.0-rc.24
      unstorage: 2.0.0-alpha.7(chokidar@5.0.0)(db0@0.3.4(@electric-sql/pglite@0.5.11))(ofetch@2.0.0-alpha.3)
    optionalDependencies:
      jiti: 2.7.0
      vite: 8.3.4(@types/node@22.20.5)(jiti@2.7.0)
    transitivePeerDependencies:
      - '@azure/app-configuration'
      - '@azure/cosmos'
      - '@azure/data-tables'
      - '@azure/identity'
      - '@azure/keyvault-secrets'
      - '@azure/storage-blob'
      - '@capacitor/preferences'
      - '@deno/kv'
      - '@electric-sql/pglite'
      - '@libsql/client'
      - '@netlify/blobs'
      - '@netlify/runtime'
      - '@planetscale/database'
      - '@upstash/redis'
      - '@vercel/blob'
      - '@vercel/functions'
      - '@vercel/kv'
      - aws4fetch
      - better-sqlite3
      - chokidar
      - drizzle-orm
      - idb-keyval
      - ioredis
      - lru-cache
      - miniflare
      - mongodb
      - mysql2
      - sqlite3
      - uploadthing
      - wrangler

  node-releases@2.0.59: {}

  obug@3.0.0: {}

  ocache@0.1.5:
    dependencies:
      ohash: 2.0.12

  ofetch@2.0.0-alpha.3: {}

  ohash@2.0.12: {}

  pathe@2.0.3: {}

  picocolors@1.1.1: {}

  picomatch@4.0.7: {}

  playwright-core@1.64.1: {}

  postcss@8.5.30:
    dependencies:
      nanoid: 3.3.20
      picocolors: 1.1.1
      source-map-js: 1.2.2

  postgres@3.4.9: {}

  prettier@3.9.10: {}

  react-dom@19.3.1(react@19.3.1):
    dependencies:
      react: 19.3.1
      scheduler: 0.28.0

  react-is@19.3.1: {}

  react-redux@9.3.0(@types/react@19.3.0)(react@19.3.1)(redux@5.0.1):
    dependencies:
      '@types/use-sync-external-store': 0.0.6
      react: 19.3.1
      use-sync-external-store: 1.7.0(react@19.3.1)
    optionalDependencies:
      '@types/react': 19.3.0
      redux: 5.0.1

  react@19.3.1: {}

  readdirp@5.1.1: {}

  recharts@3.10.1(@types/react@19.3.0)(react-dom@19.3.1(react@19.3.1))(react-is@19.3.1)(react@19.3.1)(redux@5.0.1):
    dependencies:
      '@reduxjs/toolkit': 2.13.0(react-redux@9.3.0(@types/react@19.3.0)(react@19.3.1)(redux@5.0.1))(react@19.3.1)
      clsx: 2.1.1
      decimal.js-light: 2.5.1
      es-toolkit: 1.52.0
      eventemitter3: 5.0.4
      immer: 11.1.21
      react: 19.3.1
      react-dom: 19.3.1(react@19.3.1)
      react-is: 19.3.1
      react-redux: 9.3.0(@types/react@19.3.0)(react@19.3.1)(redux@5.0.1)
      reselect: 5.2.0
      tiny-invariant: 1.3.3
      use-sync-external-store: 1.7.0(react@19.3.1)
      victory-vendor: 37.3.6
    transitivePeerDependencies:
      - '@types/react'
      - redux

  redux-thunk@3.1.0(redux@5.0.1):
    dependencies:
      redux: 5.0.1

  redux@5.0.1: {}

  reselect@5.2.0: {}

  rolldown@1.2.14:
    dependencies:
      '@oxc-project/types': 0.154.0
      '@rolldown/pluginutils': 1.0.1
    optionalDependencies:
      '@rolldown/binding-android-arm-eabi': 1.2.14
      '@rolldown/binding-android-arm64': 1.2.14
      '@rolldown/binding-darwin-arm64': 1.2.14
      '@rolldown/binding-darwin-x64': 1.2.14
      '@rolldown/binding-freebsd-x64': 1.2.14
      '@rolldown/binding-linux-arm-gnueabihf': 1.2.14
      '@rolldown/binding-linux-arm64-gnu': 1.2.14
      '@rolldown/binding-linux-arm64-musl': 1.2.14
      '@rolldown/binding-linux-ppc64-gnu': 1.2.14
      '@rolldown/binding-linux-s390x-gnu': 1.2.14
      '@rolldown/binding-linux-x64-gnu': 1.2.14
      '@rolldown/binding-linux-x64-musl': 1.2.14
      '@rolldown/binding-openharmony-arm64': 1.2.14
      '@rolldown/binding-win32-arm64-msvc': 1.2.14
      '@rolldown/binding-win32-x64-msvc': 1.2.14

  rou3@0.8.1: {}

  scheduler@0.28.0: {}

  semver@6.3.1: {}

  seroval-plugins@1.6.9(seroval@1.6.9):
    dependencies:
      seroval: 1.6.9

  seroval@1.6.9: {}

  source-map-js@1.2.2: {}

  source-map@0.7.6: {}

  srvx@0.11.22: {}

  srvx@1.0.5: {}

  std-env@4.3.0: {}

  tiny-invariant@1.3.3: {}

  tinybench@6.2.2: {}

  tinyexec@1.3.1: {}

  tinyglobby@0.2.17:
    dependencies:
      fdir: 6.5.0(picomatch@4.0.7)
      picomatch: 4.0.7

  typescript@6.0.3: {}

  ufo@1.6.4: {}

  undici-types@6.21.0: {}

  unenv@2.0.0-rc.24:
    dependencies:
      pathe: 2.0.3

  unplugin@3.4.0(rolldown@1.2.14)(vite@8.3.4(@types/node@22.20.5)(jiti@2.7.0)):
    dependencies:
      '@jridgewell/remapping': 2.3.5
      picomatch: 4.0.7
      webpack-virtual-modules: 0.6.2
    optionalDependencies:
      rolldown: 1.2.14
      vite: 8.3.4(@types/node@22.20.5)(jiti@2.7.0)

  unstorage@2.0.0-alpha.7(chokidar@5.0.0)(db0@0.3.4(@electric-sql/pglite@0.5.11))(ofetch@2.0.0-alpha.3):
    optionalDependencies:
      chokidar: 5.0.0
      db0: 0.3.4(@electric-sql/pglite@0.5.11)
      ofetch: 2.0.0-alpha.3

  update-browserslist-db@1.3.4(browserslist@4.29.3):
    dependencies:
      browserslist: 4.29.3
      escalade: 3.2.0
      picocolors: 1.1.1

  use-sync-external-store@1.7.0(react@19.3.1):
    dependencies:
      react: 19.3.1

  victory-vendor@37.3.6:
    dependencies:
      '@types/d3-array': 3.2.2
      '@types/d3-ease': 3.0.2
      '@types/d3-interpolate': 3.0.4
      '@types/d3-scale': 4.0.9
      '@types/d3-shape': 3.2.0
      '@types/d3-time': 3.0.4
      '@types/d3-timer': 3.0.2
      d3-array: 3.2.4
      d3-ease: 3.0.1
      d3-interpolate: 3.0.1
      d3-scale: 4.0.2
      d3-shape: 3.2.0
      d3-time: 3.1.0
      d3-timer: 3.0.1

  vite@8.3.4(@types/node@22.20.5)(jiti@2.7.0):
    dependencies:
      lightningcss: 1.33.0
      picomatch: 4.0.7
      postcss: 8.5.30
      rolldown: 1.2.14
      tinyglobby: 0.2.17
    optionalDependencies:
      '@types/node': 22.20.5
      fsevents: 2.3.3
      jiti: 2.7.0

  vitefu@1.1.3(vite@8.3.4(@types/node@22.20.5)(jiti@2.7.0)):
    optionalDependencies:
      vite: 8.3.4(@types/node@22.20.5)(jiti@2.7.0)

  vitest@5.0.5(@types/node@22.20.5)(vite@8.3.4(@types/node@22.20.5)(jiti@2.7.0)):
    dependencies:
      '@types/chai': 5.2.3
      '@vitest/mocker': 5.0.5(vite@8.3.4(@types/node@22.20.5)(jiti@2.7.0))
      chai: 6.3.0
      es-module-lexer: 2.3.2
      expect-type: 1.4.0
      magic-string: 1.4.3
      obug: 3.0.0
      picomatch: 4.0.7
      std-env: 4.3.0
      tinybench: 6.2.2
      tinyexec: 1.3.1
      tinyglobby: 0.2.17
      vite: 8.3.4(@types/node@22.20.5)(jiti@2.7.0)
      why-is-node-running: 3.2.1
    optionalDependencies:
      '@types/node': 22.20.5
    transitivePeerDependencies:
      - msw

  webpack-virtual-modules@0.6.2: {}

  why-is-node-running@3.2.1: {}

  xmlbuilder2@4.0.3:
    dependencies:
      '@oozcitak/dom': 2.0.2
      '@oozcitak/infra': 2.0.2
      '@oozcitak/util': 10.0.0
      js-yaml: 4.3.2

  yallist@3.1.1: {}

  zod@4.6.7: {}
