davixcky/medidor-energia-esp32/herramientas/sexpr.py

"""Lector y escritor mínimo de expresiones S (formato de archivos KiCad)."""
import re

_TOKEN = re.compile(r'\s*(?:(\()|(\))|("(?:[^"\\]|\\.)*")|([^\s()"]+))')


class Sym(str):
    """Átomo sin comillas (palabra clave o número)."""


def parse(text):
    stack, cur = [], []
    pos = 0
    while True:
        m = _TOKEN.match(text, pos)
        if not m or m.end() == pos:
            break
        pos = m.end()
        lp, rp, s, atom = m.groups()
        if lp:
            stack.append(cur)
            cur = []
        elif rp:
            done = cur
            cur = stack.pop()
            cur.append(done)
        elif s is not None:
            cur.append(s[1:-1].replace('\\n', '\n').replace('\\"', '"').replace('\\\\', '\\'))
        else:
            cur.append(Sym(atom))
    return cur


def dump(node, indent=0):
    if isinstance(node, list):
        if not node:
            return "()"
        simple = all(not isinstance(x, list) for x in node)
        if simple:
            return "(" + " ".join(dump(x) for x in node) + ")"
        pad = "\t" * (indent + 1)
        head = []
        rest = []
        for x in node:
            (rest if (isinstance(x, list) or rest) else head).append(x)
        out = "(" + " ".join(dump(x) for x in head)
        for x in rest:
            out += "\n" + pad + dump(x, indent + 1)
        return out + "\n" + "\t" * indent + ")"
    if isinstance(node, Sym):
        return str(node)
    if isinstance(node, (int, float)):
        return fmt(node)
    return '"' + str(node).replace('\\', '\\\\').replace('"', '\\"').replace('\n', '\\n') + '"'


def fmt(v):
    if isinstance(v, int):
        return str(v)
    s = f"{v:.4f}".rstrip("0").rstrip(".")
    return "0" if s in ("-0", "") else s


def find(node, key):
    return [x for x in node if isinstance(x, list) and x and x[0] == key]


def find1(node, key):
    r = find(node, key)
    return r[0] if r else None
