davixcky/medidor-energia-esp32/(commit log)

2026-10-16 Medidor de energía de dos canales con ESP32: documento del avance 2, hardware, firmware, plataforma y pronóstico
    Incluye el documento del corte 2 (README), esquemáticos y placa en KiCad, simulación en
    ngspice, modelos 3D en FreeCAD, firmware del ESP32 (PlatformIO), plataforma web en
    TanStack Start con backend y simulador, y el LSTM inicial de pronóstico.
2026-10-16 Simplificar el banco de medición: clavija, lazo de fase para la pinza y un tomacorriente
    El banco queda en lo mínimo: se enchufa a la pared, la fase sale de la caja en un lazo
    aislado donde se cierra la pinza y el equipo se conecta en un tomacorriente doble.
    Se eliminan el breaker, el piloto, la toma auxiliar, la segunda pinza y los conectores.
    Actualizados el esquemático de KiCad, el dibujo, el modelo de FreeCAD, las vistas y el
    documento. Corrige también las referencias plurales a ilustraciones que quedaron sin numerar.
2026-10-21 PCB de una cara para fabricar por tóner y gabinete ajustado a ella
    - herramientas/generar_pcb.py: PCB de 150 × 90 mm con cobre solo abajo, ruteada con
    Freerouting (4 puentes de alambre), relleno de GND y agujeros M3; DRC sin conexiones
    pendientes ni diferencias con el esquemático
    - herramientas/exportar_fabricacion.sh: PDF 1:1 para tóner, Gerber, taladros, guía de
    montaje, lista de puentes, vistas 3D y STEP
    - freecad: cables hasta los pads reales (conectores.json), jacks y USB alineados con la PCB,
    tornillos M3, rótulos con tildes y vistas del medidor en Blender
    - Documento: sección 7.7 (PCB y alternativa en placa perforada), materiales, cronograma,
    dificultades y anexo; dia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
2026-10-21 Plataforma sobre Supabase, esquemáticos sin datos personales y redacción revisada
    - plataforma: Postgres en Supabase con postgres.js (DATABASE_URL) en lugar de SQLite;
    migración en supabase/migrations con RLS activo; ingesta por lotes en una transacción;
    pnpm db:migrar y .env.ejemplo; pruebas del servicio contra un Postgres de pruebas
    - Esquemáticos, PCB y figuras sin nombres ni referencias a asignaturas (revisión B)
    - Redacción del documento revisada para un tono más directo y sin exagerar el avance
2026-10-21 Explicación del LSTM: celda, ecuaciones, red sobre un día real y error por horizonte
    - pronostico/figuras_lstm.py genera las figuras con los pesos entrenados y los datos de UCI
    - Sección 7.15: funcionamiento de la celda, conteo de parámetros, ejemplo real y error por horizonte
    - Rango de temperatura de entrenamiento corregido (Barranquilla queda en el extremo alto, no fuera)
2026-10-21 Quitar el enlace local a .venv del repositorio
2026-10-22 LCD Waveshare de 1,9" (ST7789V2, SPI) y modo de demostración para Railway/Render
    - Firmware: pantallas en lib/interfaz sobre Adafruit GFX, dibujadas por franjas; energía por hora.
    - Las imágenes de las pantallas salen del mismo código compilado en el PC (make -C test pantallas).
    - Esquemático: J6 de 8 pines en el orden del DevKitC; se quitan R9 y R10 (pull-up del I2C).
    - PCB re-ruteada: 3 puentes, DRC sin conexiones pendientes; placa perforada verificada (25 redes).
    - Tapa con ventana para la LCD, diagrama de bloques, README y diagrama de navegación.
    - Plataforma: DEMO=1 corre con Postgres en memoria (PGlite) y datos del simulador; Dockerfile,
    railway.json y render.yaml.
2026-10-22 Puntos de prueba TP1–TP9 y LED de alimentación en la PCB
    - Lazos para la punta del osciloscopio en +5V, +3V3, VBIAS, CH1_ADC, CH2_ADC, ZMPT_OUT y V_ADC,
    y dos de GND; la serigrafía rotula la red de cada uno.
    - D9 (+5 V, R14 1 kΩ) y D10 (+3,3 V, R15 470 Ω).
    - PCB re-ruteada con 3 puentes; DRC sin errores ni conexiones pendientes; placa perforada con 27 redes.
    - README: tabla de valores esperados en cada punto y verificación antes de energizar con los TP.
2026-10-22 Vistas 3D: colores de los LED de alimentación y de los puntos de prueba en Blender
2026-10-22 Correcciones de la revisión del diseño
    - Firmware: la adquisición la despierta un temporizador de hardware (antes esperaba de forma activa
    y bloqueaba el arranque); eventos de Wi-Fi en el núcleo 0; tarea de adquisición creada al final.
    - Fase: historia de tensión de 8 muestras, corrección de −8° a +11° con fase del ZMPT101B y de cada
    pinza; calibración guardada en NVS desde la consola serie (comando cal).
    - Ventanas por cantidad de muestras cuando no hay cruces por cero (ZMPT101B desconectado).
    - Hardware: C5 y C6 vuelven a VBIAS (antes a GND, acoplaban los canales ~1 %); PCB re-ruteada con
    2 puentes; placa perforada y simulación actualizadas.
    - README: aislamiento del ZMP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
2026-10-22 PCB con las reglas del taller de CNC: pistas de 0,9 mm y 1 mm de separación
    - Pads de las filas de 2,54 mm a 1,5 × 2,4 mm para dejar 1 mm entre pads vecinos.
    - Freerouting sin adelgazar pistas en los pines y con 1,1 mm de separación de ruteo.
    - 10 puentes de alambre; DRC sin errores con mínimos de 1,0 mm y 0,9 mm en el proyecto.
2026-10-23 Añade encoder de configuración y gabinete magnético con NeoPixels y sonido
